GabrieleZoppoli/terrarium-control-system/analysis/README.md

# Terrarium PID Statistical Analysis

Statistical models of the PID-controlled highland cloud forest terrarium.
Generated 2026-02-18.

## Data

- Source: InfluxDB `highland` database, 5-minute aggregates
- Default window: last 14 days
- Run `./export_data.sh [days]` to refresh CSVs before re-running scripts

## Scripts

### 01_pid_humidity_model.py
Four OLS models of terrarium humidity:
- **Model 1**: Static OLS — humidity ~ fan_pwm + temp_in + temp_room + humi_room + freezer + mister
- **Model 2**: Enriched — adds temp_delta, hour, daytime, fan×freezer interaction
- **Model 3**: AR(1) dynamic — adds lagged humidity, computes long-run multipliers
- **Model 4**: First-difference (Δhumidity) — what drives humidity changes

Key finding: fan_pwm shows *positive* association with humidity due to PID simultaneity
(fans increase because humidity is high, not the other way around).

### 02_iv_causal_model.py
IV/2SLS model using Night A/B experiment as instrument:
- Instrument: day-of-year parity (even=fans off, odd=fans at 80 PWM)
- First-stage F=20.6 (strong instrument)
- **Causal estimate: +10 PWM → -0.37% humidity** (sign correctly flips vs OLS)
- Includes reduced-form, Wald estimator, and nightly aggregate comparison

### 03_ab_temperature.py
Night A/B effect on temperature (unadjusted):
- Raw comparison, nightly aggregates, regressions
- Hourly profiles, cooling rate analysis
- Key finding: fans accelerate evening cooling but raise late-night floor

### 04_ab_temperature_adjusted.py
Same as 03 but adjusted for room temperature and humidity:
- Hour-by-hour regressions with controls
- Residualized profiles
- Balance check on room conditions
- **Adjusted: evening cooling -0.75 to -1.4°C, late-night warming +0.3 to +0.55°C**

### heat_balance_rerun.py
Re-run of the heat-balance regression (2026-05-12) over the full 80.3-day
Meross-instrumented window (n=17,773, HC3 robust SEs). Supersedes the earlier
27-day coefficients. Canonical results in `paper/heat_balance_run_2026-05-12.yaml`:
compressor -1.01 °C/hr; passive room↔cabinet +0.17 °C/hr per K; continuous
fan PWM effect statistically null (p=0.33).

### wetbulb_analysis.py / deconvolution.py
Wet-bulb characterization and thermal deconvolution (2026-02-24). Establish the
~16.6 °C evaporative-cooling floor at room 22 °C / 58 % RH.

### cooling_test_report.py / cooling_test_publication.py
Maximum-cooling-capacity test reports (near-equilibrium 13.6 °C at room 21.6 °C,
Δ≈8.1 K; deepest 12.3 °C).

### publication_figures.py
Generates the HardwareX manuscript figures from InfluxDB into `../paper/figures/`:
24 h and 7 d environmental cycles, hour-of-day power profile + ECDF, PID humidity
tracking + fan response, the 11-layer safety-chain deployment timeline, and a
system connection (block) diagram (`fig1`–`fig6`). Uses only stdlib + numpy +
matplotlib; re-run any time. `fig6` is drawn from the documented architecture
(no InfluxDB) — a signal/power connection map, not a full electrical schematic.

**Note on the IV/2SLS coefficient:** the canonical (SoT-corrected) causal estimate
is **−0.34 % RH per +10 PWM** (95 % CI −0.68 to −0.005; p=0.047; n=1,353), per
`paper/stats_sot_2026-05-13.yaml`. The "−0.37 %" quoted under `02_iv_causal_model.py`
above is the original first-run value, retained here for script provenance; cite the
SoT value in any publication.

## Dependencies

```bash
pip3 install --break-system-packages pandas statsmodels linearmodels scipy
```

## Usage

```bash
cd ~/terrarium-analysis
./export_data.sh          # refresh data (optional days arg, default 14)
python3 01_pid_humidity_model.py
python3 02_iv_causal_model.py
python3 03_ab_temperature.py
python3 04_ab_temperature_adjusted.py
```

Results are saved in `results/` as text files.
