GabrieleZoppoli/terrarium-control-system/website/content/collection/species/calopogon-tuberosus/index.md

---
# AUTO-GENERATED — do not edit by hand.
# Rerun scripts/generate_species_pages.py after inventory changes.
# For rich prose, drop a body.md in this folder; the template appends it.
title: Calopogon tuberosus
taxon: Calopogon tuberosus
genus: Calopogon
species: tuberosus
provenance: Eastern North American sphagnum bogs
slug: calopogon-tuberosus
sources:
  - id: 30
    vendor: Gartenbau Carow
    acquired: May 2019
    price_eur: 38.8
    location: Balcony · outdoor
photos:
  - img/collection/calopogon/calopogon-tuberosus.jpg
primary_photo: img/collection/calopogon/calopogon-tuberosus.jpg
genus_page: /collection/genera/other-orchids/
---
