GabrieleZoppoli/terrarium-control-system/website/content/collection/species/pinguicula-laueana-crimson-flower/index.md

---
# AUTO-GENERATED — do not edit by hand.
# Rerun scripts/generate_species_pages.py after inventory changes.
# For rich prose, drop a body.md in this folder; the template appends it.
title: "Pinguicula laueana 'Crimson Flower'"
taxon: "Pinguicula laueana 'Crimson Flower'"
genus: Pinguicula
species: laueana
provenance: ""
slug: pinguicula-laueana-crimson-flower
sources:
  - id: 399
    vendor: Diflora
    acquired: Mar 2026
    price_eur: 13
    location: Fog shelves
photos:
  - img/collection/pinguicula/pinguicula-laueana-crimson-flower.jpg
primary_photo: img/collection/pinguicula/pinguicula-laueana-crimson-flower.jpg
genus_page: /collection/genera/pinguicula/
---
