GabrieleZoppoli/terrarium-control-system/website/content/collection/species/utricularia-quelchii/index.md

---
# AUTO-GENERATED — do not edit by hand.
# Rerun scripts/generate_species_pages.py after inventory changes.
# For rich prose, drop a body.md in this folder; the template appends it.
title: Utricularia quelchii
taxon: Utricularia quelchii
genus: Utricularia
species: quelchii
provenance: "Tepui cliffs, Venezuela — epiphytic Utricularia"
slug: utricularia-quelchii
sources:
  - id: 429
    vendor: Klein Carnivors
    acquired: Feb 2023
    price_eur: 38
    location: Highland cabinet
    notes: "Ilu Tepui provenance; currently flowering, April 2026"
photos:
  - img/collection/utricularia/utricularia-quelchii.jpg
primary_photo: img/collection/utricularia/utricularia-quelchii-15.jpg
genus_page: /collection/genera/utricularia/
---
