GabrieleZoppoli/terrarium-control-system/website/content/collection/species/tillandsia-love-knot/index.md

---
# AUTO-GENERATED — do not edit by hand.
# Rerun scripts/generate_species_pages.py after inventory changes.
# For rich prose, drop a body.md in this folder; the template appends it.
title: "Tillandsia 'Love Knot'"
taxon: "Tillandsia 'Love Knot'"
genus: Tillandsia
species: ""
provenance: ""
slug: tillandsia-love-knot
sources:
  - id: 436
    vendor: Le Figlie del Vento
    acquired: May 2026
    price_eur: 12.5
    location: ""
    notes: Orticola 2026 — cv hybrid (T. paucifolia × T. streptophylla) — bundle 50€/4 pz Camarda
photos:
  - img/collection/tillandsia/tillandsia-love-knot.jpg
primary_photo: img/collection/tillandsia/tillandsia-love-knot.jpg
genus_page: /collection/genera/tillandsia/
---
