GabrieleZoppoli/terrarium-control-system/website/content/collection/species/cymbidium-goeringii-tian-cao/body.md

## The cultivar

*Cymbidium goeringii* '**Tian Cao**' (天草, Japanese reading **Amakusa**) is a Japanese-line goeringii from the city of Amakusa in Kumamoto Prefecture. Compact habit, cream-margined foliage variegation that runs from edge to near the leaf tip, fragrant flowers — the variegation rule on goeringii is that any plant with leaf variegation will also produce flower variegation, so the spike colour is non-uniform.[^slippertalk]

Acquired at Orticola 2026 from **Marco Toffoletti / Piante Pazze** (stand 27) on 2026-05-09 — substituted on the day for the pre-ordered 'Da Tu Yuan' clone, which Marco didn't have in dividable shape that morning.

## Growing it

Goeringii is the picky Cymbidium. Two non-negotiables: **cold dormancy with vernalisation** and a **mineral / aerated substrate**.

- **Substrate.** Hyuga pumice ~50%, Kanuma ~30%, perlite + hard pumice ~20%. Particles graded by size — coarse at the bottom, fine at the surface, with a small mound around the pseudobulb base.[^aos]
- **Pot.** Translucent or asian-style tall-narrow lets you read the moisture front at each layer. Black plastic is fine functionally; translucent is the diagnostic upgrade.
- **Watering.** Soak the pot for ~10 s with a fine spray, then let the surface mound dry out before the next thorough water. Mist between thoroughs to keep the upper third damp without flushing through. No watering during freezing weather.[^aos]
- **Vernalisation.** From the winter solstice through bud development, hold the plant at **0–14 °C** for several weeks. *Without this cold period the buds blast.* This is the single most common reason cultivated goeringii never flower in mild climates.[^orchidboard]
- **Light.** As much sun as possible up to ~40 °C. Partial shade in summer if leaf scorch shows.
- **Air movement.** Continuous gentle airflow. Goeringii roots pack densely in pots and stagnant air invites fungal/bacterial rot at the base.[^aos]
- **Repotting.** Twice a year (spring before active growth; autumn for health check) is the Asian standard. Every two to three years works in milder regimes.[^aos]
- **Fertiliser.** Light, with the growth flush; off during dormancy.

## Why bother

The genus is large; this species is the one that earned a thousand-year cultivation tradition in China and Japan. Variegated cultivars like Tian Cao were prized in Edo-period Japan for the foliage as much as the flower, and the named-cultivar lineage continues today with strict provenance.

## References

- **AOS — *Cymbidium goeringii: Essential Tips for Success*.** [aos.org/orchids/articles/cymbidium-goeringii-essential-tips-for-success](https://www.aos.org/orchids/articles/cymbidium-goeringii-essential-tips-for-success). Substrate recipe, watering, vernalisation regime.
- **Slippertalk — *Cymbidium goeringii 'Tian Cao'*.** [slippertalk.com/threads/cymbidium-goeringii-tian-cao.36936](https://www.slippertalk.com/threads/cymbidium-goeringii-tian-cao.36936/). Cultivar-specific variegation pattern, fragrance notes.
- **Reddit — *r/orchids* "I got a little companion for my neofinetias"** (Italian-language thread, 2021). [reddit.com/r/orchids/.../oujzbe](https://www.reddit.com/r/orchids/comments/oujzbe/i_got_a_little_companion_for_my_neofinetias/). Italian grower notes on cabinet companion-planting with *Neofinetia*.
- **Orchid Board — *Cymbidium goeringii 'Tian Cao'*.** [orchidboard.com/.../67274-cymbidium-goeringii-tian-cao](http://www.orchidboard.com/community/cymbidium-alliance/67274-cymbidium-goeringii-tian-cao.html). Vernalisation specifics, cold-blast warning.

[^slippertalk]: Slippertalk Orchid Forum — *Cymbidium goeringii 'Tian Cao'*, thread #36936. The variegation-implies-flower-variegation rule, Amakusa origin.
[^aos]: American Orchid Society — *Cymbidium goeringii: Essential Tips for Success*. Substrate composition (50% Hyuga pumice / 30% Kanuma / 20% perlite + hard pumice), watering protocol, repotting cadence, air-circulation prescription.
[^orchidboard]: Orchid Board — *Cymbidium goeringii 'Tian Cao'*, cymbidium alliance forum. The 0–14 °C vernalisation period from winter solstice and the bud-blast failure mode without it.
