GabrieleZoppoli/terrarium-control-system/website/content/areas/_index.it.md

---
title: "Dove vivono"
description: "Le cinque aree di coltivazione: balcone, davanzale, ripiani nebulizzati, terrario d'alta quota e mini-stagni."
---

Cinque aree di coltivazione ospitano la collezione. Ognuna ha un suo intervallo di luce, temperatura e umidità, e quindi le sue piante.
