GabrieleZoppoli/terrarium-control-system/website/content/areas/_index.md

---
title: "Where they live"
description: "The five growing areas: balcony, windowsill, fog shelves, highland terrarium and mini-ponds."
---

Five growing areas host the collection. Each has its own range of light, temperature and humidity, and therefore its own plants.
