GabrieleZoppoli/terrarium-control-system/website/content/areas/windowsill.it.md

---
title: "Davanzale"
area_slug: "windowsill"
description: "Piante da interno amanti della luce sui davanzali: temperature stabili, umidità media."
---
