GabrieleZoppoli/terrarium-control-system/website/content/areas/windowsill.md

---
title: "Windowsill"
area_slug: "windowsill"
description: "Indoor light-loving species on windowsills: stable temperatures, moderate humidity."
---
