GabrieleZoppoli/terrarium-control-system/website/content/highland/docs/_index.md

---
title: "Technical Documentation"
description: "Architecture, schemas, PID controller, and flow guides"
showTableOfContents: true
---

Technical documentation for the terrarium control system: architecture, data schema, control algorithms and Node-RED flow structure.

## Contents

- **[Architecture](architecture/)**: system overview, hardware layers, communication protocols
- **[InfluxDB Schema](schema/)**: all 32 measurements logged by the system
- **[PID Controller](pid-controller/)**: gain-scheduled PID algorithm with three-regime fan control
- **[Node-RED Flows](flows/)**: flow import guide and tab-by-tab description
