GabrieleZoppoli/terrarium-control-system/website/content/inventions/zeer-pot-darlingtonia/index.it.md

---
title: "Zeer pot auto-annaffiante per Darlingtonia"
description: "Raffreddamento evaporativo passivo per la zona radicale della pianta cobra californiana"
status: "building"
layout: "zeer-pot"
weight: 10
tags: ["carnivora", "invenzione", "esp32"]
---

*Darlingtonia californica*, la pianta cobra californiana, vuole radici fredde e tollera aria calda. In habitat, sorgenti sotterranee mantengono il rizoma sotto i ~18 °C anche quando l'aria tocca i 30 °C. La soluzione classica da hobbista è un getto quotidiano di acqua fredda o cubetti di ghiaccio in estate, che fallisce il giorno in cui te ne dimentichi.

Uno Zeer pot (raffreddatore evaporativo a doppio vaso) fa quello che fa la sorgente: l'acqua che evapora dalla superficie esterna non smaltata sottrae calore alla camera interna. Con un serbatoio a ricarica autonoma, una coppia di termistori, una sonda capacitiva per l'umidità del terriccio e un ESP32-C3 SuperMini, l'assemblaggio funziona senza intervento per un mese di fila.

Il progetto completo (schizzi CAD, cablaggio, firmware, lista dei materiali, sequenza di costruzione) è qui sotto, come pagina autonoma nei colori del sito. Conviene aprirla a schermo intero.
