GabrieleZoppoli/terrarium-control-system/website/content/inventions/zeer-pot-darlingtonia/index.md

---
title: "Self-watering Zeer Pot for Darlingtonia"
description: "Passive evaporative cooling for the California Pitcher Plant's root zone"
status: "building"
layout: "zeer-pot"
weight: 10
tags: ["carnivorous", "invention", "esp32"]
---

*Darlingtonia californica*, the California pitcher plant, needs cold roots and tolerates warm air. In habitat, underground springs keep the rhizome below ~18 °C even when the air reaches 30 °C. The usual hobbyist solution is a daily flush of cold water or ice cubes in summer, which fails on the day you forget.

A Zeer pot (a pot-in-pot evaporative cooler) does what the spring does: water evaporating from an unglazed outer surface pulls heat out of the inner chamber. With a self-topping water reservoir, a pair of thermistors, a capacitive soil probe and an ESP32-C3 SuperMini, the assembly runs unattended for a month at a time.

The full project (CAD sketches, wiring, firmware, bill of materials, build sequence) is below, as a self-contained page in the site's colours. Open it full-screen for comfort.
