GabrieleZoppoli/terrarium-control-system/website/content/blog/first-bloom-utricularia-quelchii/index.md

---
title: "First bloom: Utricularia quelchii, three years in"
date: 2026-04-20
description: "A tepui bladderwort I've been growing since 2023 finally flowers, and I only notice by accident while checking the Sophronitis above it."
tags: ["utricularia", "terrarium", "flowering", "first-bloom"]
showReadingTime: true
---

I wasn't looking for it. Last week I was leaning into the highland cabinet to check on my *Sophronitis coccinea* hanging above, and through its roots I caught a thin red peduncle climbing out of the pot underneath. *Utricularia quelchii*. Three years in cultivation, steadily adding leaves and nothing else — until, suddenly, at least two buds, red-purple, the stem erect in that *reniformis* family posture but smaller and more hesitant.

{{< figure src="/img/collection/utricularia/utricularia-quelchii.jpg" caption="The first catch: two buds on the same erect peduncle, red-purple, framed against the cabinet wall between the *Sophronitis* roots hanging from above." >}}

{{< figure src="/img/collection/utricularia/utricularia-quelchii-2.jpg" caption="The larger of the two buds, closer in. The lower-lip sac is already well-formed; the colour is a dense red-purple against the cabinet's white wall." >}}

{{< figure src="/img/collection/utricularia/utricularia-quelchii-3.jpg" caption="The second bud, still small and pointed, sitting lower on the peduncle." >}}

{{< figure src="/img/collection/utricularia/utricularia-quelchii-6.jpg" caption="Both buds together on the same peduncle, pulled back to show the tangle of *Sophronitis* aerial roots they had to thread through." >}}

{{< figure src="/img/collection/sophronitis/sophronitis-coccinea-big-one-x-hinomaru-4n-gmwoc-2.jpg" caption="The *Sophronitis coccinea* 'Big One' × 'Hinomaru' 4N GM/WOC flower — the whole reason I was leaning into the cabinet last week." >}}

{{< figure src="/img/highland/interior/interior_2026-04-20_coccinea-bloom.jpg" caption="The whole frame: the *Sophronitis coccinea* is the red spot left-of-centre; the quelchii pot is nestled below it, half-hidden by its own sphagnum overflow. (Also filed on the [terrarium photo timeline](/highland/photos/).)" >}}

## How it got here

Early 2023, from Christian and Claudia Klein at **Carnivors & More**. The label read *Utricularia quelchii, Ilu Tepui*, and the Ilu tag was half the reason I ordered — tepui endemics with a clear cliff-of-origin are what draw me to the genus. It arrived looking exactly like what you'd expect from a bladderwort that evolved on a Guayana-highland summit: a handful of tear-drop leaves — already a couple of centimetres long including the petiole, which is large by bladderwort standards — a few white traps buried in live moss, and an attitude of *we'll see*. That attitude held for three years. The plant never died, the leaves grew slowly but steadily, and by last year the stolons had threaded through the entire pot.

## The setup (in case it's reproducible)

- **Container**: terracotta, perforated, 10 cm diameter.
- **Substrate**: live *Sphagnum* only. The moss has so completely occupied and overflowed the pot that it reads more as a kokedama than as a potted plant.
- **Position**: hanging on the back wall of the highland cabinet, mid-height, with nothing above it on the wall. The light is direct but not the brightest corner — the *Heliamphora* sit about 30 cm from the LED array, that's the full-sun tier; the quelchii is a step below. I'll add the actual lux once I can get the meter in.
- **Watering**: none from me. The pot sits directly under a mister nozzle and the live sphagnum stays evenly damp on its own. Foliar Akerne Orchid Mix at half a teaspoon per three litres, a couple of times a month.

The detail I find most interesting: the flower spike emerged not from the wetter body of the pot but from the driest 2 cm that sit against the cabinet wall. Whatever cue a *quelchii* needs to bloom, it may not be continuous saturation.

## Why I care

Deep-red flowers are rare in *Utricularia* and essentially a Pantepui specialty: *U. quelchii* and *U. campbelliana* sit alone at that end of the colour range within the section *Orchidioides*, both confined to the summit-mat bogs of Roraima, Ilu-Tramen, Wei, Chimantá, and neighbouring table-mountains of the Venezuelan Guayana Highlands ([Taylor, 1989](#references)). The other red one I have is *U. campbelliana*, also Ilu-sourced, also in live sphagnum, slow as hell for three years, also not yet in flower. The flower colour alone makes *quelchii* a collector's plant; the tear-drop leaves — large for the genus, and sometimes reddish themselves — are the second hook.

{{< figure src="/img/collection/utricularia/utricularia-quelchii-4.jpg" caption="Top-down over the pot. The dark teardrop on the sphagnum isn't a bud — it's one of those purple-tinged leaves, just about the darkest I have on the plant right now." >}}

{{< figure src="/img/collection/utricularia/utricularia-quelchii-5.jpg" caption="A macro of the same kind of leaf resting on the moss surface. The reddish pigmentation runs through the whole lamina; the texture of the live *Sphagnum* underneath gives the scale." >}}

I hadn't expected a bloom. The plant arrived with three or four leaves and now has many; the rosette slowly but steadily kept growing. But growth that stays pure vegetative starts to look like a contract — *I'll live here, I'll take up space, I won't flower*. Three years of that can be easy to accept. Turns out the plant had been setting up all along.

## What comes next

I'll update this post as the spike opens and once I can get a lux meter into that position to replace the eyeball estimate.

## Update — 2026-05-07: the first flower is open

Seventeen days from the first photos, the larger bud has opened and the section *Orchidioides* gestalt is unmistakable: a hooded galea above, a yellow-cream throat with two red callus blotches inside, and a broad lower lip that pales from the magenta of the hood to white-pink at the edges. The second bud is still closed, slightly below.

{{< figure src="/img/collection/utricularia/utricularia-quelchii-7.jpg" caption="The bud cracking open. The lower lip is just starting to peel away from the galea — the glossy red-purple is at peak saturation right before the corolla unfolds." >}}

{{< figure src="/img/collection/utricularia/utricularia-quelchii-10.jpg" caption="Side profile of the open flower. The galea forms a dark hood; the yellow-cream gullet is visible underneath, and the lower lip extends forward — the structure that mimics an orchid corolla closely enough to fool sphingid pollinators on the tepui summits." >}}

{{< figure src="/img/collection/utricularia/utricularia-quelchii-9.jpg" caption="Three-quarters view, with the second (still-closed) bud visible below. The yellow-cream of the throat is a clean contrast against the magenta hood and the cooler-pink lip." >}}

{{< figure src="/img/collection/utricularia/utricularia-quelchii-11.jpg" caption="Head-on. The two dark blotches inside the throat are the callus markings that section *Orchidioides* shares — they sit at the base of the column and presumably function as nectar guides." >}}

{{< figure src="/img/collection/utricularia/utricularia-quelchii-13.jpg" caption="Macro of the open face. The greenish column projects forward through the throat; the magenta venation on the lower lip catches the cabinet light." >}}

The plant is still in the same hanging position, same sphagnum kokedama, same mister nozzle overhead. Lux meter still pending. The colour is closer to cool magenta than the deep blood-red the photographs in Taylor (1989) hint at — possibly clone variation, possibly light-driven. I'll see whether the second bud opens darker or paler than the first.

## Update — 2026-05-11: both flowers open

Day 21. The second bud has caught up — both flowers are now face-out on the same scape. Colour is uniform across both: same magenta hood, same yellow-cream throat, same pink lower lip. No shift toward the deep red of the Roraima phenotype on the second flower; this clone is reliably Ilu pink.

{{< figure src="/img/collection/utricularia/utricularia-quelchii-14.jpg" caption="Both flowers open on the same scape. The kokedama and the surrounding cabinet planting are visible in the background." >}}

{{< figure src="/img/collection/utricularia/utricularia-quelchii-16.jpg" caption="Macro into the throat of the second flower. The yellow callus and column structure read identically to the first." >}}

## References

- **Taylor, P.** (1989). *The Genus Utricularia — A Taxonomic Monograph*. Kew Bulletin Additional Series XIV. Royal Botanic Gardens, Kew. The definitive treatment of the genus; the key to sect. *Orchidioides* (pp. 42–59) is where the *quelchii*/*campbelliana* characters live.
- **Fleischmann, A.** (2012). *Monograph of the genus Genlisea*. Redfern Natural History Productions. Not about *Utricularia* per se, but the accompanying material on Pantepui biogeography is useful context for the highland-epiphytic bladderworts.
- **Huber, O.** (1995). *Geographical and physical features of the Pantepui*, in: Berry, P.E., Holst, B.K., Yatskievych, K. (eds.), *Flora of the Venezuelan Guayana, Vol. 1*. St. Louis: Missouri Botanical Garden Press. On the tepui summit habitat the section *Orchidioides* species evolved in.
