GabrieleZoppoli/terrarium-control-system/website/content/collection/genera/dracula/index.md

---
title: "Dracula & Masdevallia"
description: "Cloud forest orchids from the Colombian and Ecuadorian Andes"
tags: ["orchid", "pleurothallidinae", "andes"]
genera: ["Dracula", "Masdevallia"]
ogImage: "img/collection/dracula/dracula-pholeodytes.jpg"
---

## Overview

*Dracula* and *Masdevallia* orchids inhabit the mossy cloud forests of the Colombian and Ecuadorian Andes at 1,500--2,500 m elevation. *Dracula* flowers, often face-like, hang from pendulous inflorescences that emerge below the mount; the mushroom-like lip attracts fungus gnats, which pollinate them.

## Position in Terrarium

**Lower zone**: shade, the lowest light in the cabinet. In nature they grow in the forest understorey under heavily filtered light.

## Mounting

Cork bark with a sphagnum moss pad. *Dracula* mounted with inflorescences able to hang freely below.

## Dracula

{{< collection-species "Dracula" >}}

## Masdevallia

{{< collection-species "Masdevallia" >}}

## Cultivation notes

*Dracula* has kept a perfect survival record (6/6) here, while *Masdevallia* sits at 71 % (5/7). The two losses, *M. glandulosa* and *M. coccinea* 'Anchota', were both plants from the warmer, lower edge of cloud forest; both struggled to make new growth under the terrarium's cool nights and were probably in the wrong place rather than badly grown. The rest live mounted on cork with a pad of living sphagnum and produce new leaves on a roughly three-month cycle.

Notes from provenance:

- **D. simia**: flowers singly on pendulous inflorescences that come down out of the sphagnum mat; the photographs on this site catch the flower as it drops through the mount.
- **D. lotax**: a very small cool grower, kept with the *Masdevallia* in the same zone.
- **D. Raven 'Jet'**: a hybrid of *D. vampira* × *D. roezlii*. Flowers very dark, almost black, with the white callus glands of *vampira* reduced.
- **D. "Fake" hirsuta 'Yellow'**: acquired as *hirsuta*, but the flower looks more like *hirsuta* f. *xanthina*. Kept as a label-uncertain accession until it flowers a second time.

Flowering is near-continuous across the group in autumn and winter, slows through summer, and does not respond much to anything I have tried. One consistent observation: *Masdevallia* spike production tracks the night minimum, not the daytime maximum. A 3 °C change in the overnight setpoint is worth more than twice that during the day.

## Photos

{{< collection-photos "Dracula" >}}

{{< collection-photos "Masdevallia" >}}
