GabrieleZoppoli/terrarium-control-system/website/content/collection/genera/platycerium/index.md

---
title: "Platycerium"
description: "Staghorn ferns (Platycerium, Polypodiaceae)"
tags: ["fern"]
genera: ["Platycerium"]
---

## Overview

Staghorn ferns (*Platycerium*, Polypodiaceae), epiphytes grown mounted.

## Species in Collection

{{< collection-species "Platycerium" >}}

## Photos

{{< collection-photos "Platycerium" >}}
