GabrieleZoppoli/terrarium-control-system/website/content/collection/genera/sophronitis/index.md

---
title: "Cattleya, Sophronitis & Laelia"
description: "Miniature rupicolous orchids from the Brazilian Atlantic Forest highlands"
tags: ["orchid", "cattleya", "sophronitis", "laelia", "brazil"]
genera: ["Cattleya", "Sophronitis", "Laelia"]
ogImage: "img/collection/sophronitis/sophronitis-coccinea-4n.jpg"
---

## Overview

The former genera *Sophronitis* and *Laelia* (now subsumed into *Cattleya* sensu lato) comprise miniature rupicolous (rock-dwelling) orchids from the highlands of the Brazilian Atlantic Forest, particularly the *campos rupestres* at 800--2,000 m. They are prized for their vivid red, orange, and yellow flowers on compact plants rarely exceeding 5 cm.

## Position in Terrarium

**Upper to middle zone**: moderate to high light. In nature these grow on exposed rock faces or as epiphytes on the windward side of stunted trees.

## Mounting

Cork bark mounts. The compact rosette habit and wiry roots adapt well to mounted culture.

## Cattleya

{{< collection-species "Cattleya" >}}

## Sophronitis

{{< collection-species "Sophronitis" >}}

## Laelia

{{< collection-species "Laelia" >}}

## Additional Brazilian Miniatures

| # | Taxon | Vendor | Price | Notes | Status |
|---|---|---|---|---|---|
| 1 | *Leptotes bicolor* | Orchideria di Morosolo | EUR 15.00 | Mounted | Alive |
| 2 | *Isabelia pulchella* | Varesina Orchidee | EUR 24.00 | Mounted | Alive |

**Total invested**: ~EUR 535

## Cultivation notes

Combined survival rate: 77 % (10 of 13). The double loss of *S. pygmaea*, the smallest species in the genus, points to a limit: the plant is too small and too slow to forgive a root-moisture error lasting 48 hours. The larger *Sophronitis* and all the *Cattleya*, including *S. coccinea* **f. aurea ('Atsumi' × 'Perfection'), an SM/JOGA selection from Japan**, have done well. *L. briegeri* was lost in transport (a CITES shipment from Ecuador that arrived already collapsed).

Flowering is reliable and heavy in autumn, often with a lighter second flush in spring. Colour saturation tracks the night minimum more than any other variable: the 'Atsumi' × 'Perfection' cross holds a deeper vermilion when kept three degrees cooler at night.

No dry rest is given, and none of the surviving plants have shown the spongy, hollow growth associated with over-watered *Sophronitis*, as long as air movement stays strong (a 24 V fan runs continuously at the top of the cabinet) and the cork mount goes from soaking to just-not-dripping between mist cycles.

## Photos

{{< collection-photos "Cattleya" >}}

{{< collection-photos "Sophronitis" >}}

{{< collection-photos "Laelia" >}}
