GabrieleZoppoli/terrarium-control-system/website/content/collection/genera/sphagnum/index.md

---
title: "Sphagnum"
description: "Living sphagnum moss: the ground layer in the terrarium and in the carnivorous-plant pots"
tags: ["moss", "companion"]
genera: ["Sphagnum"]
---

## Overview

Living moss layers in the terrarium and in carnivorous plant pots.

## Species in Collection

{{< collection-species "Sphagnum" >}}

## Photos

{{< collection-photos "Sphagnum" >}}
