GabrieleZoppoli/terrarium-control-system/paper/hardwarex.md

# Weather-Mimicking Terrarium for Cloud Forest Species: An Open-Source Climate Simulation System Using Real-Time Meteorological Data

**Authors**: Gabriele Zoppoli¹·² (ORCID: 0000-0002-1619-1708)

¹ Department of Internal Medicine and Medical Specialties (DiMI), University of Genoa, Genoa, Italy
² IRCCS Ospedale Policlinico San Martino, Genoa, Italy

**Corresponding author**: gabriele.zoppoli@unige.it

---

## Specifications Table

| | |
|---|---|
| **Hardware name** | Weather-Mimicking Biotope (WMB) — Cloud Forest Terrarium Controller |
| **Subject area** | Environmental science and ecology; Biological sciences (botany, conservation); Engineering (control systems) |
| **Hardware type** | Environmental monitoring and control |
| **Closest commercial analogue** | Terrarium controllers (MistKing HygroStat, TerraControl Pro); growth chambers (Percival, Conviron) |
| **Open-source license** | CERN Open Hardware Licence v2 — Strongly Reciprocal (CERN-OHL-S-2.0) |
| **Cost of hardware** | ≈ €2,865 (≈ US$3,050); itemised, mostly receipt-sourced BOM in §4 |
| **Source file repository** | GitHub: https://github.com/GabrieleZoppoli/terrarium-control-system; archival Zenodo DOI assigned at deposit |

---

## Abstract

We present the design, construction, and four-year validation of an open-source weather-mimicking terrarium system that simulates highland cloud-forest climates using real-time meteorological data. The system ingests current weather from four Colombian highland cities (1,300–2,600 m elevation) and applies a 15-hour backward lookup against the locally archived time-series to generate continuously varying temperature and humidity setpoints. Combined with the 7-hour Italy-to-Colombia time-zone offset, the shift produces a phase-aligned daily cycle in which Colombian afternoon highs drive cabinet warmth at Italian midday and Colombian pre-dawn lows drive cabinet cooling at Italian midnight — reproducing the stochastic weather of tropical montane environments without inverting the day/night cycle. The enclosure is a ~1 m³ acrylic cabinet (1.5 × 0.6 × 1.1 m), and a dynamic photoperiod derived from the Colombian reference latitude (~5°N) drives a raised-cosine LED schedule (Light Curve C, deployed 2026-05-04) that provides seasonally varying day length and a +23 % daily-integrated-PAR uplift over the prior step schedule. The control system — built entirely on open-source software (Node-RED, InfluxDB, Grafana) running on a Raspberry Pi with an Arduino Mega for hardware I/O — implements a two-regime PID fan-control strategy (humidity-driven below 24 °C, temperature-driven at or above 24 °C, with the temperature-driven regime persisting through compressor engagement so that fans continue to act as a ceiling-defence cooling actuator). An instrumental-variables (2SLS) characterisation of the fan-to-humidity loop quantifies the causal effect of fan PWM on cabinet humidity at −0.34 % RH per +10 PWM units (95 % CI: −0.68 to −0.005; p = 0.047; n = 1,353), and a heat-balance regression over 80.3 days at 5-min cadence (n = 17,773; HC3 robust SEs) attributes the cooling work to the marine compressor (−1.01 °C/hr when active) with fan PWM showing no statistically detectable sensible-heat effect. An eleven-layer safety chain, evolved reactively in response to specific in-production failure modes and audited against a three-class detector-fragility taxonomy (dependency-loop / state-desync / stale-input-latch), handles operator and hardware failure modes. The system has operated continuously since May 2022 (four years at time of writing) at a measured power draw of **2.63 kWh/day (~€288/year at €0.30/kWh)**, currently maintaining **75 living accessions across 31 plant genera** drawn from three biogeographic provinces of the convergent cloud-forest biome (Neotropical highlands: Guayanan tepui, Andes, Brazilian Atlantic Forest; Southeast Asian highlands; Papua New Guinea / Oceania). All design files, control flows, firmware, dashboards, and analysis scripts are released under the CERN Open Hardware Licence v2 Strongly Reciprocal (CERN-OHL-S-2.0). Live cabinet conditions, build photographs, and operational logs are maintained at a companion website [21] (citable Zenodo DOI assigned at deposit); companion papers describe the horticultural results for carnivorous plants [18] and orchids [19], and the conservation/freeware-flagship synthesis appears in [20].

**Keywords**: open-source hardware, cloud forest terrarium, weather simulation, PID control, instrumental variables, causal inference, Node-RED, environmental monitoring, Raspberry Pi

---

## 1. Hardware in Context

Highland cloud forests — particularly the tepui table-top mountains of the Guiana Highlands in Venezuela — harbor extraordinary plant diversity adapted to narrow environmental envelopes: cool temperatures (10–22 deg C), persistent high humidity (80–100% RH), frequent fog immersion, and moderate light filtered through clouds [1]. Cultivating these species outside their native range presents formidable challenges, especially in climates with hot, dry summers.

Traditional terrarium controllers rely on fixed environmental setpoints (e.g., 18 deg C day / 14 deg C night, 90% RH constant), which fail to capture the stochastic variability that characterizes cloud forest environments. Natural tepui climates exhibit weather-driven fluctuations: sudden temperature drops during rain events, diurnal fog cycles, and seasonal variation in cloud cover. Static control oversimplifies the environment and may fail to provide the thermal and humidity cues that cloud forest species require for phenological processes.

Commercial terrarium controllers such as the MistKing HygroStat and similar products provide basic hysteresis control of humidity and temperature, but none ingest real-time weather data to produce dynamic setpoints. At the other end of the spectrum, laboratory growth chambers (Percival, Conviron) offer precise environmental control at costs of EUR 10,000–50,000+, with proprietary software that limits customization and data access.

A number of open-source environmental control systems have been described in HardwareX and adjacent venues, providing relevant reference designs but stopping short of the weather-mimicking concept. McDowell et al. (2021) [4] describe an internet-connected temperature controller for plant-growth experiments, providing a clean open-hardware template for sensor + actuator + remote-management but with fixed-setpoint control. Lau & Subbiah (2020) [5] present HumidOSH, a self-contained environmental chamber with relative-humidity and fan-speed control, focused on a single bench-top humidity envelope rather than diurnal or weather-driven variation. Sánchez et al. (2020) [6] document OpenTCC, a low-cost open-source temperature-control chamber demonstrating that compressor or Peltier hardware can be controlled cleanly from an open stack, again with fixed setpoints. Yuan et al. (2022) [7] develop an IoT framework for feedback control of photosynthetic activity in *Arabidopsis* — the closest conceptual prior art, since it closes a control loop on a biological signal rather than a programmed schedule, but it does not ingest external weather data. Iucci et al. (2026) [8] describe a compact modular hydroponic greenhouse with environmental sensing and control, aimed at production rather than ex-situ conservation of native-climate species. Weather-informed control has a longer history in commercial horticulture — Chalabi et al. (1996) [22] generate optimal greenhouse heating setpoints from meteorological-office *forecasts*, and recent building-control work synthesises deliberately stochastic HVAC setpoint trajectories for dataset diversity [23] — but in both cases the external or synthetic data optimises operation against the cultivation site's *own* local climate rather than reconstructing the climate of a *remote* biome, and neither applies a time-zone phase correction. To our knowledge, **no published open-source system ingests real-time meteorological data from a geographically distinct reference site and applies a time-zone-aware phase shift to drive continuously varying environmental setpoints that reproduce a remote biome's diurnal climate envelope**, which is the gap the present design fills for terrarium-scale ex-situ conservation of cloud-forest taxa.

The system described here addresses this gap through six key innovations:

1. **Weather-mimicking from real meteorological data**: Real-time data from four Colombian highland cities generates stochastic, continuously varying setpoints that reproduce natural weather dynamics, including rain events and seasonal variation. When the live pipeline is stale (>10 min since last successful refresh), the controller transparently substitutes a 14-day rolling historical curve that itself is rebuilt every six hours from the InfluxDB archive, so the fallback follows seasonal drift without operator intervention.

2. **Two-regime PID fan control with ceiling-defence cooling**: The controller adapts its error signal based on cabinet temperature: humidity-driven below 24 °C, temperature-driven at or above 24 °C. The temperature-driven regime persists through compressor engagement — fans continue to act as an active ceiling-defence cooling actuator throughout the day even when the marine refrigerator is running, rather than being relinquished to the compressor.

3. **Causal characterisation of fan-mediated humidity control**: A randomised A/B fan-schedule experiment (n = 1,353 nighttime 5-min observations) enables an instrumental-variables (2SLS) estimate of the fan-PWM-to-humidity coefficient that is decorrelated from the PID's reaction to humidity disturbances. The companion 80.3-day heat-balance regression (n = 17,773; HC3) attributes essentially all the cooling work to the marine compressor and treats fan PWM as the humidity actuator — published quantification rather than a tuning heuristic.

4. **Dynamic photoperiod with raised-cosine LED schedule**: Day length is computed daily from the weather-source latitude, clamped to a biologically reasonable 10–14 h envelope, and bounds a raised-cosine LED brightness curve (Light Curve C, deployed 2026-05-04) centred on the source-latitude solar noon. Sinusoidal/raised-cosine diurnal light profiles are established good practice in controlled-environment horticulture — they approximate natural sunlight better than square-wave schedules and improve photosynthetic efficiency at equal daily light integral [24, 25]; the contribution here is not the curve shape but its derivation from the *weather-source* latitude and its integration with the weather-mimicking pipeline. The curve delivers a +23 % daily-integrated-PAR uplift over this system's prior step-schedule design and produces a smoother diurnal radiant load that the cooling chain can track without on/off transients at lights-on and lights-off.

5. **Eleven-layer safety chain with documented evolution + detector-fragility taxonomy**: Independent safety layers (door interlock, mister duration failsafe, freezer daytime gate, wet-bulb fan-off gate, manual-override timeout, USB-serial watchdog, LED-fault watchdog, power-vs-commanded cross-check, weather staleness fallback, Pi↔Arduino serial-link CRC integrity, mister water-level gate) accumulated over four years of operation in response to specific in-production failure modes. The deployment dates and incident provenance for each layer are recorded in a paper-bound single-source-of-truth YAML (`paper/safety_chain_deployment_dates.yaml`). A three-class detector-fragility taxonomy (dependency-loop, state-desync, stale-input-latch) audits each layer's failure modes against the others.

6. **Complete open-source stack**: All hardware and software components use freely available, commodity parts, making the system reproducible by hobbyists and small institutions. A live companion website (citable Zenodo DOI assigned at deposit) hosts current cabinet readings, photographic build documentation, and the operational blog.

---

## 2. Hardware Description

The Weather-Mimicking Biotope (WMB) is an acrylic terrarium with integrated cooling, humidification, lighting, and ventilation, controlled by a Raspberry Pi running Node-RED with an Arduino Mega for hardware I/O. The system continuously adjusts environmental conditions based on real-time weather data from Colombian highland cities, simulating the stochastic climate of tropical cloud forests.

Applications for researchers and educators include:

- **Ex-situ conservation**: Maintaining cloud-forest species from multiple biogeographic regions in a single enclosure, validated over four years with 75 living accessions across 31 plant genera from three biogeographic provinces (Neotropical highlands, Southeast Asian highlands, Papua New Guinea / Oceania)
- **Plant physiology studies**: Comprehensive data logging (33 InfluxDB measurements at 60-second intervals for continuous channels plus event-driven actuator-change logging; 3.1 million data points in the current 1-year retention window) enables analysis of plant responses to naturalistic environmental variation
- **Control systems education**: The system demonstrates PID control with gain scheduling, hysteresis control, multi-regime switching, instrumental-variables causal estimation of an actuator-to-state coupling, and a documented production-grade safety chain in an accessible, visual programming environment (Node-RED)
- **Template for other biomes**: The weather-mimicking architecture can be adapted to any biome by changing the reference weather stations (e.g., fog desert, alpine, lowland tropical) and the photoperiod-source latitude
- **Low-cost alternative to growth chambers**: Total hardware cost is a fraction of commercial growth chambers (€10,000–50,000+ for Percival/Conviron-class equipment), at a measured operational footprint of **2.63 kWh/day (~€288/year at €0.30/kWh)** for environmental control comparable to or superior to those instruments in this application class

---

## 3. Design Files Summary

| File name | File type | Open-source license | Location |
|---|---|---|---|
| `nodered/flows-sanitized.json` | Node-RED flow configuration | CERN-OHL-S-2.0 | GitHub repo; Zenodo at deposit |
| `firmware/arduino-terrarium.ino` | Arduino Mega firmware (C++) | CERN-OHL-S-2.0 | GitHub repo; Zenodo at deposit |
| `grafana/*.json` | Grafana dashboard exports (4 dashboards) | CERN-OHL-S-2.0 | GitHub repo; Zenodo at deposit |
| `scripts/arduino-watchdog.sh` | Serial watchdog script v10 (Bash) | CERN-OHL-S-2.0 | GitHub repo; Zenodo at deposit |
| `systemd/arduino-watchdog.service` | Systemd unit for the watchdog | CERN-OHL-S-2.0 | GitHub repo; Zenodo at deposit |
| `scripts/meross_daemon.py` | Meross MSS310 power-monitor daemon (Python, polled, publishes to MQTT + InfluxDB) | CERN-OHL-S-2.0 | GitHub repo; Zenodo at deposit |
| `systemd/meross-daemon.service` | Systemd unit for the Meross daemon | CERN-OHL-S-2.0 | GitHub repo; Zenodo at deposit |
| `scripts/terrarium-health.py` | Health-monitor cron script (Gmail + WhatsApp alerts; STUCK-RELAY auto-fix; LED-fault watchdog readout) | CERN-OHL-S-2.0 | GitHub repo; Zenodo at deposit |
| `scripts/mister-failsafe.py` | Mister cron failsafe (Tapo plug force-OFF if `on_time > 150 s`) | CERN-OHL-S-2.0 | GitHub repo; Zenodo at deposit |
| `scripts/snapshot-capture.sh` | Snapshot capture for the public companion-site mirror | CERN-OHL-S-2.0 | GitHub repo; Zenodo at deposit |
| `docs/schema.md` | InfluxDB measurement schema (33 measurements) | CERN-OHL-S-2.0 | GitHub repo; Zenodo at deposit |
| `docs/architecture.md` | System architecture documentation, including the layered safety chain | CERN-OHL-S-2.0 | GitHub repo; Zenodo at deposit |
| `docs/pid-controller.md` | PID algorithm documentation (gain schedule, anti-windup, manual-override semantics) | CERN-OHL-S-2.0 | GitHub repo; Zenodo at deposit |
| `analysis/*.py` | Analysis scripts (OLS heat-balance, IV/2SLS causal estimate, wet-bulb characterization, cooling-test reports) | CERN-OHL-S-2.0 | GitHub repo; Zenodo at deposit |
| `paper/energy_sot_*.yaml` | Single-source-of-truth block for the Meross-measured kWh figures cited throughout the manuscript | CERN-OHL-S-2.0 | GitHub repo; Zenodo at deposit |
| `S6-panel-drawings-*.docx` | Acrylic panel technical drawings | CERN-OHL-S-2.0 | GitHub repo; Zenodo at deposit |

**flows-sanitized.json**: Complete Node-RED flow configuration (~435 nodes across 7 tabs) with credentials removed. Covers all control logic: weather integration, PID fan control with two-regime switching, wet-bulb gate, dynamic photoperiod with Light Curve C, door safety, regime-aware mister hysteresis with water-level gate, data logging, and dashboard UI.

**arduino-terrarium.ino**: Custom text-based serial protocol firmware for Arduino Mega 2560. Handles PWM output on 5 channels (25 kHz phase-correct on Timers 1 and 5), door reed switch inputs with interrupt-based reading, heartbeat generation, and status reporting.

**Grafana dashboards**: Four monitoring dashboards — primary operational (temperature, humidity, VPD, actuator status), Colombian weather reference, system performance (PID diagnostics, fan PWM), and A/B experiment historical reference.

**scripts/arduino-watchdog.sh**: Watchdog v10 script monitoring USB connection health at 15-second intervals with four-step health checks and USB sysfs reset recovery.

**scripts/meross_daemon.py**: Long-running Python daemon that polls the Meross MSS310 in-line energy meter (variable cadence 2–120 s) and publishes power readings via MQTT into InfluxDB. Coexists with the older `meross_script.py` (single-shot variant, retained for compatibility); production deployments should use the daemon.

**scripts/terrarium-health.py**: Cron-driven (every 5 min) health monitor that cross-checks Tapo commanded state against Meross measured power, raises green/yellow/red conditions to Gmail + WhatsApp, runs the STUCK-RELAY auto-fix when the freezer is drawing power while commanded off, and reads the NR LED-fault flag. Includes N-sample hysteresis (3 polls) and a 120 s freezer-transition window to suppress poll-skew false positives. Credentials are placeholders in the published file.

**scripts/mister-failsafe.py**: Independent of Node-RED, runs every minute, force-commands the mister Tapo plug OFF if the plug's reported `on_time` exceeds 150 s. Last-resort guard against water damage from a controller hang or stuck relay.

**analysis/**: Python scripts for the published analyses, including the OLS heat-balance regression, the IV/2SLS causal estimate of the fan effect on humidity, the wet-bulb temperature characterization, and the maximum-cooling-capacity test reports.

**Acrylic panel drawings**: Original fabrication specifications for all structural panels (20 panels + 6 triangles + 2022 add-on set) with dimensions, hole positions, and material callouts.

---

## 4. Bill of Materials

> **BOM status (2026-06).** Component names, quantities, descriptions, and material types were cross-checked against §2 Hardware Description and §5 Build Instructions; costs and suppliers were then reconstructed from the author's e-mail order archive. Receipt-confirmed prices are given as exact figures with the vendor and order month; items without a recovered digital receipt (the locally-sourced enclosure materials in §4.6 and four small commodity electronics) are marked "(est.)" and use retail estimates. Per-subsection provenance notes follow each table, and a consolidated cost summary with the total appears after §4.7.

### 4.1 Control Electronics

| Component | Qty | Description | Unit cost | Total cost | Source | Material type |
|---|---|---|---|---|---|---|
| Raspberry Pi 4 Model B (8 GB) | 1 | Main controller (acquired as a starter kit incl. 128 GB microSD, PSU, case, fan) | €153.98 | €153.98 | Amazon.it, 2021-01 | Electronics |
| Arduino Mega 2560 (clone, CP210x USB) | 1 | GPIO interface | €18 (est.) | €18 | retail estimate | Electronics |
| ESP8266 (NodeMCU, ESP-12F) | 1 | Sensor data acquisition | €6.00 | €6.00 | Amazon.it, 2022-05 (3-pack €17.99) | Electronics |
| Sensirion SHT35 (waterproof probe) | 1 | Temperature/humidity sensor | €32.29 | €32.29 | Amazon.it, 2022-01 | Electronics |
| HC-SR04P ultrasonic sensor | 1 | Water level monitoring | €5 (est.) | €5 | retail estimate | Electronics |
| IRF520N MOSFET driver module | 4 | Fan power switching | €1.40 | €5.60 | Amazon.it, 2020-11 (10-pack €13.99) | Electronics |
| Magnetic reed switch | 2 | Door sensors | €3 (est.) | €6 | retail estimate | Electronics |
| TP-Link Tapo P100 smart plug | 3 | Mains switching (lights, mister, compressor) | €9.90 | €29.70 | Amazon.it, 2021-12 | Electronics |
| Meross MSS310 smart plug | 1 | Energy monitoring | €37.22 | €37.22 | Amazon.it, 2024-01 | Electronics |
| MicroSD card (128 GB) | 1 | Pi storage | — | (bundled in Pi kit) | Amazon.it, 2021-01 | Electronics |
| USB hub (powered) | 1 | Arduino + ESP connections | €20 (est.) | €20 | retail estimate | Electronics |

*§4.1 provenance:* all prices except the four small commodity items (Arduino Mega clone, HC-SR04P, reed switches, USB hub) are receipt-confirmed from the author's order history. The Raspberry Pi was acquired as an 8 GB starter kit (board + 128 GB microSD + PSU + case + fan, €153.98), so the microSD is bundled rather than a separate line. The 8 GB board is confirmed against the running hardware (`Raspberry Pi 4 Model B Rev 1.4`, 8 GB). ESP8266 and IRF520N unit prices are derived from confirmed multi-pack orders.

### 4.2 Lighting

| Component | Qty | Description | Unit cost | Total cost | Source | Material type |
|---|---|---|---|---|---|---|
| ChilLED Logic Puck V3 (100 W) | 4 | LED grow light modules (244x Samsung LM301B) | €55 | €220 | Rapid LED, 2019-11 | Electronics |
| 140 mm aluminium pin heatsink | 4 | Passive thermal management | €18 | €72 | Rapid LED, 2019-11 | Metal |
| 12 V axial fan (heatsink cooling) | 4 | Convective heatsink cooling | €10 (est.) | €40 | retail estimate | Electronics |
| Mean Well HLG-320H-48B LED driver | 1 | 320 W, 48 V, 3-in-1 dimming, IP65/IP67 | €106.99 | €106.99 | Conrad, 2022-03 | Electronics |

*§4.2 provenance:* the ChilLED Logic Puck V3 modules and 140 mm pin heatsinks were purchased from Rapid LED (order 2019-11) at US$58 / ≈ €55 per puck and US$19 / ≈ €18 per heatsink; the original order covered eleven units, of which four are installed in this build, so the BOM lists and prices the four installed. **The LED driver is a Mean Well HLG-320H-48B (320 W constant-voltage, 48 V, 3-in-1 dimmable), receipt-confirmed (Conrad, 2022-03, €106.99) — corrected here from an earlier "HLG-480H-48A (480 W)" placeholder, which was never receipt-sourced. A 320 W driver is consistent with the four 100 W pucks held to a ≈60 % hardware ceiling (≈240 W nominal) and with the measured ≈220 W midday LED-only draw reported in §7.1.** The four small 12 V heatsink fans are a retail estimate.

### 4.3 Cooling

| Component | Qty | Description | Unit cost | Total cost | Source | Material type |
|---|---|---|---|---|---|---|
| Vitrifrigo ND50 OR2-V compressor unit | 1 | BD50F Danfoss variable-speed, R134a (HFC, ODP=0, GWP₁₀₀≈1430); factory-sealed, no F-gas certification required for installation | €745 (incl. evaporator) | €745 | Ryan Energia, 2021-01 | Mechanical |
| Vitrifrigo PT14 evaporator plate | 1 | 1220 x 280 mm stainless steel | — | (bundled with compressor) | Ryan Energia, 2021-01 | Metal |
| Noctua NF-F12 iPPC-2000 IP67 (120 mm, 2000 RPM, 12 V) | 5 | Evaporator plate fans (x3) + circulation fans (x2) | €38.07 | €190.35 | Amazon.it, 2023-01 | Electronics |
| Noctua NF-A12x25 PWM (120 mm, 12 V) | 2 | Condenser radiator fans in push-pull configuration | €29.89 | €59.78 | Amazon.it, 2022-05 | Electronics |
| Plexiglas plate | 1 | Evaporator airflow plate, inclined 30 deg with slit below | — | (incl. §4.6 acrylic order) | local fabricator | Plastic |

*§4.3 provenance:* the Vitrifrigo ND50 OR2-V cooling unit and PT14 evaporator plate were a single €745 invoice (Ryan Energia S.r.l.s., PayPal, January 2021) — the highest single line in the BOM. The Noctua NF-F12 iPPC-2000 IP67 unit price (€38.07) is receipt-confirmed for a 2-fan order; the five-fan line total applies that confirmed unit price. The condenser fans are Noctua NF-A12x25 PWM (2 × €29.89, 2022-05); the "G2" suffix used in earlier drafts is dropped, as the purchase predates the NF-A12x25 G2 release.

### 4.4 Humidification

| Component | Qty | Description | Unit cost | Total cost | Source | Material type |
|---|---|---|---|---|---|---|
| MistKing Standard diaphragm pump (24 V) | 1 | Misting system pump (in complete system order) | €381.70 (system) | €381.70 | mistking.com, 2021-01 | Mechanical |
| MistKing nozzle assemblies | ~20 | Quad (x1), double (x6), single (x4) | — | €120.72 (add-on order) | mistking.com, 2022-10 | Plastic/metal |
| ZipDrip anti-drip valve | 1 | Prevents residual dripping | — | (incl. MistKing orders) | mistking.com | Plastic |
| Tubing and fittings | 1 set | MistKing-compatible | — | (incl. MistKing orders) | mistking.com | Plastic |

*§4.4 provenance:* the misting hardware came in two receipt-confirmed MistKing (Jungle Hobbies Ltd.) orders — the initial complete system (order #3477, €381.70, January 2021: pump, nozzles, ZipDrip, tubing) and a later nozzle/tubing add-on (order #3911, €120.72, October 2022) — for a combined €502.42.

### 4.5 Ventilation

| Component | Qty | Description | Unit cost | Total cost | Source | Material type |
|---|---|---|---|---|---|---|
| Noctua NF-A6x25 FLX (60 mm, 12 V) | 2 | Outlet ventilation fan (×1, pin 45) + impeller ventilation fan (×1, pin 46), rear ventilation ports per §2.2 | €14.90 | €29.80 | Amazon.it, 2022-02 | Electronics |

*§4.5 provenance:* the two 60 mm ventilation fans are receipt-confirmed Noctua NF-A6x25 FLX (2 × €14.90, 2022-02).

### 4.6 Enclosure

| Component | Qty | Description | Unit cost | Total cost | Source | Material type |
|---|---|---|---|---|---|---|
| Clear acrylic (PMMA) 10 mm | ~2 m^2 | Floor, back wall, side panels, inner back | — | see note | local fabricator | Plastic |
| Clear acrylic (PMMA) 8 mm | ~1 m^2 | Sliding doors, shelf, support tracks | — | see note | local fabricator | Plastic |
| Clear acrylic (PMMA) 5 mm | ~0.5 m^2 | Shelf lips, brackets, triangles | — | see note | local fabricator | Plastic |
| Silver mirror acrylic 2 mm | ~0.5 m^2 | Reflective panels (x5 + add-ons) | — | see note | local fabricator | Plastic |
| Black acrylic 4 mm | ~0.5 m^2 | Light-blocking baffles (add-on set) | — | see note | local fabricator | Plastic |
| Perforated acrylic (Square 15) 3 mm | ~0.5 m^2 | Ventilation grilles, shelf floor | — | see note | local fabricator | Plastic |
| XPS insulation (1 cm) | ~2 m^2 | Exterior thermal insulation | — | see note | hardware store | Foam |
| Diamond Mylar reflective sheeting | ~2 m^2 | Laminated to XPS insulation | — | see note | hardware store | Plastic/foil |
| Dichloromethane (DCM) | ~100 mL | Solvent welding (use with ventilation!) | — | see note | hardware store | Chemical |
| Crystalline silicone sealant (c-Si) | 1 tube | Joint sealing (NOT acetoxy silicone) | — | see note | hardware store | Chemical |
| Aluminium alloy scaffold | 1 | 2.20 x 3.20 x 0.50 m, ~300 kg | — | see note | metal supplier | Metal |
| Aluminium alloy guides | 2 | Sliding door tracks | — | see note | metal supplier | Metal |

*§4.6 provenance:* the enclosure materials were sourced locally in Genoa — laser-cut acrylic panels (PMMA 10/8/5 mm, mirror 2 mm, black 4 mm, perforated 3 mm, plus the §4.3 Plexiglas evaporator plate) from a custom fabricator; XPS insulation, Diamond Mylar, dichloromethane, and crystalline silicone from hardware stores; the aluminium scaffold and door guides from a metal supplier. These purchases (2021–2022) are documented by paper/in-person receipts not present in the digital order record, so per-line prices are not individually reconstructed. The aggregate enclosure-and-structure materials cost is estimated at **€450–600**; the midpoint (≈€525) is carried into the Specifications-Table total.

### 4.7 Reservoirs and Plumbing

| Component | Qty | Description | Unit cost | Total cost | Source | Material type |
|---|---|---|---|---|---|---|
| 40-liter reservoir | 2 | Misting supply + condensate collection | €30 (est.) | €60 | retail estimate | Plastic |

*§4.7 provenance:* the two 40-L food-grade reservoirs are commodity items without a recovered digital receipt; €30 each is a retail estimate.

---

**BOM cost summary.** Subsection totals (build-installed quantities): control electronics ≈ €314; lighting ≈ €439; cooling ≈ €995; humidification ≈ €502; ventilation ≈ €30; enclosure and structure ≈ €525 (estimated midpoint, see §4.6); reservoirs ≈ €60. **Total hardware cost ≈ €2,865 (≈ US$3,050).** Of this, roughly €2,190 is receipt-confirmed from the author's digital order history (the Vitrifrigo cooling unit, ChilLED pucks and heatsinks, Mean Well driver, all Noctua fans, MistKing system, Raspberry Pi kit, SHT35, Tapo and Meross plugs, ESP8266, IRF520N modules), and the remainder (≈€675) is estimated for items without a recovered digital receipt — the locally-sourced enclosure/acrylic/scaffold materials (§4.6) and four small commodity electronics (Arduino Mega clone, HC-SR04P, reed switches, powered USB hub) and the reservoirs. Estimated lines are flagged "(est.)" in the tables above. The cost remains one to two orders of magnitude below a commercial growth chamber of comparable volume (§7.7).

*Provenance note for reviewers:* costs were reconstructed in June 2026 from the author's e-mail order archive. The component identities and quantities were verified against §2 and §5 independently of cost. Two corrections arose from the receipt reconstruction and are reflected above: the LED driver is a **Mean Well HLG-320H-48B (320 W)**, not a 480 W unit, and the controller is a **Raspberry Pi 4 Model B (8 GB)** acquired as a starter kit (the 8 GB board is confirmed against the running hardware).

---

## 5. Build Instructions

### 5.1 Enclosure Construction

#### 5.1.1 Material Selection and Cutting

Select acrylic (PMMA) as the enclosure material based on its superior transparency, low weight, ease of modification, and lower cost compared to tempered glass or polycarbonate. Order laser-cut panels according to the specifications in the Design Files (panel drawings). Laser cutting is strongly recommended over circular-saw cutting, as the edge smoothness is critical for successful solvent welding.

Material properties comparison:

| Property | Tempered Glass | Polycarbonate | Acrylic (PMMA) |
|---|---|---|---|
| Transparency | Good | ~88% | Highest |
| Thermal conductivity | Variable | 0.19–0.22 W/mK | 0.19–0.22 W/mK |
| Impact resistance | Low | Excellent (200x glass) | Moderate |
| Weight | Heaviest | Medium | Lightest |
| Machinability | Non-drillable | Easy | Easy |
| Fire resistance | Fireproof | Good | Combustible |
| UV/yellowing | Good | Yellows over time | Good long-term |
| Cost | Highest | Medium | Lowest |

#### 5.1.2 Panel Fabrication

The enclosure requires 20 laser-cut panels plus 6 structural triangles (see Design Files S6 for full specifications). The main structural panels are:

- **Floor** (1x): 145 x ~55 cm, 10 mm clear acrylic
- **Back wall** (1x): 145 x ~115 cm, 10 mm clear acrylic, with 2x 12 cm ventilation holes and 2x 2 cm cable pass-throughs
- **Inner back / shelf support** (1x): 145 x 115 cm, 10 mm clear acrylic
- **Side panels** (2x): 49 x 115 cm, 10 mm clear acrylic, with notches for door guides and ventilation holes
- **Sliding front doors** (2x): 73.5 x 94.6 cm, 8 mm clear acrylic
- **Bottom rails** (2x): 145 x 10 cm, 20 mm clear acrylic

Internal components include perforated shelf panels (8 mm, Square 15 pattern), shelf support brackets (5 mm), and corner reinforcement triangles (5 mm). Reflective panels (2 mm silver mirror acrylic) and the 2022 add-on set (black light baffles, additional perforated grilles) complete the panel set.

#### 5.1.3 Assembly

1. **Dry-fit all panels** to verify dimensions before solvent welding. Laser-cut edges should mate precisely.

2. **Solvent weld using dichloromethane (DCM)**:
   - Work in a well-ventilated area. DCM is volatile and toxic (possible carcinogen).
   - Apply DCM to the joint with a syringe or applicator bottle — capillary action draws it into the seam.
   - The weld sets within seconds and produces a monolithic bond.
   - **Critical**: DCM permanently stains acrylic on contact. Protect all visible surfaces with masking tape.

3. **Seal joints with crystalline silicone (c-Si)** after DCM welding for watertightness. **Never use acetoxy silicone (a-Si)** — it releases acetic acid that corrodes and permanently stains acrylic.

4. **Flood test**: Fill the completed enclosure with ~30 liters of water and leave for one week to verify watertightness before installing any hardware.

5. **Apply exterior insulation**: Laminate 1 cm XPS panels with diamond Mylar reflective sheeting and attach to the exterior of the back wall, side panels, and floor. Exterior placement leaves interior surfaces smooth for cleaning and maximizes usable volume.

6. **Install sliding door guides**: Attach aluminium alloy guides with c-Si adhesive for the two front sliding panels.

The full panel geometry needed to reproduce the enclosure — every cut panel with its dimensions and hole positions — is provided as the acrylic panel drawings in the Design Files (`S6-panel-drawings-original.docx` and `S6-panel-drawings-addon-2022.docx`; per-panel layout figures are also mirrored on the project website under `highland/build/`). Build-era interior photographs of the assembled enclosure are on the website (`highland/interior/`, including the 2022 build-era frame). A step-by-step photographic sequence of the solvent-welding process is an optional enrichment; because the enclosure is a one-off solvent-welded assembly, the panel drawings plus the written steps above are what enable reproduction.

#### 5.1.4 Drainage

Tilt the floor panel slightly toward a rear drainage hole. The shelf below the terrarium hosts three items: the MistKing diaphragm pump, a 40-liter water reservoir feeding the pump, and a 40-liter condensate collection tank receiving gravity drainage from the evaporator plate above.

### 5.2 Hardware Assembly

#### 5.2.1 Lighting Installation

1. Mount four ChilLED Logic Puck V3 modules on 140 mm aluminium pin heatsinks above the terrarium enclosure. The pucks and heatsinks reside above the enclosure so their thermal output does not contribute to the internal heat load.

2. Mount 12 V axial fans above each heatsink for supplementary convective cooling.

3. Wire the four pucks in parallel to the Mean Well HLG-320H-48B LED driver (320 W, 48 V constant-voltage, 3-in-1 dimmable, IP65/IP67). The 320 W rating comfortably supplies the four 100 W pucks held to the ≈60 % hardware ceiling (≈240 W nominal).

4. Adjust the Mean Well driver's internal potentiometer to limit maximum output to approximately 60% of rated power. This hardware ceiling provides a fail-safe: even if the software erroneously commands 100% brightness, the LEDs cannot exceed ~60%, protecting shade-adapted species.

5. Connect the driver's analog dimming input to the Arduino's PWM pin 8. Note that lower PWM values produce brighter output (the driver dims proportionally to the PWM signal).

6. Wire the driver's mains input through a TP-Link Tapo P100 smart plug (for on/off scheduling).

#### 5.2.2 Cooling System Installation

The Vitrifrigo ND50 is a split-system marine refrigeration unit shipped pre-charged with R134a (HFC, ozone-depletion potential = 0, GWP₁₀₀ ≈ 1430) in a sealed circuit; no F-gas handling certification is required for installation. The compressor and condenser are mounted external to the cooled space, with refrigerant lines connecting them through a sealed pass-through to a separate evaporator plate inside. The compressor unit sits above the terrarium, and the evaporator plate is mounted **horizontally on the rear wall in the lower portion of the enclosure** (cutout centred at ~20 cm above the cabinet floor — see back-panel drawing `panel-03-with-radiator` in the Design Files). This is mechanical refrigeration — not evaporative cooling.

Marine refrigeration is a distinct hardware category from the better-known DIY compressor-cooling routes (chest-freezer conversions, aquarium chillers, modified portable air conditioners) and three replicator-relevant properties recommend it for terrarium use: (i) **installation is mechanical, not refrigeration work** — the unit ships as a complete factory-assembled split system, so no field plumbing of the cold loop and no system charging is required; (ii) **the unit class scales to enclosure size** — Vitrifrigo and equivalent marine-refrigeration vendors offer compressor/evaporator combinations spanning roughly 30–200 L cold-storage capacity with several evaporator plate footprints, so terraria between ~0.3 m³ and ~3 m³ can be matched without custom engineering; (iii) **factory-sealed pre-charged loop = no F-gas certification needed for installation** under EU/UK rules (the certification requirement applies to filling or topping up the refrigerant, not to installing a sealed unit), removing a skills barrier that has historically restricted DIY compressor-based terrarium cooling. Repairs on the cold loop *do* require certification — a faulty unit is replaced or serviced by a marine-refrigeration shop rather than user-repaired.

The low evaporator placement establishes a desirable vertical climate gradient inside the cabinet. Cold (and therefore dense) air sinking from the evaporator plate pools near the cabinet floor and rises by convection as it warms, while the LEDs are mounted above the cabinet. The result is **a warmer, brighter upper canopy and a cooler, shadier floor** — the inverse-stratified arrangement reproduces the natural moss-and-bryophyte zonation found near the base of cloud forest trunks and rocks.

1. Place the Vitrifrigo ND50 OR2-V compressor unit on a frame or shelf above the terrarium, with adequate clearance for the condenser radiator and fans to exhaust heat away from the enclosure.

2. Mount the Vitrifrigo PT14 evaporator plate horizontally on the inside of the rear wall, with the upper face of the plate ~20 cm above the cabinet floor. Route the refrigerant lines from the compressor through a sealed pass-through in the top panel. Ensure the evaporator's condensate drain leads, via gravity, to the condensate reservoir on the shelf below the terrarium.

3. Mount a plexiglas baffle in front of the evaporator plate, inclined approximately 30° from horizontal. Leave a slit between the lower edge of the baffle and the cabinet floor so that the cold air sinking off the evaporator is channelled downward and discharged at floor level.

4. Evenly space three Noctua NF-F12 iPPC-2000 IP67 fans on the plexiglas baffle, oriented to draw warm interior air across the evaporator surface.

5. Mount two additional Noctua NF-F12 iPPC-2000 IP67 fans separately within the cabinet for general internal circulation.

6. Mount two Noctua NF-A12x25 G2 fans in push-pull configuration on the compressor's condenser radiator fins (not Arduino-controlled; these run whenever the compressor unit is powered).

7. Wire the compressor's mains input through a TP-Link Tapo P100 smart plug (for on/off control).

#### 5.2.3 Humidification System Installation

1. Install the MistKing Standard pump below the terrarium, connected to the 40-liter misting reservoir.

2. Route MistKing tubing through a cable pass-through to the terrarium ceiling.

3. Install the nozzle array: one quad-nozzle assembly, six double-nozzle assemblies, and four single nozzles distributed across the ceiling for even fog coverage (~20 nozzle points total).

4. Install a ZipDrip anti-drip valve on the main supply line.

5. Wire the MistKing pump's power through a TP-Link Tapo P100 smart plug (for on/off control).

#### 5.2.4 Fan Wiring

Wire each fan group through an IRF520N MOSFET driver module:

| Fan group | MOSFET gate → Arduino pin | Fan supply voltage | Purpose |
|---|---|---|---|
| Evaporator fans (3x Noctua NF-F12 iPPC-2000) | Pin 44 (Timer 5) | 12 V | Airflow across evaporator plate |
| Outlet fan (Noctua 60 mm) | Pin 45 (Timer 5) | 12 V | Exhaust humid air |
| Impeller fan (Noctua 60 mm) | Pin 46 (Timer 5) | 12 V | Draw external air in |
| Circulation fans (2x Noctua NF-F12 iPPC-2000) | Pin 12 (Timer 1) | 12 V | Internal air movement |

**Important**: Do not connect the Arduino PWM output to the fans' 4-pin PWM inputs when driving multiple fans per channel. The MOSFET module switches the power rail instead, eliminating inter-fan signal interference. For single-fan configurations, direct 4-pin PWM connection with a 220 ohm series resistor per fan is acceptable.

#### 5.2.5 Sensor Installation

1. Connect the SHT35 sensor to the ESP8266. Position the sensor at mid-canopy height (~50 cm above floor), roughly centered in the enclosure.

2. Mount the HC-SR04P ultrasonic sensor above the misting reservoir for water level monitoring.

3. Wire two magnetic reed switches to Arduino digital inputs D22 (left door) and D24 (right door) — the Arduino's internal pull-up resistors are enabled in firmware.

### 5.3 Electronics Wiring

#### 5.3.1 Arduino Mega Pin Assignments

| Pin | Type | Function | Notes |
|---|---|---|---|
| 8 | PWM output | Light dimmer | Standard PWM; lower value = brighter |
| 12 | PWM output | Circulation fans | Timer 1, 25 kHz phase-correct (OC1B) |
| 44 | PWM output | Evaporator fans | Timer 5, 25 kHz phase-correct (OC5C) |
| 45 | PWM output | Outlet fan | Timer 5, 25 kHz phase-correct (OC5B) |
| 46 | PWM output | Impeller fan | Timer 5, 25 kHz phase-correct (OC5A) |
| A0 | Analog input | Heartbeat signal | Watched by serial watchdog |
| D22 | Digital input | Left door reed switch | INPUT_PULLUP |
| D24 | Digital input | Right door reed switch | INPUT_PULLUP |

#### 5.3.2 Power Distribution

- **Mains (230 V AC)**: Through 3x Tapo P100 smart plugs → LED driver, MistKing pump, compressor
- **48 V DC**: Mean Well driver → 4x ChilLED pucks
- **12 V DC**: All internal Noctua fans (NF-F12 iPPC-2000 evaporator + circulation, 60 mm outlet + impeller, NF-A12x25 condenser push/pull). The IRF520N MOSFET modules switch the 12 V power rail at 25 kHz; the fans' own 4-pin PWM inputs are left unconnected. Heatsink-fan supply (4× 12 V axial above the LED pucks) shares the same rail.
- **24 V DC**: MistKing diaphragm pump only.
- **12 V DC**: Separate supply → Outlet/impeller fans (via MOSFET modules), heatsink fans
- **5 V DC**: Raspberry Pi USB → Arduino Mega, ESP8266

**Safety**: All electrical lines running near or above the terrarium must incorporate drip loops (U-shaped cable routing below connection points) to prevent water ingress.

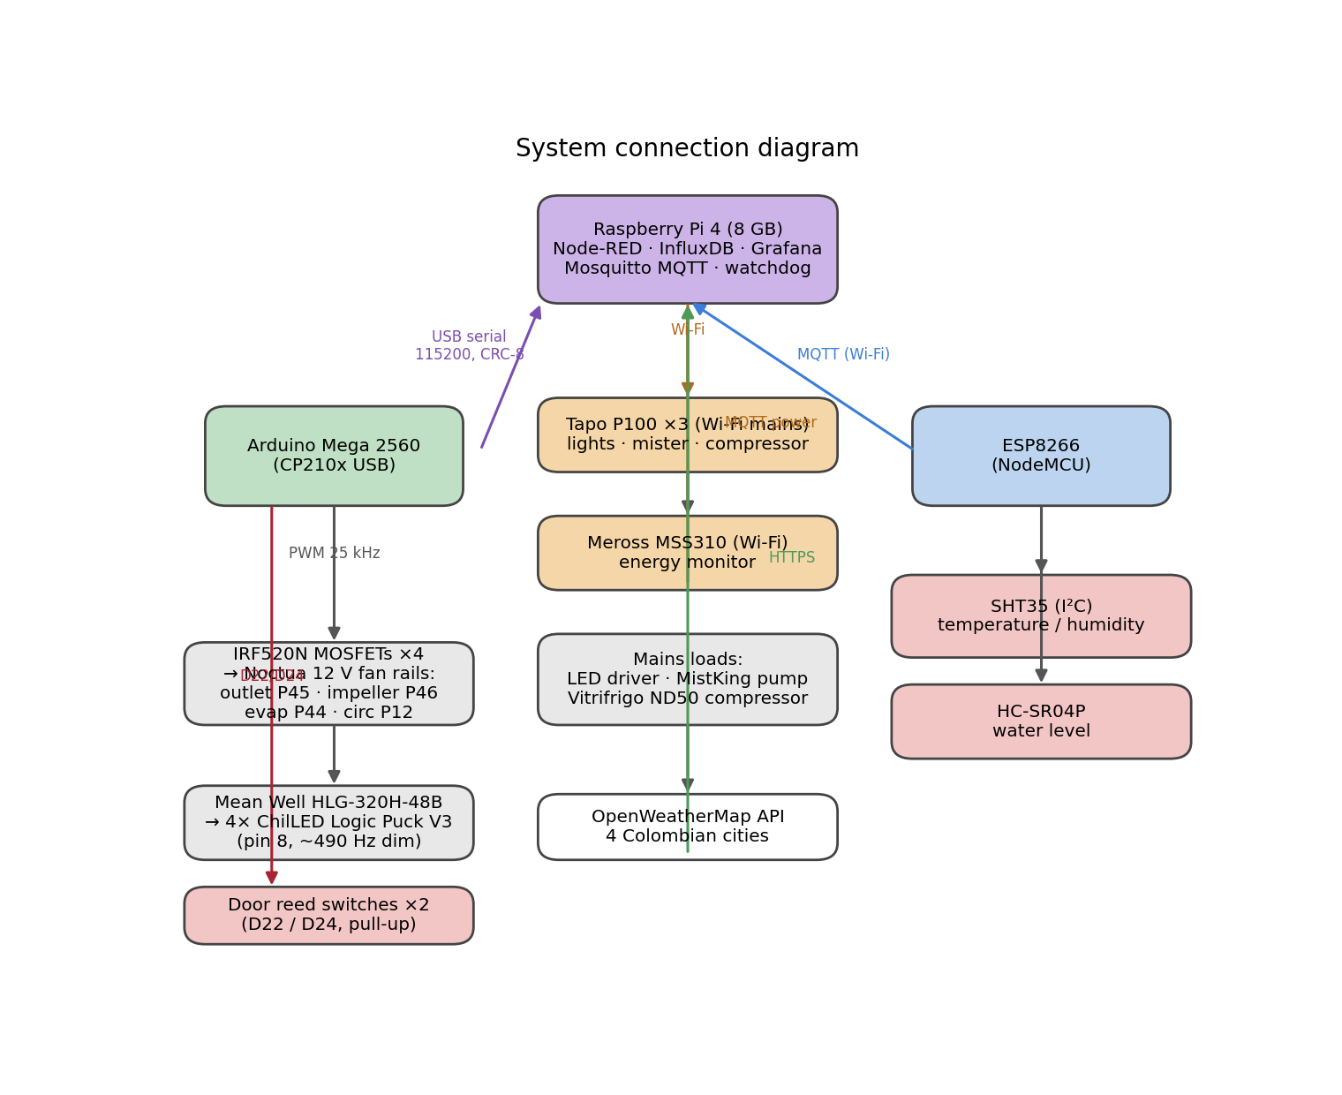
[picture p3: paper/figures/fig6_system_wiring.png]
System connection diagram: Raspberry Pi 4 (Node-RED/InfluxDB/Grafana/MQTT) linked by USB serial to the Arduino Mega (PWM to the IRF520N MOSFET fan rails and the LED driver, door reed switches in) and by Wi-Fi/MQTT to the ESP8266 sensor node, the three Tapo P100 mains plugs, the Meross energy monito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


*Figure 5.3 — System connection diagram (signal and power paths), generated from the documented architecture by `analysis/publication_figures.py`. This is a block-level connection map, not a full electrical schematic; the detailed acrylic-panel drawings are in the design files (`S6-panel-drawings-*.docx`), and the exact MOSFET-gate and power-rail wiring follows the pin assignments in §5.3.1 and the per-channel notes in §5.3.2.*

### 5.4 Software Installation

#### 5.4.1 Raspberry Pi Setup

1. Install Raspberry Pi OS (Debian-based, ARMv8) on a MicroSD card.

2. Install Node-RED v3.x:
   ```
   bash <(curl -sL https://raw.githubusercontent.com/node-red/linux-installers/master/deb/update-nodejs-and-nodered)
   ```
   Enable the systemd service:
   ```
   sudo systemctl enable nodered
   ```

3. Install InfluxDB v1.8:
   ```
   sudo apt install influxdb
   ```
   Create the database:
   ```
   influx -execute "CREATE DATABASE highland"
   influx -execute "CREATE RETENTION POLICY standard_highland_retention ON highland DURATION 365d REPLICATION 1 DEFAULT"
   ```

4. Install Grafana:
   ```
   sudo apt install grafana
   sudo systemctl enable grafana-server
   ```

5. Install Mosquitto MQTT broker:
   ```
   sudo apt install mosquitto mosquitto-clients
   ```

6. Install Node-RED dependencies (from the Node-RED palette manager or command line):
   - `node-red-contrib-influxdb`
   - `node-red-dashboard`
   - `node-red-contrib-dynamic-dimmer`
   - `node-red-node-serialport`
   - `node-red-contrib-sun-position`

7. Install Python dependencies for Tapo P100 control:
   ```
   pip3 install PyP100
   ```

#### 5.4.2 Udev Rules

Create `/etc/udev/rules.d/99-arduino.rules` to create stable device symlinks:

```
SUBSYSTEM=="tty", ATTRS{idVendor}=="10c4", ATTRS{idProduct}=="ea60", SYMLINK+="arduino"
SUBSYSTEM=="tty", ATTRS{idVendor}=="1a86", ATTRS{idProduct}=="7523", SYMLINK+="esp32"
```

Reload:
```
sudo udevadm control --reload-rules && sudo udevadm trigger
```

### 5.5 Node-RED Flow Import and Configuration

1. Open the Node-RED editor (http://<pi-ip>:1880).

2. Import `flows-sanitized.json` via Menu → Import.

3. Configure credentials in the following nodes:
   - **Tapo P100 Python function nodes** (3x): Set IP addresses, email, and password for each smart plug
   - **OpenWeatherMap nodes**: Insert your API key
   - **Meross Python function node**: Set cloud credentials for power monitoring

4. Configure the serial port node to use `/dev/arduino` at 115200 baud.

5. Configure the MQTT nodes to connect to `localhost:1883`.

6. Deploy the flows.

### 5.6 Arduino Firmware Upload

1. Install the Arduino CLI:
   ```
   curl -fsSL https://raw.githubusercontent.com/arduino/arduino-cli/master/install.sh | sh
   arduino-cli core install arduino:avr
   ```

2. Upload the firmware:
   ```
   arduino-cli upload -p /dev/arduino --fqbn arduino:avr:mega -i arduino-terrarium.ino
   ```

   The firmware implements:
   - 25 kHz phase-correct PWM on Timer 1 (pin 12) and Timer 5 (pins 44, 45, 46)
   - Text-based serial protocol: `P<pin>,<val>` (PWM), `Q` (query), `H,<val>` (heartbeat), `D<pin>,<0|1>` (doors)
   - PWM zero fix: disconnects output compare register and drives pin LOW when value=0 to prevent MOSFET ghost pulses
   - Heartbeat generation on A0 for watchdog monitoring

### 5.7 Grafana Dashboard Import

1. Open Grafana (http://<pi-ip>:3000, default admin/admin).
2. Add InfluxDB as a data source: URL `http://localhost:8086`, database `highland`.
3. Import each dashboard JSON from the `grafana/` directory.

### 5.8 Watchdog Installation

1. Copy `arduino-watchdog.sh` to `/usr/local/bin/` and make executable.
2. Copy `arduino-watchdog.service` to `/etc/systemd/system/`.
3. Enable and start:
   ```
   sudo systemctl enable arduino-watchdog
   sudo systemctl start arduino-watchdog
   ```

The assembled system is documented photographically on the project website: the interior build/operation gallery (`highland/interior/`), the live dashboard renders (`highland/dashboard/`), and the system connection diagram (Figure 5.3) together show the integrated hardware and wiring. A discrete step-by-step photographic sequence of the electronics assembly is an optional addition.

---

## 6. Operation Instructions

### 6.1 First Start and Calibration

1. Verify all Tapo P100 smart plugs are reachable on the network and controllable from Node-RED.

2. Verify the Arduino serial connection: the "Heartbeat" debug node in the Utilities tab should show periodic values.

3. Verify the SHT35 sensor publishes MQTT data: check the Humidity tab for incoming readings.

4. Fill the misting reservoir to capacity and verify the water level reading on the Dashboard.

5. Adjust the Mean Well driver potentiometer:
   - Set the Node-RED slider to 100%.
   - Observe light output and adjust the potentiometer screw until output is approximately 60% of maximum. This is a subjective assessment based on the light requirements of the most shade-sensitive species.

6. Verify fan operation: manually set each fan channel to test PWM values via the Dashboard and confirm rotation.

7. Set the OpenWeatherMap API key and verify weather data appears in the Weather tab.

### 6.2 Daily Operation

Under normal operation, the system requires no human intervention. The automated cycle includes:

- **Weather polling**: Current conditions fetched from four Colombian cities and heavily smoothed (15-minute rolling mean) into temperature/humidity setpoints. The 15-hour data buffer makes aggressive smoothing cost-free. If the live pipeline is stale (>10 min), the controller transparently substitutes a smoothed 14-day rolling historical daily curve that is itself rebuilt from the InfluxDB archive every six hours, so the fallback follows seasonal drift without operator intervention.
- **Photoperiod calculation and Light Curve C**: Day length is computed daily from the Chinchina latitude (clamped to 10–14 h) and bounds a raised-cosine brightness curve (Light Curve C) centred on the source-latitude solar noon. The curve replaced the prior two-step ramp (deployed 2026-05-04) and delivers a +23 % daily-integrated-PAR uplift while smoothing diurnal radiant-load transients.
- **PID fan control (two regimes)**: Below 24 °C, the PID drives fans on humidity error (humidity-driven regime); at or above 24 °C, the PID switches to temperature error and continues to drive fans on temperature even after compressor engagement (temperature-driven regime, retained as a ceiling-defence cooling actuator throughout daylight LED load).
- **Mister control**: A regime-aware humidity hysteresis controller fires the mister when humidity drops below the lower threshold, with automatic fan shutdown during misting events. The mister command is also gated by an upstream water-level precondition (ESP MQTT tank-percent ≥ 10 % and < 5 min old) so dry-run cannot be initiated.
- **Compressor control**: Hysteresis controller activates the compressor when temperature exceeds 25 °C (daytime, with a thermal-override that lifts the daytime gate if the cabinet runs warmer than 25 °C) or the weather-capped target (nighttime).
- **Wet-bulb gate**: After lights-off, outlet and impeller fans shut down between the first compressor engagement and 05:00 (latched until the window closes), reducing fan-mediated room-air mixing during the cool nocturnal phase.
- **Data logging**: A continuous stream of 33 InfluxDB measurements at 60-second cadence (continuous channels) plus event-driven actuator-change logging; the 1-year retention window typically holds ~3.1 million data points.

### 6.3 Dashboard Monitoring

**Node-RED Dashboard** (http://<pi-ip>:1880/ui): Real-time gauges for temperature, humidity, VPD, fan speed, and actuator states. Manual override controls. Mist counter. Water level.

**Grafana** (http://<pi-ip>:3000): Historical charts with configurable time ranges. Four dashboards cover operational monitoring, weather reference, system performance, and experimental data.

### 6.4 Maintenance

- **Water refills**: Monitor the water level gauge on the Dashboard. Refill the misting reservoir when it drops below ~20%. The ultrasonic sensor provides the low-water alert.
- **Sensor cleaning**: The SHT35 sensor may accumulate mineral deposits from misting. Clean periodically with distilled water.
- **Condensate reservoir**: Empty when needed (overflow is not harmful but creates mess).
- **Door safety**: When opening the terrarium for maintenance, the door safety system automatically stops fans, compressor, and mister, and sets lights to 60% for working illumination. All systems restore when doors close.

### 6.5 Troubleshooting

| Symptom | Likely cause | Resolution |
|---|---|---|
| No fan response to PID | Serial stall | Wait ~15–30 s for watchdog auto-recovery; check watchdog service status |
| Fans spinning at PWM 0 | AVR phase-correct PWM ghost pulse | Verify firmware includes the PWM zero fix (output compare disconnect) |
| Weather data stale | API key expired or network issue | Check OpenWeatherMap API status; system falls back to 14-day historical curve automatically |
| Mister runs continuously | Tapo plug stuck or humidity sensor fault | Mister cron failsafe forces Tapo OFF after 150 s; check sensor readings |
| Temperature climbing despite compressor | Compressor Tapo plug unreachable | Check WiFi connectivity of plug at 192.168.1.196 |
| "Serial port not open" errors | USB disconnect | Watchdog performs USB sysfs reset; recovery takes ~15–30 s |

### 6.6 Safety Considerations

#### Build-time hazards

- **Electrical safety with water**: All mains wiring must use drip loops. Smart plugs and power supplies should be positioned where they cannot be splashed. The IP65-rated Mean Well driver provides moisture protection for the LED driver.
- **DCM handling**: Dichloromethane is volatile and toxic. Use only in well-ventilated areas during construction.
- **Compressor refrigerant**: The Vitrifrigo unit ships pre-charged with R134a and factory-sealed; no F-gas certification is required for installation. Refilling or any work on the sealed loop *does* require certification in EU/UK jurisdictions.
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
