GabrieleZoppoli/terrarium-control-system/paper/icps-paper.md

# A Distributed Ex-Situ Refugium Network for Cloud-Forest Flora: Open-Source Freeware Climate Control and the Climatic-Envelope Convergence That Makes It Possible

**Authors**: Gabriele Zoppoli — Department of Internal Medicine and Medical Specialties (DiMI), University of Genoa, Genoa, Italy; IRCCS Ospedale Policlinico San Martino, Genoa, Italy

**Corresponding author**: gabriele.zoppoli@unige.it

---

## Abstract

Cloud-forest endemics are among the most climate-threatened floras on Earth — warming compresses their narrow elevational bands faster than the species can track — yet institutional ex-situ capacity for them is limited and costly. We argue that a low-cost, open-source freeware controller can turn the world's many private cloud-forest growers into a distributed, standardized, citizen-science ex-situ refugium network, and that this is made horticulturally feasible by a specific biological fact: cloud forests worldwide converge on a bounded climatic envelope (cool ~10–22 °C, 80–100 % RH, frequent cloud immersion, moderate filtered light) despite deep geographic and phylogenetic separation. We demonstrate the principle with 75 living accessions across 31 plant genera, spanning four biogeographic regions — Neotropical highlands (Guayanan tepui, Andes, Brazilian Atlantic Forest), Southeast Asian highlands (Sumatra, Sulawesi, the Philippines), and Papua New Guinea / Oceania — co-cultivated for four years in a single ~1 m³ enclosure in Genoa, Italy. We state the convergence claim carefully: tepui summits are largely treeless *tepuiana* / Pantepui, not tropical montane cloud forest in the strict vegetation sense (Hamilton, Juvik & Scatena 1995; Bruijnzeel et al. 2011), so it is *climatic-envelope* overlap plus vertical micro-zoning, not vegetation-type identity, that permits co-cultivation. The enabling system — a Raspberry-Pi controller driven by real Colombian highland weather phase-shifted into Italian local time, and a marine compressor that reaches ≈13.5 °C in a 22 °C room, below the ≈16.6 °C evaporative wet-bulb floor — costs ≈€2,865 in hardware against €10,000–50,000+ for closed commercial chambers, draws ≈2.63 kWh/day, and runs on entirely free software. Full engineering, carnivore cultivation, and orchid cultivation outcomes are reported in the companion HardwareX, CPN, and *Orchids* (AoS) papers; all code, dashboards, build photographs, and live data are at https://highlandcloudforest.com. We make the case that open-source controlled-environment agriculture is a practical, under-used lever for plant conservation.

**Keywords**: ex-situ conservation, citizen science, cloud forest, climatic convergence, open-source hardware, freeware, controlled-environment agriculture, *Heliamphora*, *Nepenthes*, *Dracula*, *Dendrobium*, Pantepui, distributed refugia

---

## 1. Introduction — The Conservation Problem and the Freeware Thesis

### 1.1 Cloud-forest floras are acutely climate-threatened

Tropical highland environments — from the Guayanan tepui table-top mountains of Venezuela to the Andes, the highlands of Papua New Guinea, the Brazilian Atlantic Forest highlands, and the upper montane forests of Sumatra, Sulawesi, and the Philippines — harbour extraordinary, narrowly endemic plant diversity adapted to tight environmental envelopes: cool temperatures (10–22 °C), persistent high humidity (80–100 % RH), frequent fog or cloud immersion, and moderate light filtered through cloud. These floras are also among the most climate-vulnerable on the planet. Warming pushes the cloud condensation level and the species' thermal optima upslope; on isolated summits and table mountains there is no "upslope" left to migrate to, so the available habitat band is compressed rather than displaced. For the Neotropical Guayana Highlands specifically, Rull & Vegas-Vilarrúbia (2006) projected substantial, potentially unexpected biodiversity loss under even moderate warming scenarios, precisely because the endemic-rich summit flora cannot track its climate envelope across the surrounding lowlands. The same elevational-compression logic applies to the other regions co-cultivated here.

### 1.2 Institutional ex-situ capacity is limited and expensive

Conventional responses — in-situ protection and institutional ex-situ collections in botanic gardens — are essential but insufficient at the scale and specificity these floras demand. Maintaining cool, cloud-immersed conditions outside the native range requires active refrigeration and humidification, which at institutional scale means commercial plant growth chambers (e.g., Percival, Conviron). Such chambers are reliable but cost on the order of €10,000–50,000+ per unit, run proprietary closed-source firmware that the owner cannot inspect or extend, and are concentrated in a small number of well-funded institutions. The number of cloud-forest taxa that can be held this way is bounded by institutional budgets and floor space.

### 1.3 Private growers already hold the collections — but ad hoc

In parallel, a large, dispersed community of private specialist growers already maintains substantial living collections of exactly these taxa — *Heliamphora*, highland *Nepenthes*, *Dracula* and other cool-growing Pleurothallidinae, miniature highland *Dendrobium*, rupicolous Brazilian orchids. Collectively this represents a globally distributed living gene-bank of conservation interest. But it is undocumented and unstandardized: each grower runs a bespoke setup with no shared data model, no auditable environmental record, and no reproducible control logic. Provenance is often informal, husbandry is tacit, and a collection's contents and conditions typically vanish when the grower stops.

### 1.4 Thesis

We propose that the gap between expensive-but-rigorous institutional chambers and cheap-but-ad-hoc private collections can be closed with **open-source freeware**. A reproducible controller costing ≈€2,865 in commodity hardware, running entirely free software on a Raspberry Pi, can standardize and de-risk private holdings: it gives every replicate the same auditable environmental record, the same inspectable and extensible control logic, and the same naturalistic, weather-referenced climate. Standardization is what converts a scattered set of private terraria into a coherent **distributed, citizen-science ex-situ refugium network** — many independent, geographically dispersed nodes holding overlapping and complementary accessions under a documented, reproducible regime, complementing (not replacing) institutional and in-situ conservation.

The remainder of this paper makes the biological and practical case for that thesis. Section 2 develops the convergence principle that makes a *single* low-cost envelope viable for taxa from four biogeographic regions at once — the signature contribution of this paper. Section 3 summarizes the enabling freeware system briefly and cites the companion engineering paper for depth. Section 4 develops the conservation argument for distributed refugia, including honest limitations. We do not re-derive the engineering or re-list the cultivation outcomes here; those are the subjects of the three companion papers and the public website, and are cited rather than reproduced.

---

## 2. The Convergence Principle

The horticultural premise of a distributed refugium network is that one bounded, low-cost climate can host taxa from many disjunct cloud forests simultaneously. If each biogeographic region required its own chamber and its own bespoke regime, the cost-and-complexity barrier the freeware thesis is meant to remove would simply reappear. The premise holds because of climatic convergence — and stating that claim precisely is essential to its credibility.
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
