GabrieleZoppoli/terrarium-control-system/paper/MAC_CLAUDE_COUNTER_REVIEW_2026-05-13.md

# Mac-Claude counter-review of round-2 Codex pass — 2026-05-13

## Frame

Round-2 Codex pass dispatched 2026-05-13 against the four Pass-B drafts
(`hardwarex.md` f482a40, `aos-paper.md` f2c10fb, `cpn-paper.md` caf5c8a,
`icps-paper.md` b41f62a). Each brief listed the Pi-Claude reversals + the
energy SoT + the round-1 reviews + my counter-review as priors to keep
Codex from re-litigating closed items.

20 attacks total: 5 BLOCK, 14 MAJOR, 1 MINOR.

This memo verifies each attack against primary sources / repo state /
arithmetic, labels each **ACT / ADDRESS / ACKNOWLEDGE**, surfaces what
Codex missed, and flags the items Pi-Claude or the user must adjudicate.
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
