GabrieleZoppoli/terrarium-control-system/docs/images/progetto-addon/image1.png

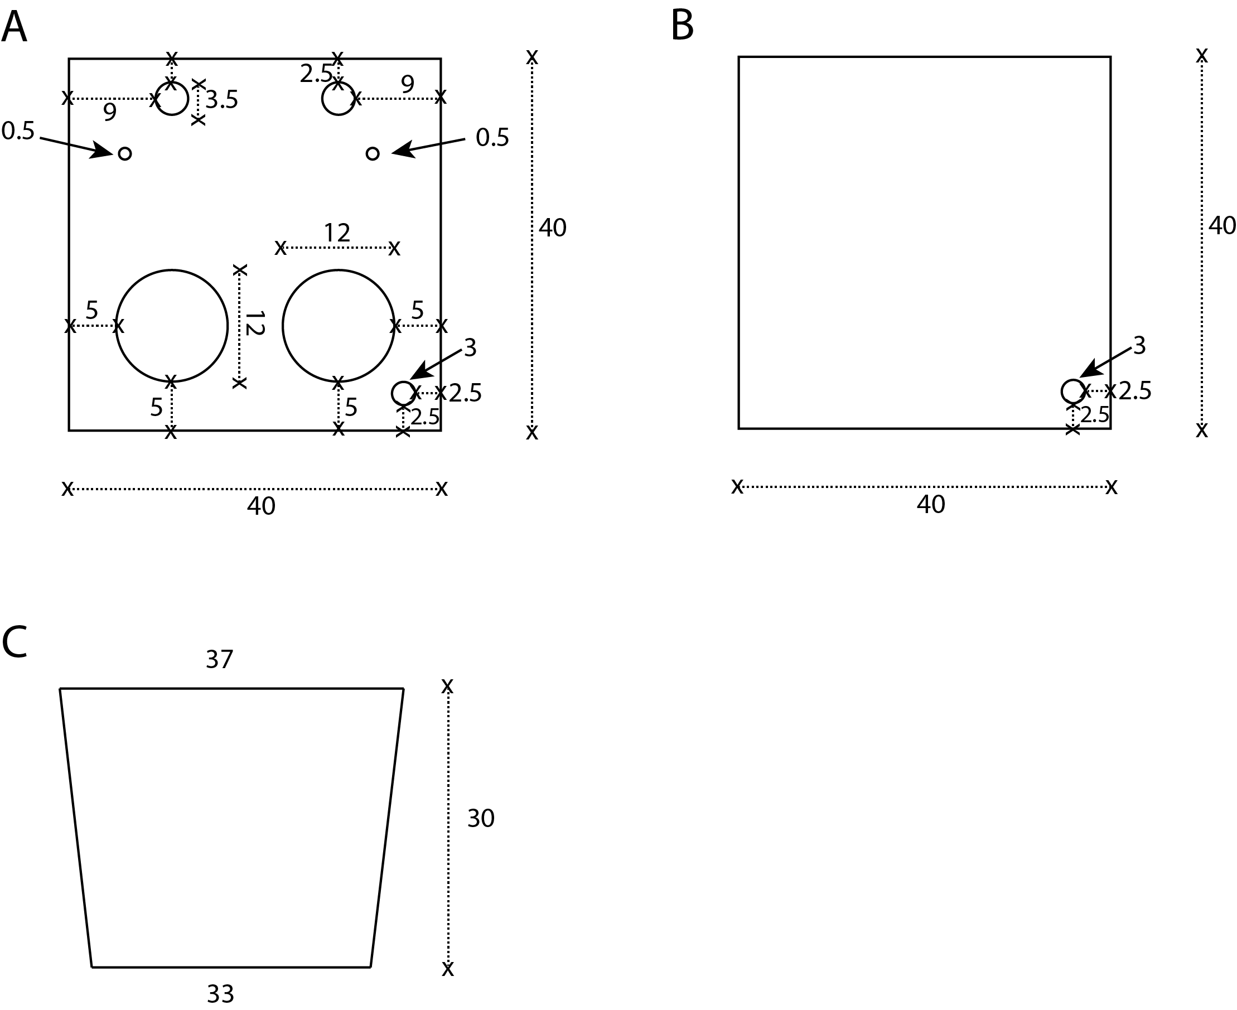
docs/images/progetto-addon/image1.png
