GabrieleZoppoli/terrarium-control-system/docs/images/progetto-addon/image2.png

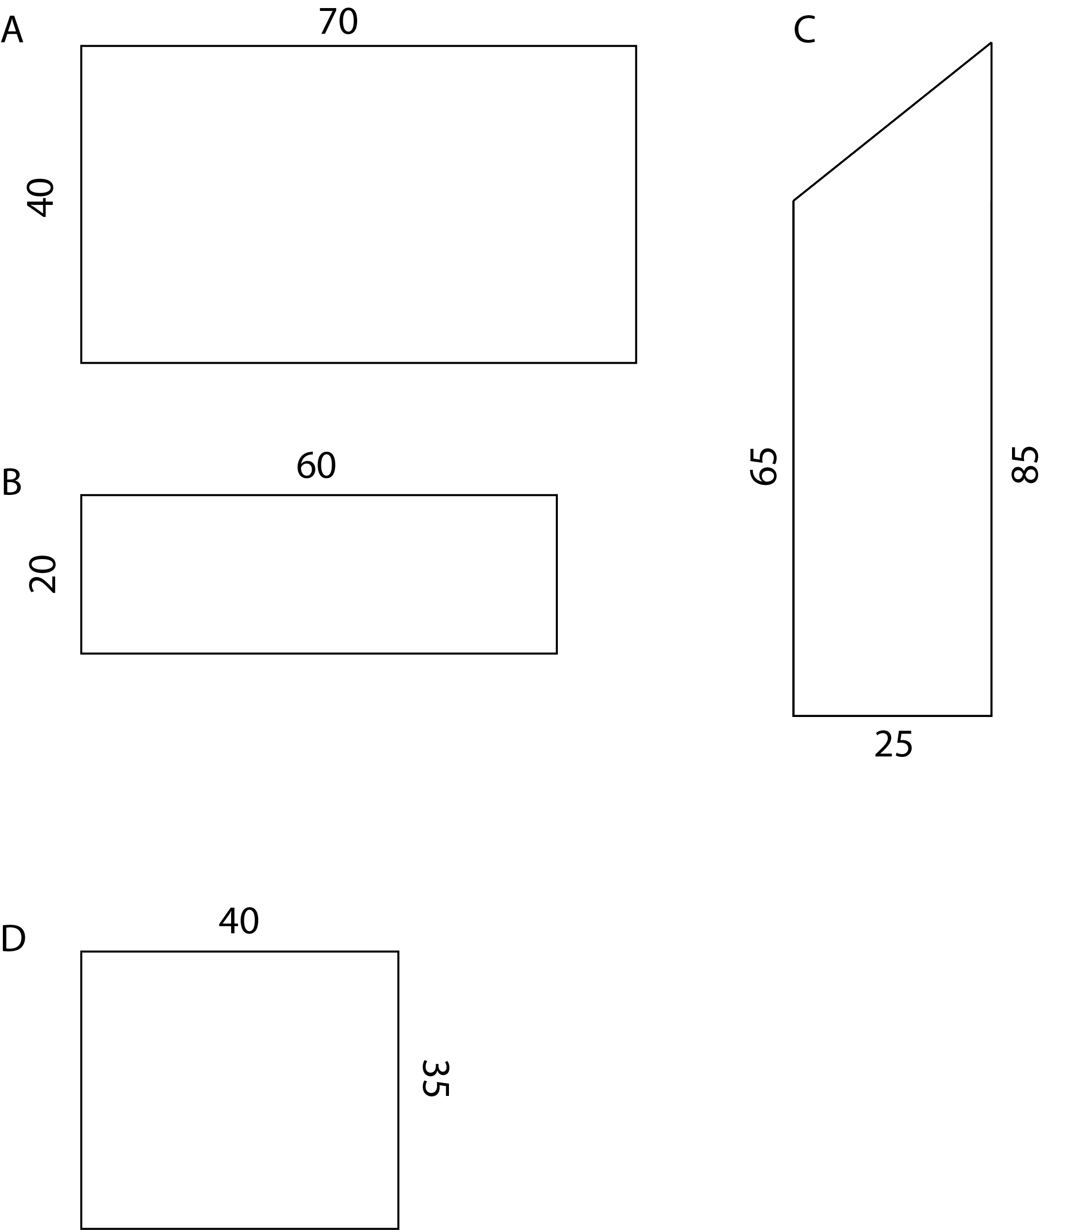
docs/images/progetto-addon/image2.png
