GabrieleZoppoli/terrarium-control-system/docs/images/progetto-addon/image3.png

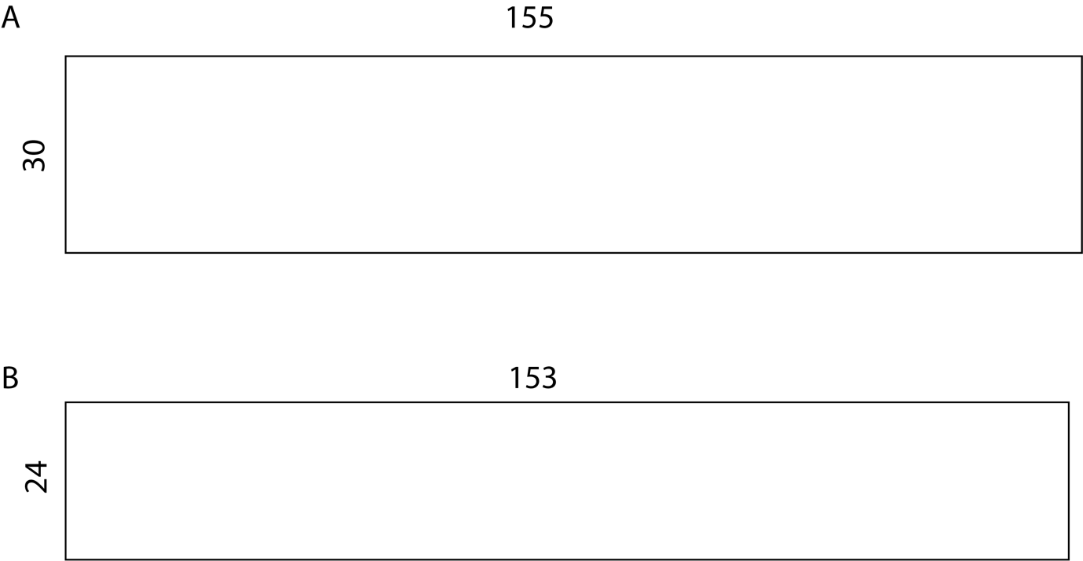
docs/images/progetto-addon/image3.png
