GabrieleZoppoli/terrarium-control-system/docs/images/progetto-addon/image4.png

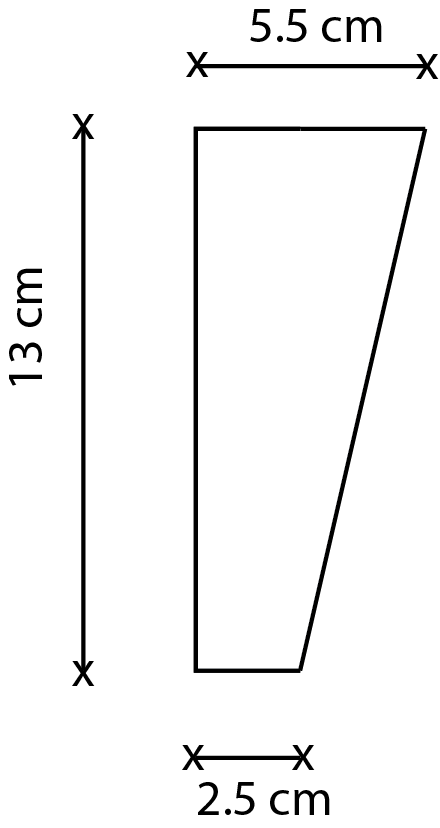
docs/images/progetto-addon/image4.png
