GabrieleZoppoli/terrarium-control-system/docs/images/progetto-completo/image1.png

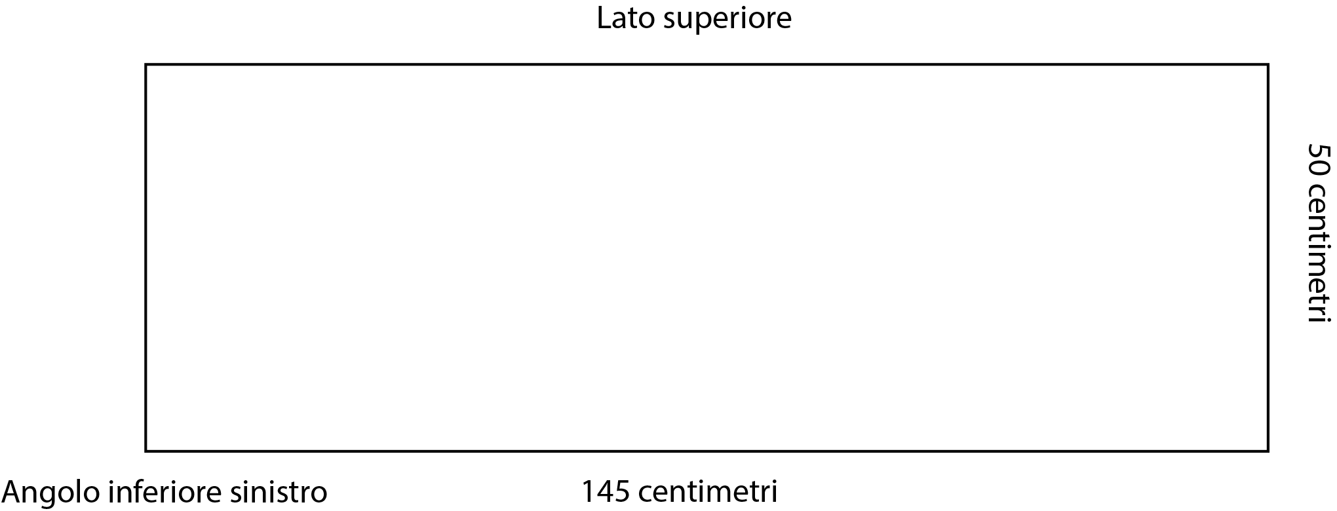
docs/images/progetto-completo/image1.png
