GabrieleZoppoli/terrarium-control-system/docs/images/progetto-completo/image2.png

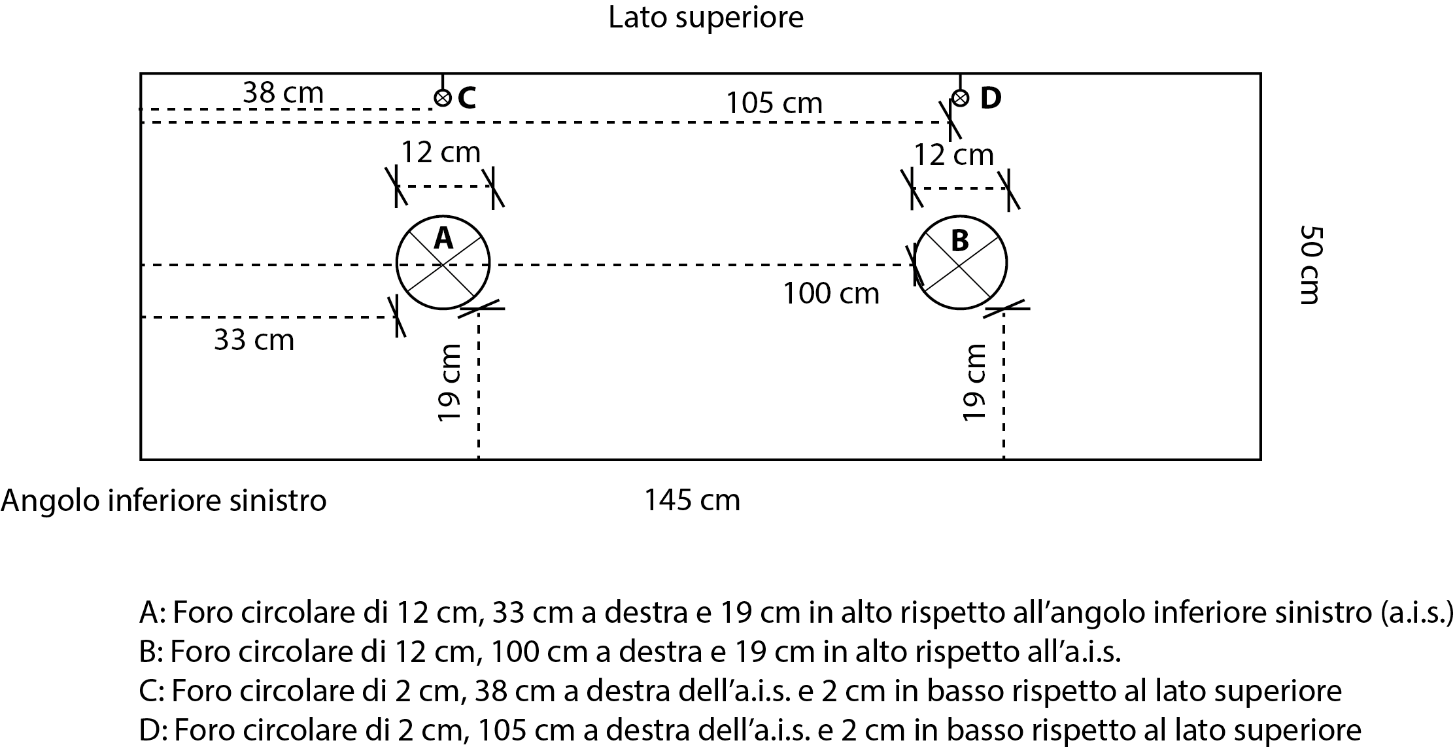
docs/images/progetto-completo/image2.png
