GabrieleZoppoli/terrarium-control-system/docs/images/progetto-completo/image3.png

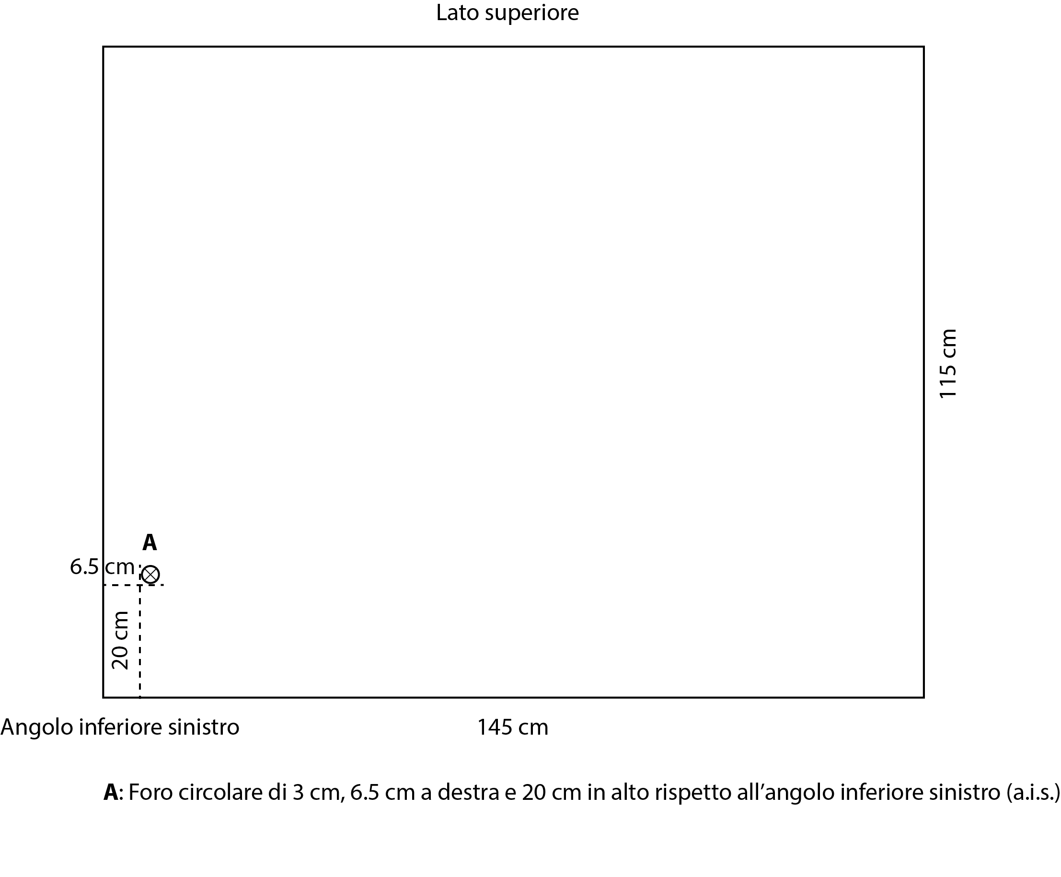
docs/images/progetto-completo/image3.png
