GabrieleZoppoli/terrarium-control-system/docs/images/progetto-completo/image4.png

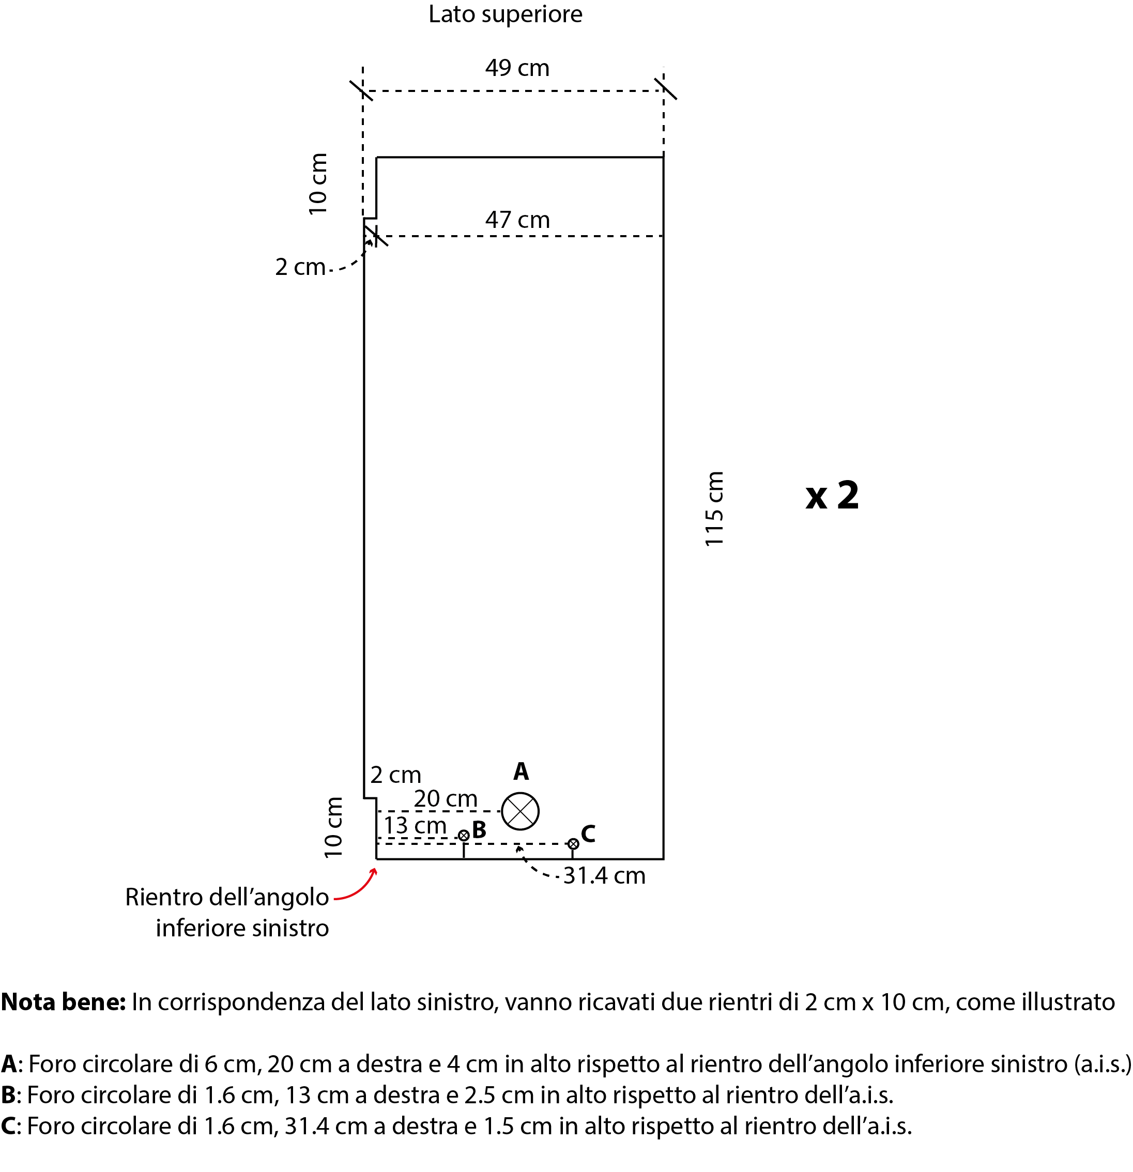
docs/images/progetto-completo/image4.png
