GabrieleZoppoli/terrarium-control-system/docs/images/progetto-completo/image5.png

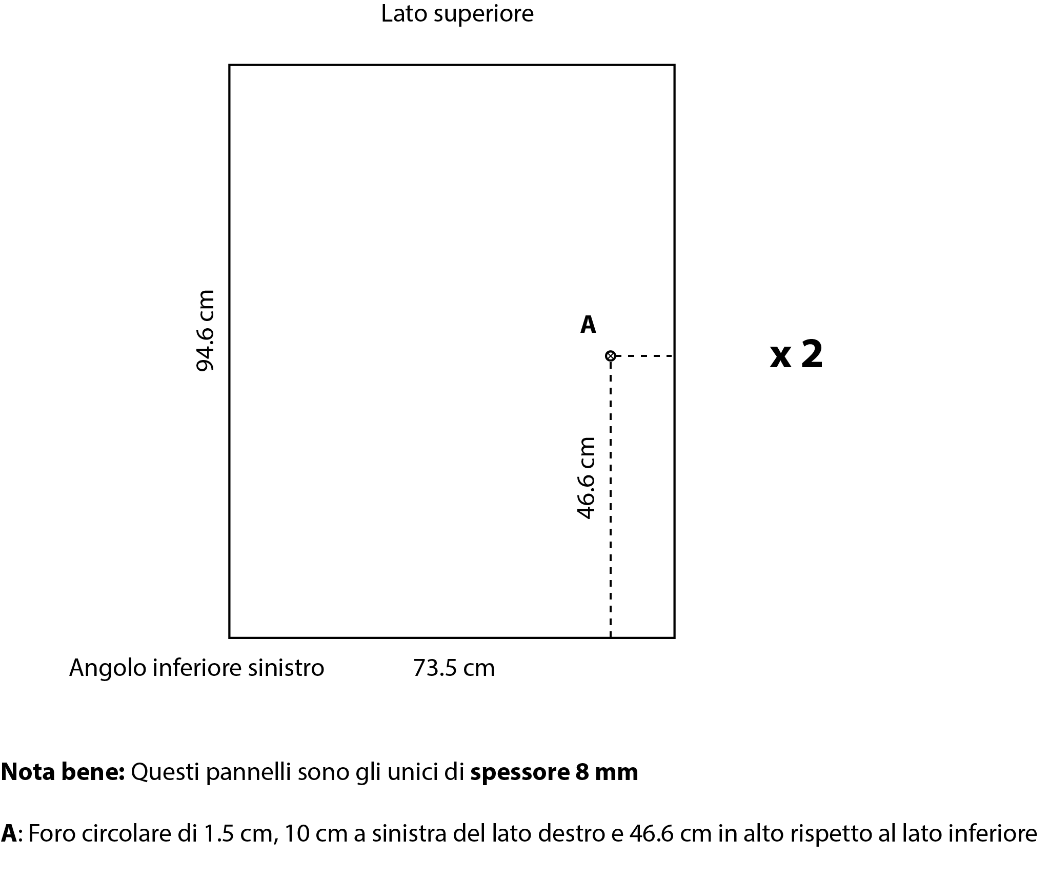
docs/images/progetto-completo/image5.png
