GabrieleZoppoli/terrarium-control-system/docs/images/progetto-completo/image6.png

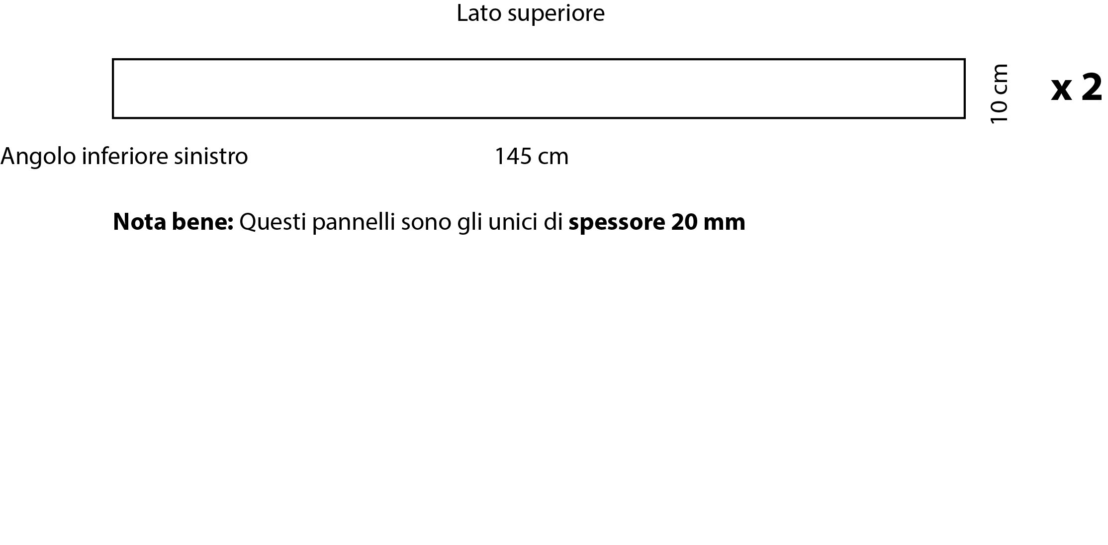
docs/images/progetto-completo/image6.png
