GabrieleZoppoli/terrarium-control-system/docs/images/progetto-completo/image7.png

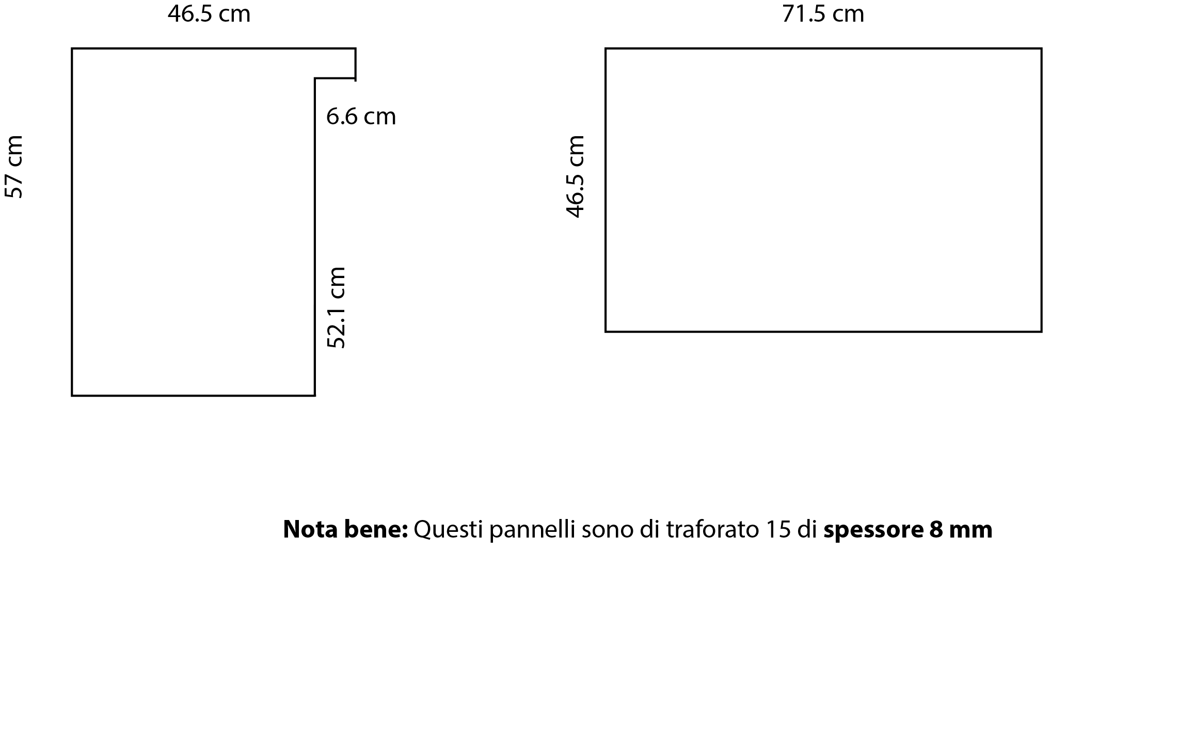
docs/images/progetto-completo/image7.png
