GabrieleZoppoli/terrarium-control-system/docs/images/progetto-completo/image8.png

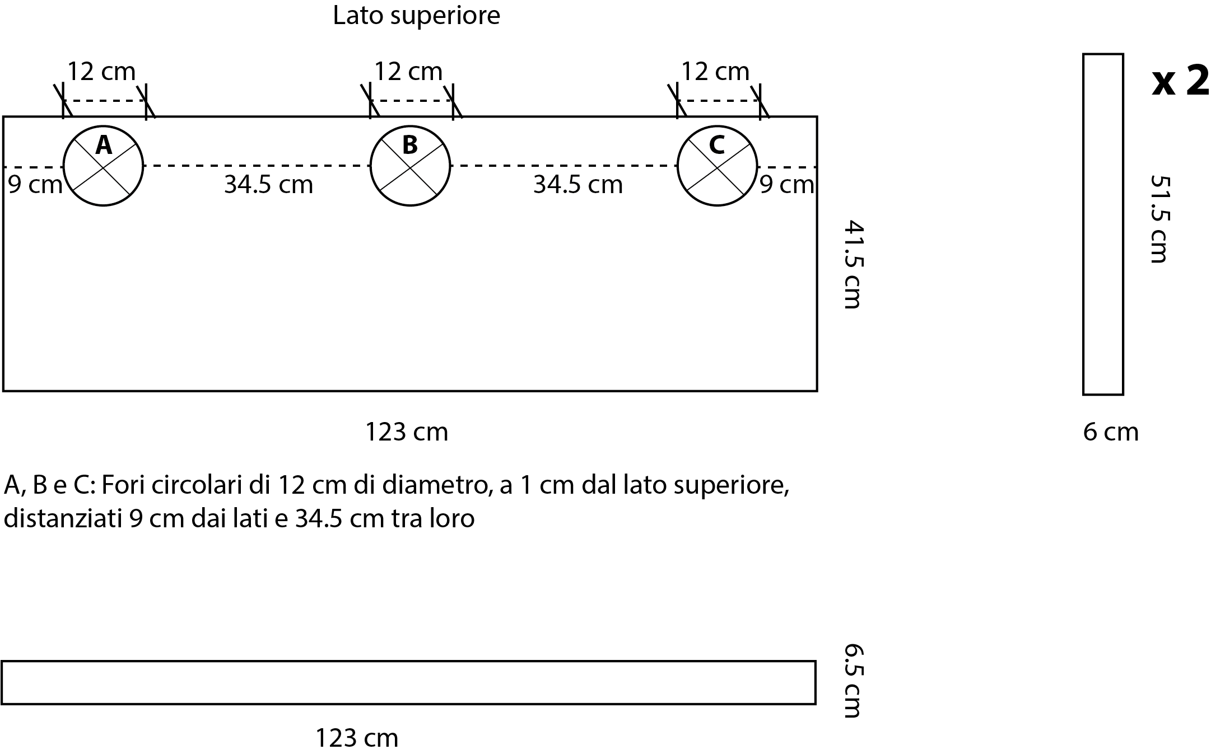
docs/images/progetto-completo/image8.png
