GabrieleZoppoli/terrarium-control-system/docs/images/progetto-completo/image9.png

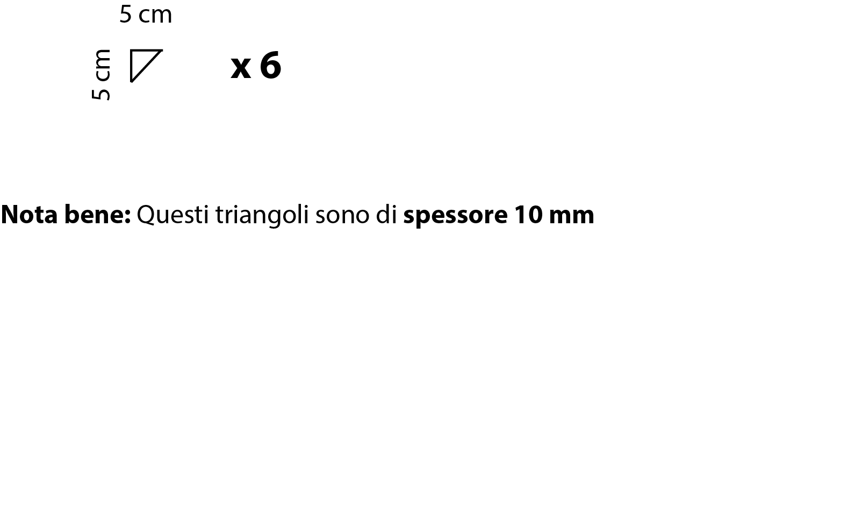
docs/images/progetto-completo/image9.png
