GabrieleZoppoli/terrarium-control-system/docs/images/progetto-completo/image10.png

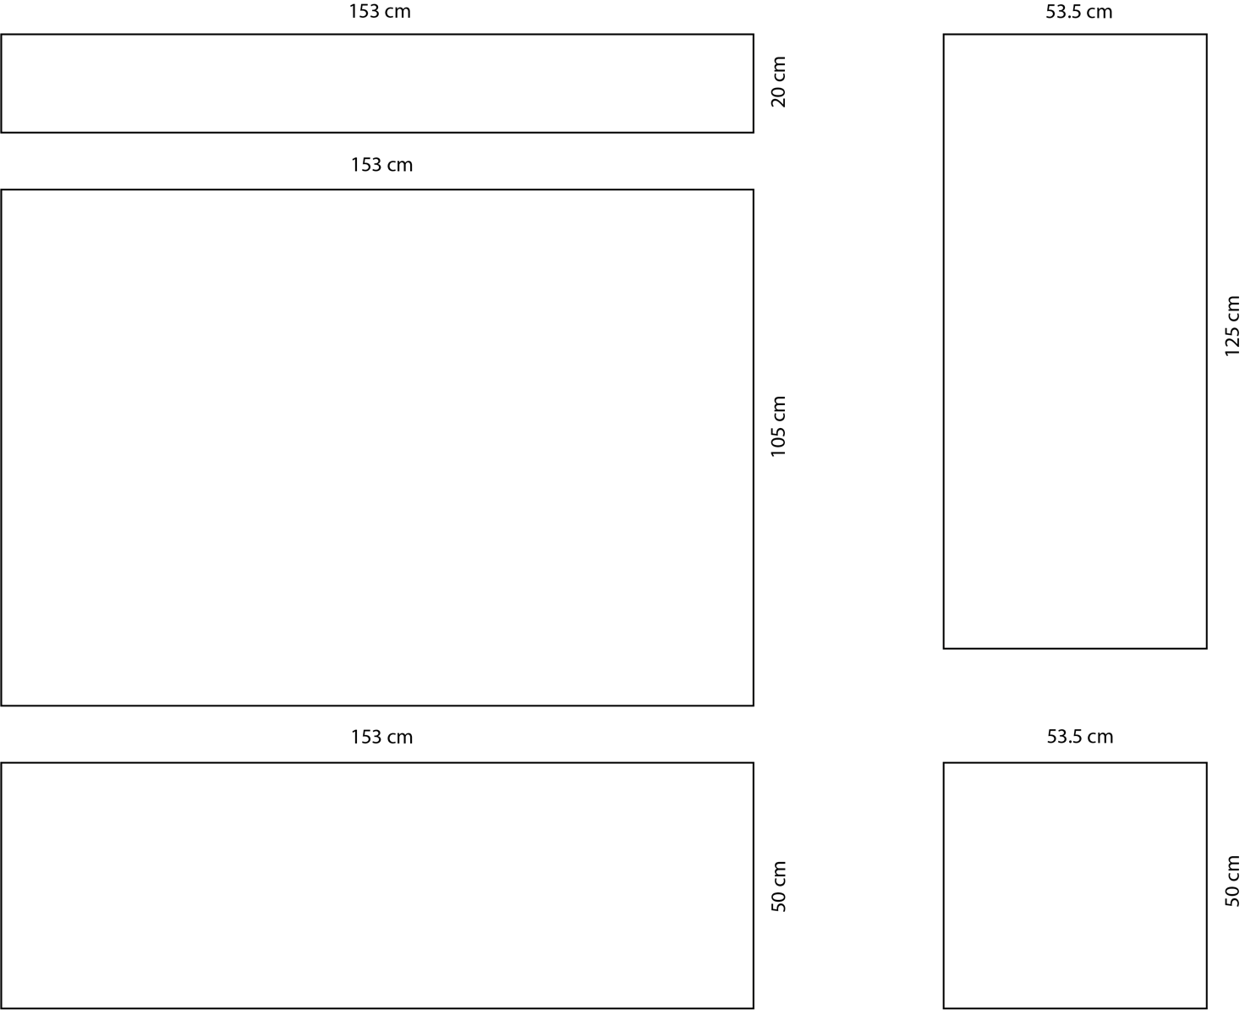
docs/images/progetto-completo/image10.png
