GabrieleZoppoli/terrarium-control-system/paper/figures/fig3_power_profile.png

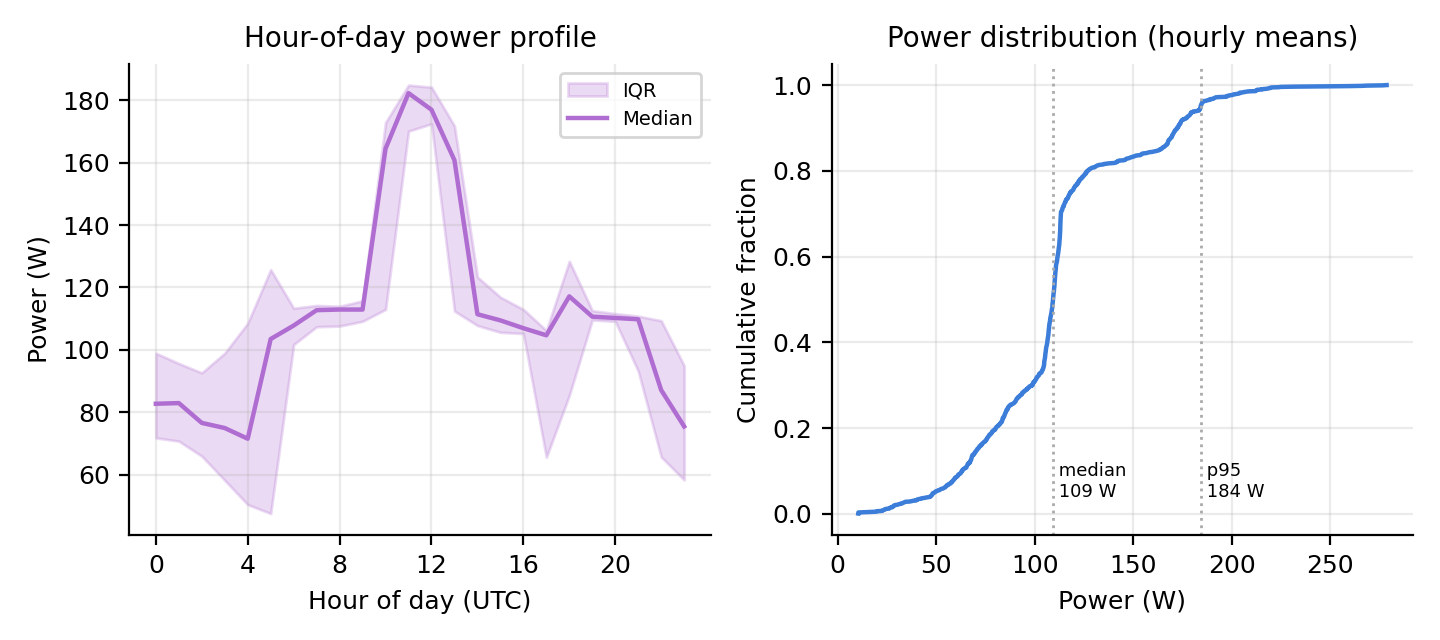
paper/figures/fig3_power_profile.png
