GabrieleZoppoli/terrarium-control-system/paper/figures/fig4_pid_response.png

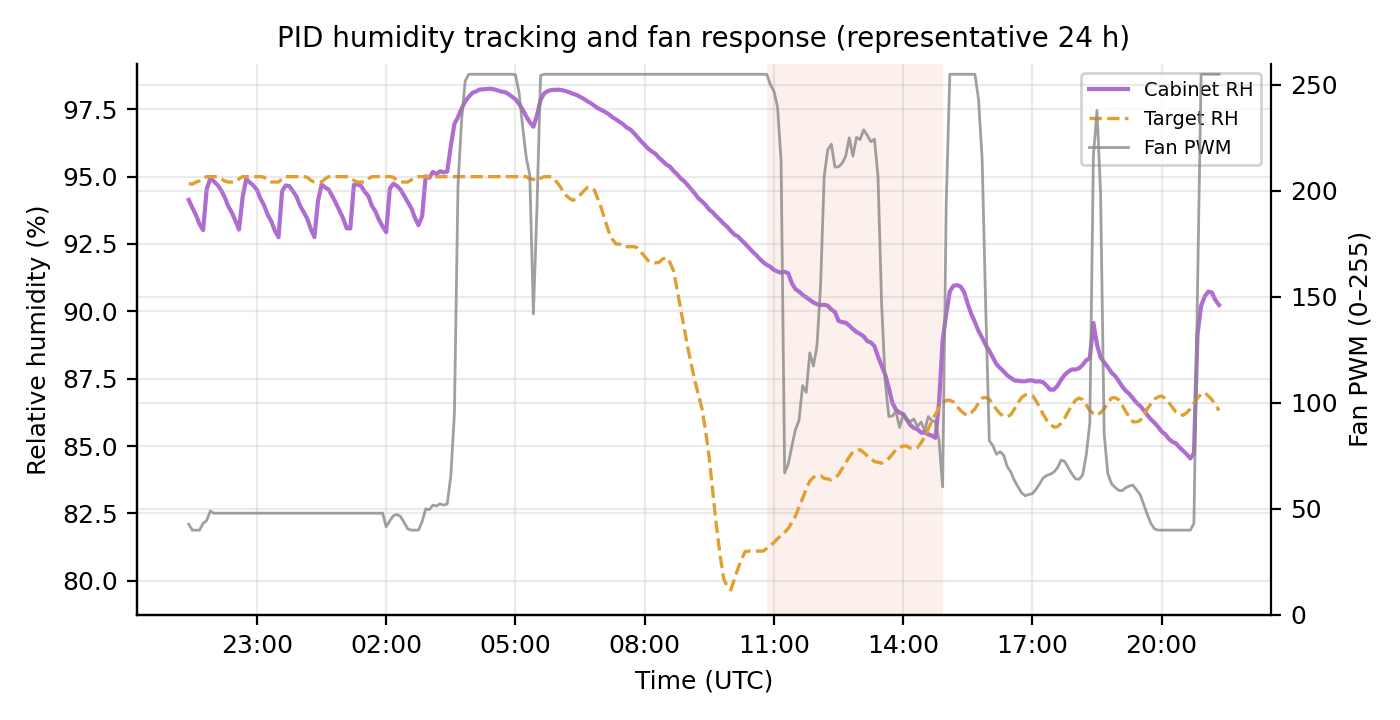
paper/figures/fig4_pid_response.png
