GabrieleZoppoli/terrarium-control-system/paper/figures/fig5_safety_chain_timeline.png

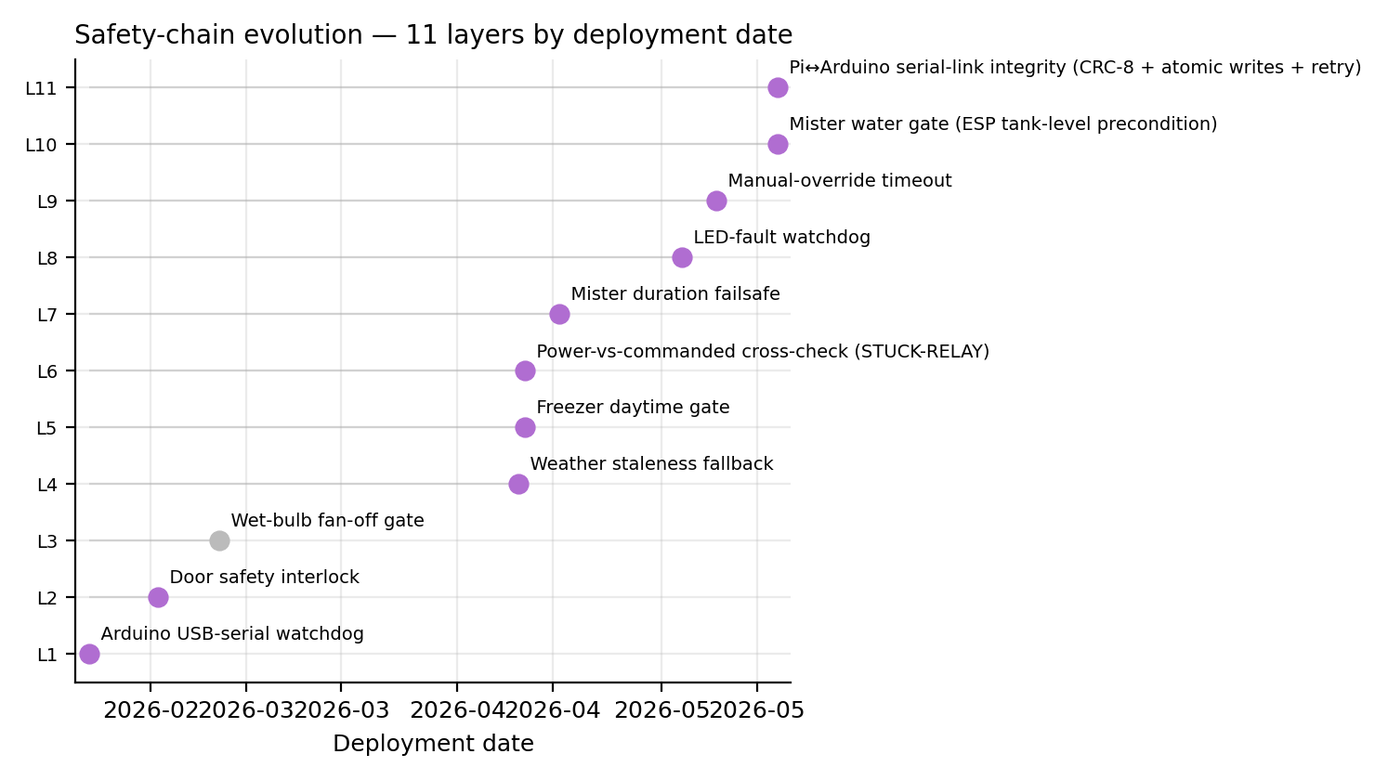
paper/figures/fig5_safety_chain_timeline.png
