GabrieleZoppoli/terrarium-control-system/website/content/blog/highland-cabinet-deep-clean/canalina.jpg

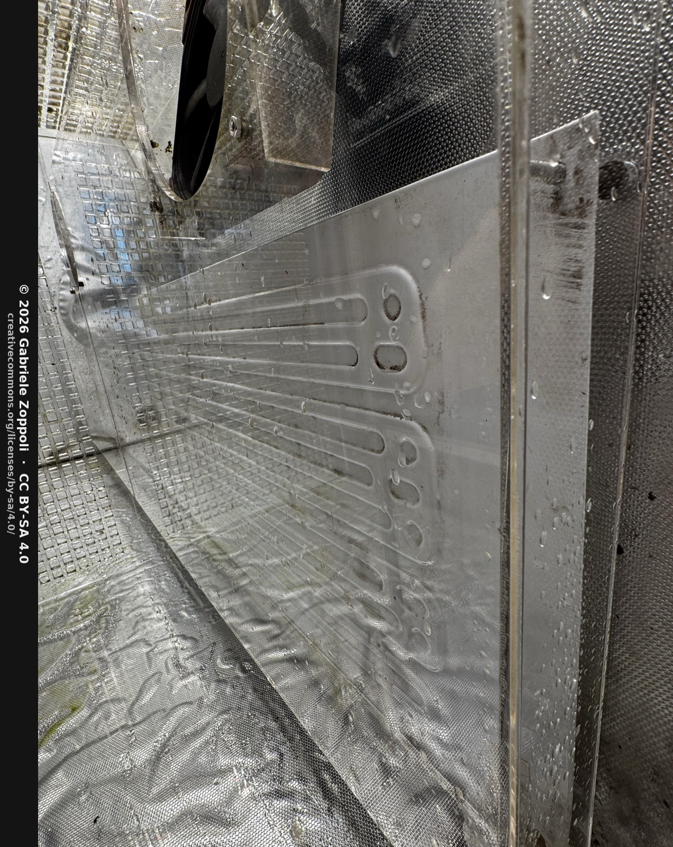
website/content/blog/highland-cabinet-deep-clean/canalina.jpg
