GabrieleZoppoli/terrarium-control-system/website/content/blog/highland-cabinet-deep-clean/evacuation.jpg

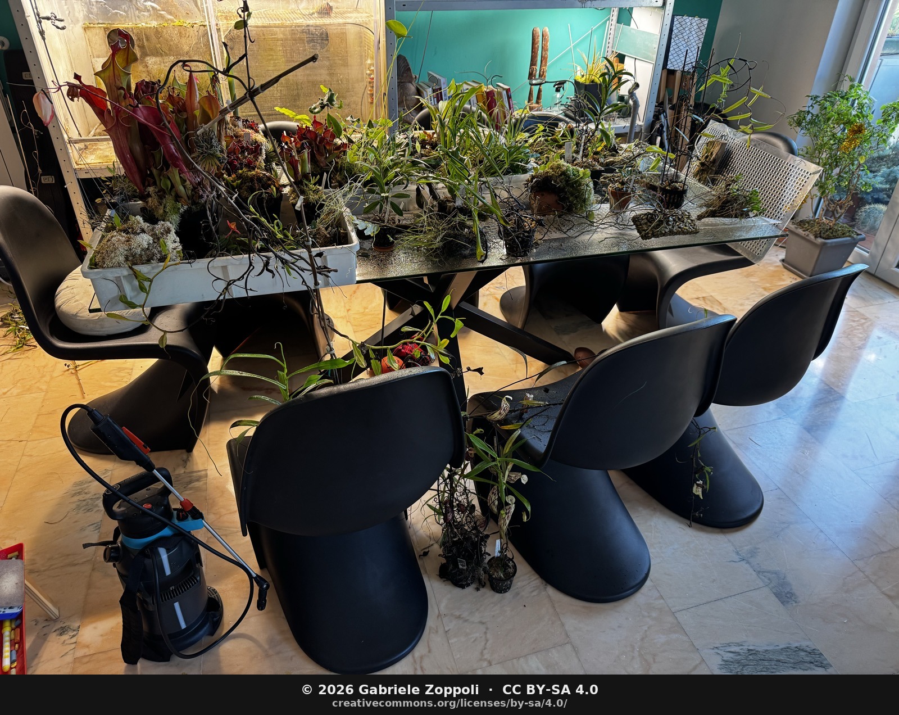
website/content/blog/highland-cabinet-deep-clean/evacuation.jpg
