GabrieleZoppoli/terrarium-control-system/website/content/blog/highland-cabinet-deep-clean/fan-array.jpg

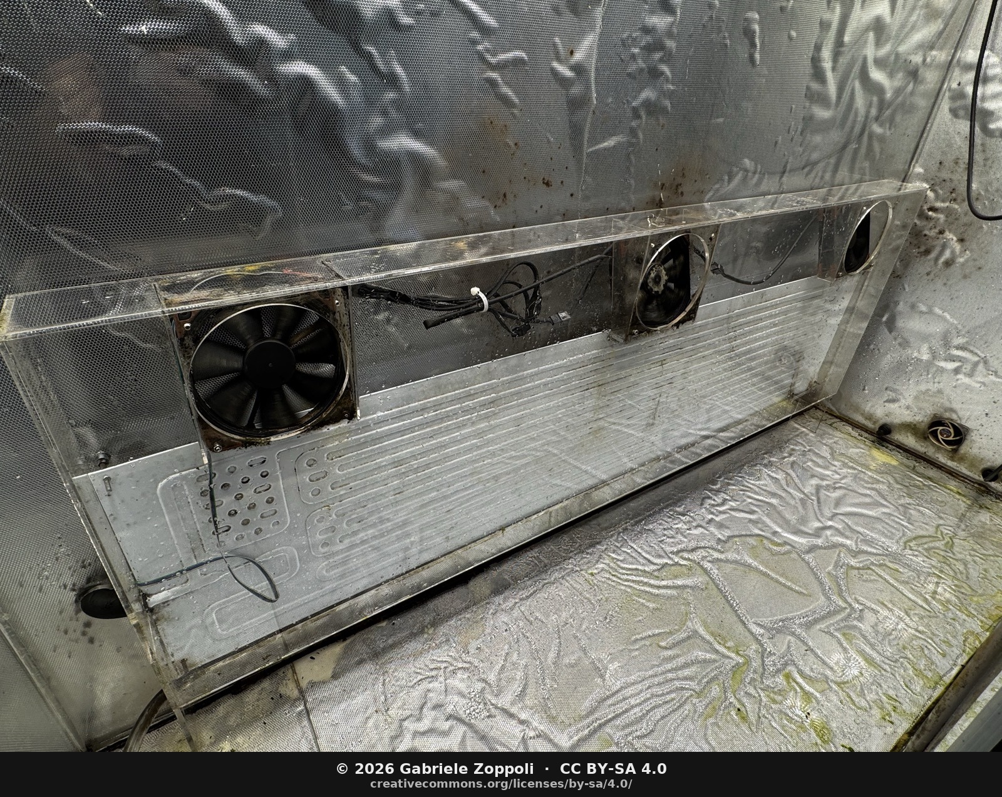
website/content/blog/highland-cabinet-deep-clean/fan-array.jpg
