GabrieleZoppoli/terrarium-control-system/website/content/blog/highland-cabinet-deep-clean/mold-corner.jpg

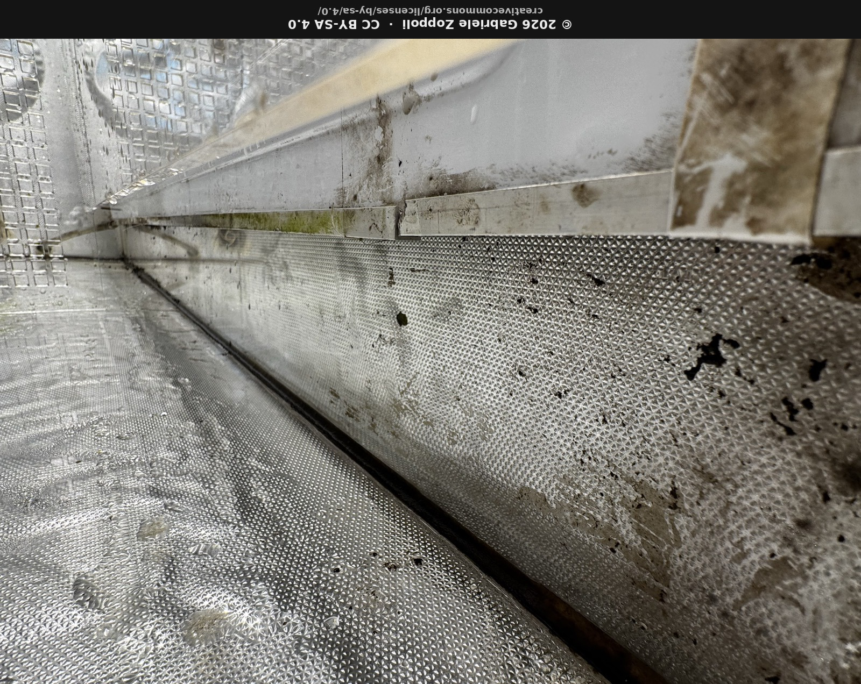
website/content/blog/highland-cabinet-deep-clean/mold-corner.jpg
