GabrieleZoppoli/terrarium-control-system/website/content/blog/highland-cabinet-deep-clean/recrimping-fan.jpg

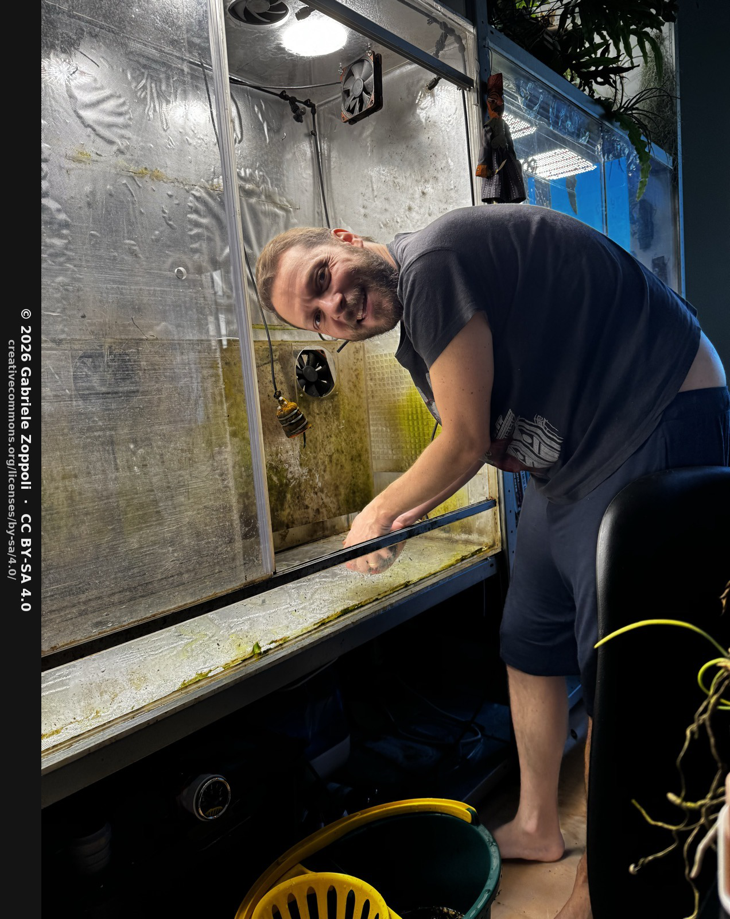
website/content/blog/highland-cabinet-deep-clean/recrimping-fan.jpg
