GabrieleZoppoli/terrarium-control-system/website/content/blog/light-curve-c/afternoon-creep.png

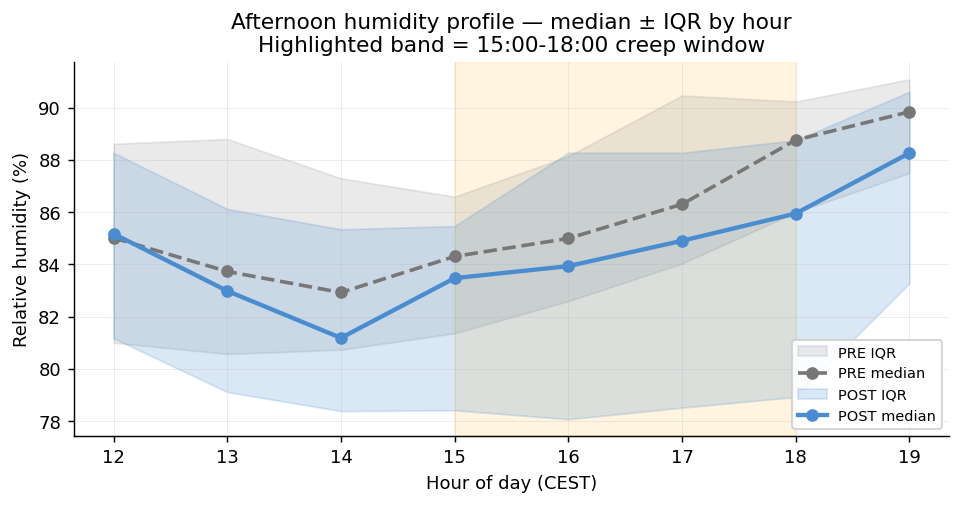
website/content/blog/light-curve-c/afternoon-creep.png
