GabrieleZoppoli/terrarium-control-system/website/content/blog/light-curve-c/curve-comparison.png

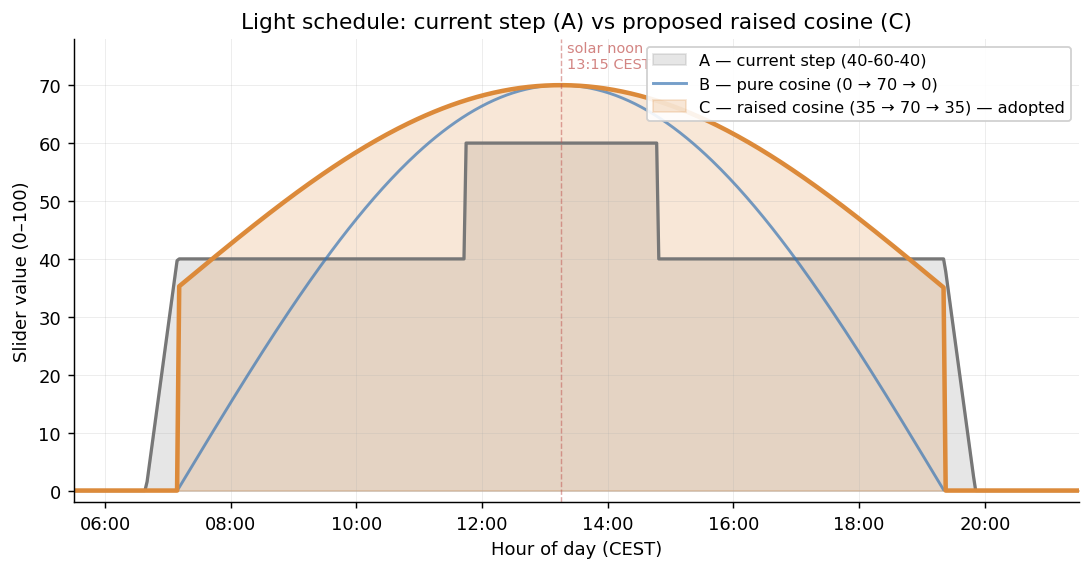
website/content/blog/light-curve-c/curve-comparison.png
