GabrieleZoppoli/terrarium-control-system/website/content/blog/light-curve-c/day1-overview.png

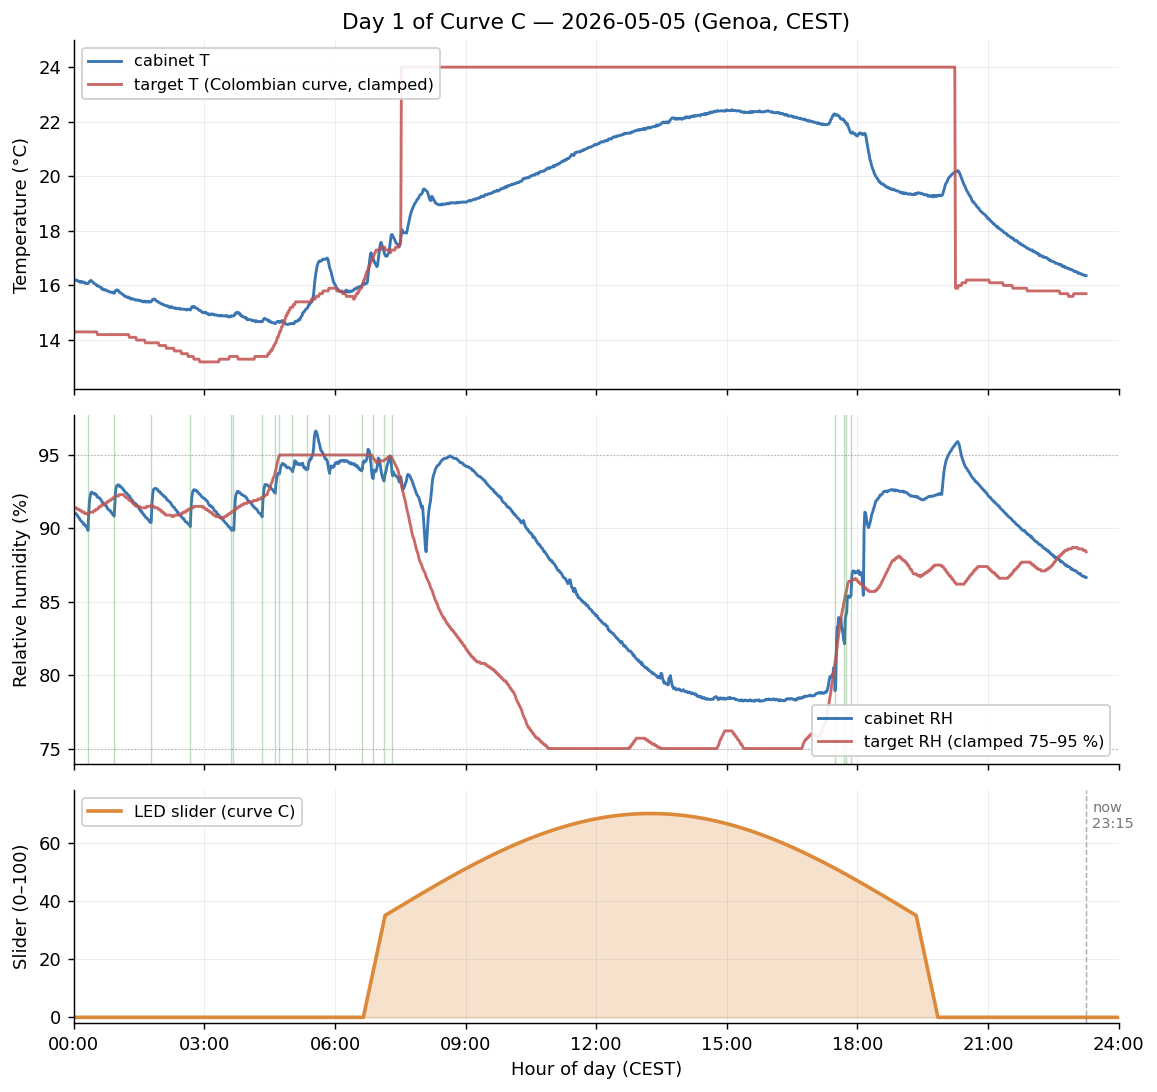
website/content/blog/light-curve-c/day1-overview.png
