GabrieleZoppoli/terrarium-control-system/website/content/blog/light-curve-c/delta-auc.png

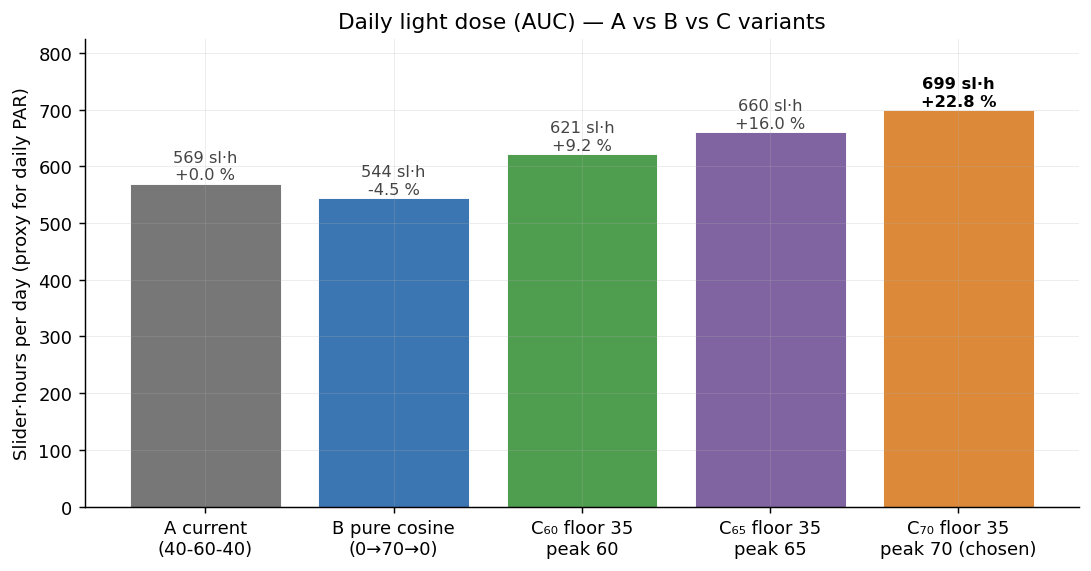
website/content/blog/light-curve-c/delta-auc.png
