GabrieleZoppoli/terrarium-control-system/website/content/blog/light-curve-c/humidity-3w.png

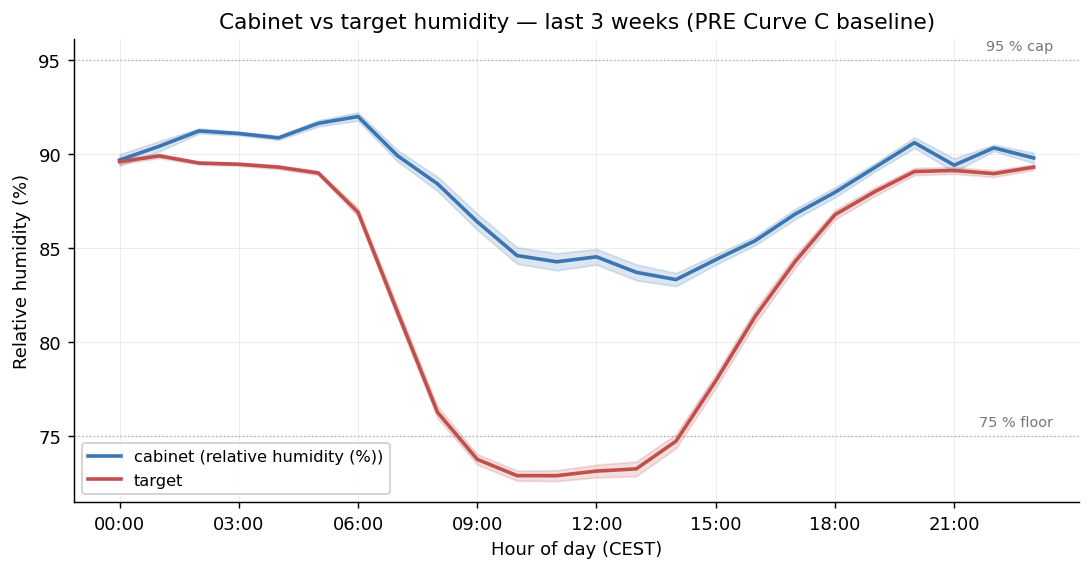
website/content/blog/light-curve-c/humidity-3w.png
