GabrieleZoppoli/terrarium-control-system/website/content/blog/light-curve-c/humidity-prepost.png

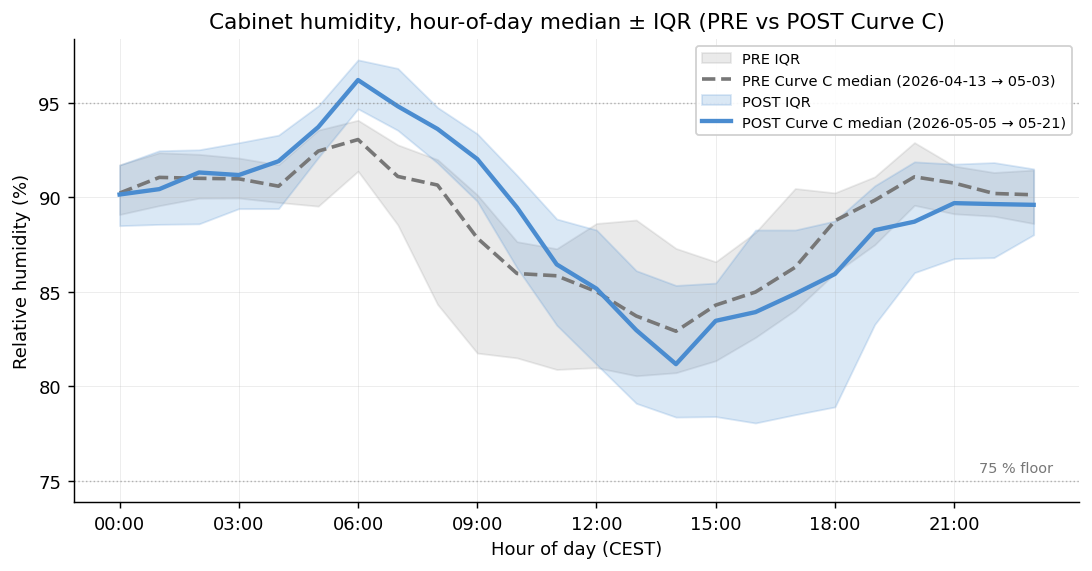
website/content/blog/light-curve-c/humidity-prepost.png
