GabrieleZoppoli/terrarium-control-system/website/content/blog/light-curve-c/mist-daily-prepost.png

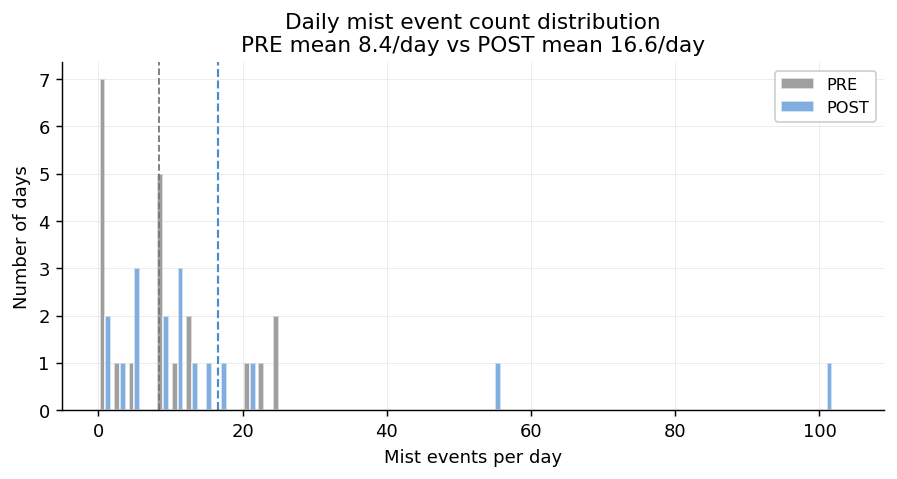
website/content/blog/light-curve-c/mist-daily-prepost.png
