GabrieleZoppoli/terrarium-control-system/website/content/blog/light-curve-c/mist-delta-distribution.png

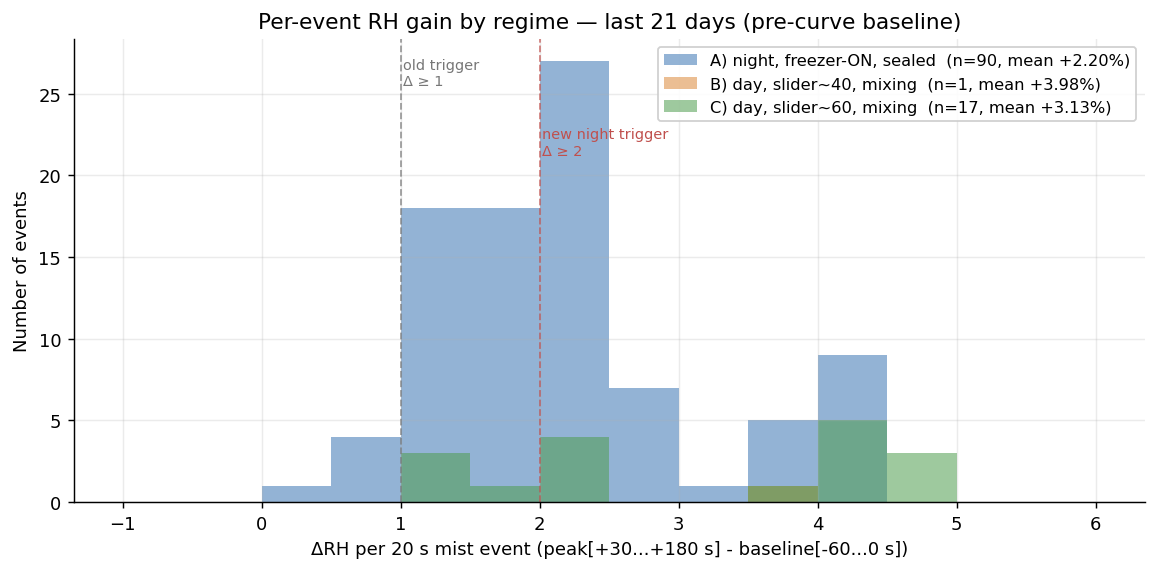
website/content/blog/light-curve-c/mist-delta-distribution.png
