GabrieleZoppoli/terrarium-control-system/website/content/blog/light-curve-c/pwm-outlet-3w.png

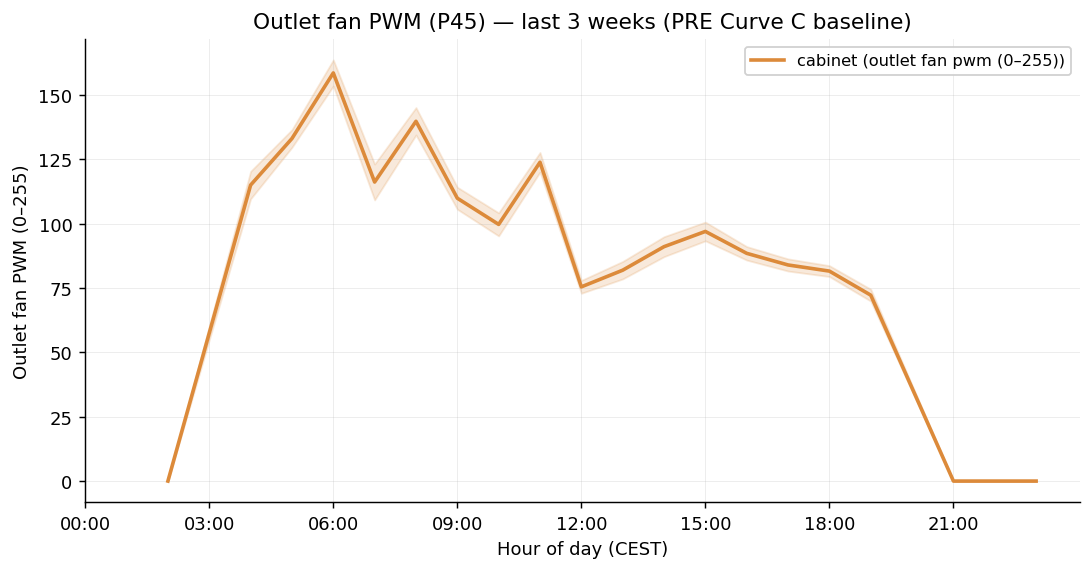
website/content/blog/light-curve-c/pwm-outlet-3w.png
