GabrieleZoppoli/terrarium-control-system/website/content/blog/light-curve-c/pwm-outlet-prepost.png

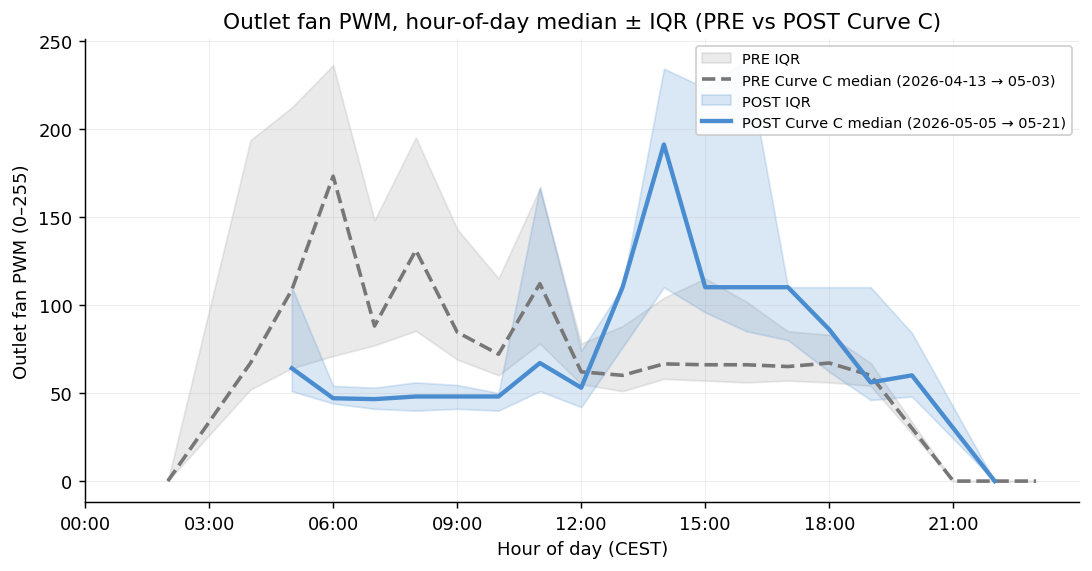
website/content/blog/light-curve-c/pwm-outlet-prepost.png
