GabrieleZoppoli/terrarium-control-system/website/content/blog/light-curve-c/temperature-3w.png

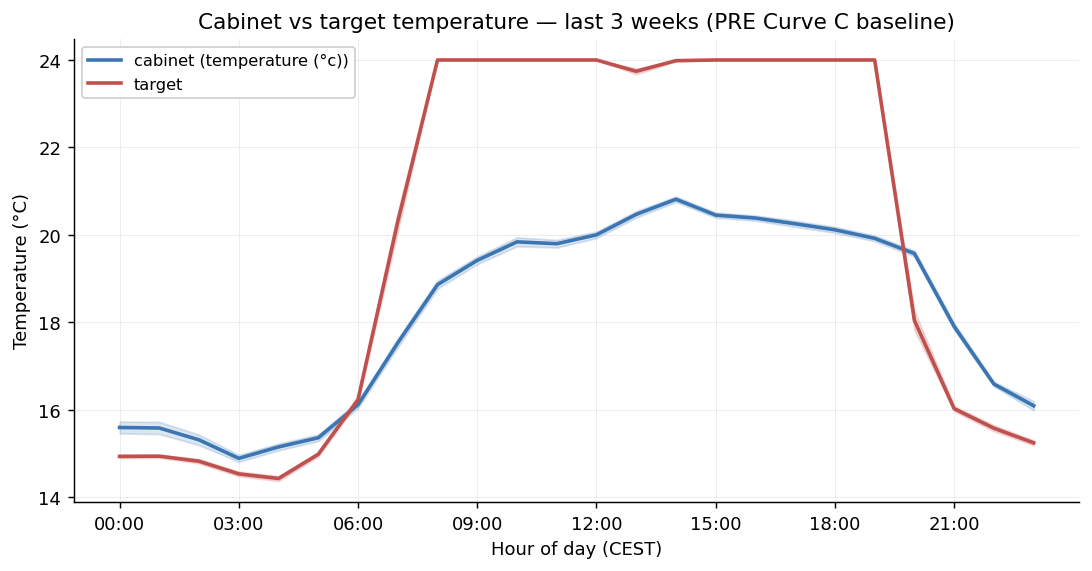
website/content/blog/light-curve-c/temperature-3w.png
