GabrieleZoppoli/terrarium-control-system/website/content/blog/light-curve-c/temperature-prepost.png

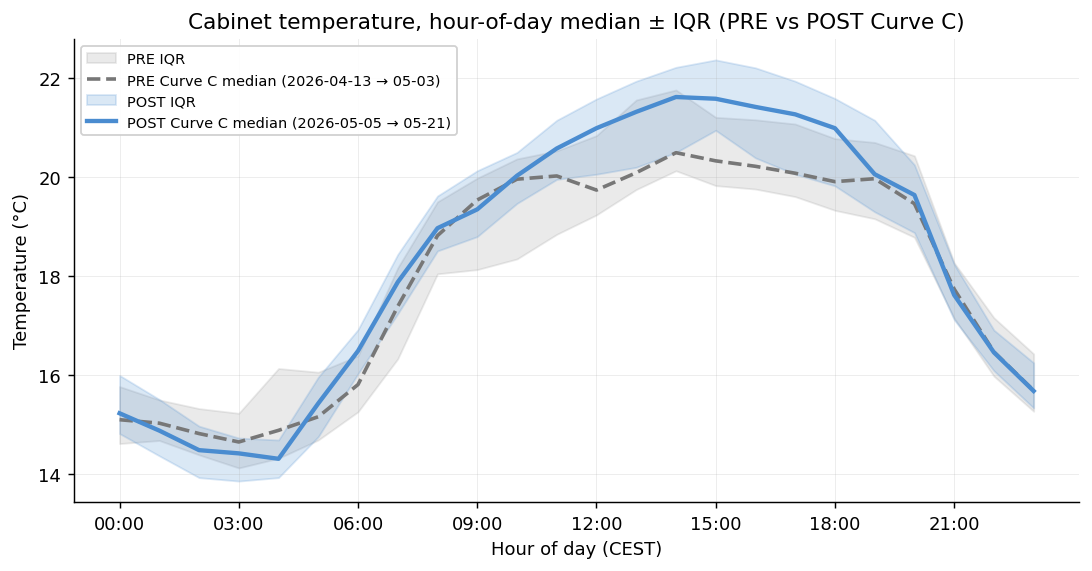
website/content/blog/light-curve-c/temperature-prepost.png
