GabrieleZoppoli/terrarium-control-system/website/content/blog/species-of-the-week-cymbidium-goeringii-tian-cao/substrate-bottom.jpg

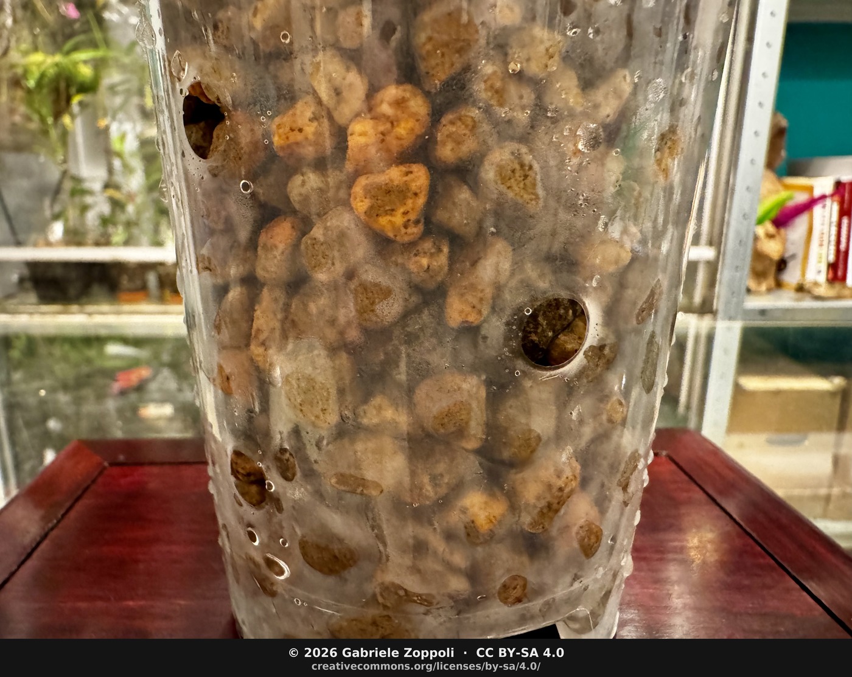
website/content/blog/species-of-the-week-cymbidium-goeringii-tian-cao/substrate-bottom.jpg
