GabrieleZoppoli/terrarium-control-system/website/content/blog/species-of-the-week-cymbidium-goeringii-tian-cao/substrate-column.jpg

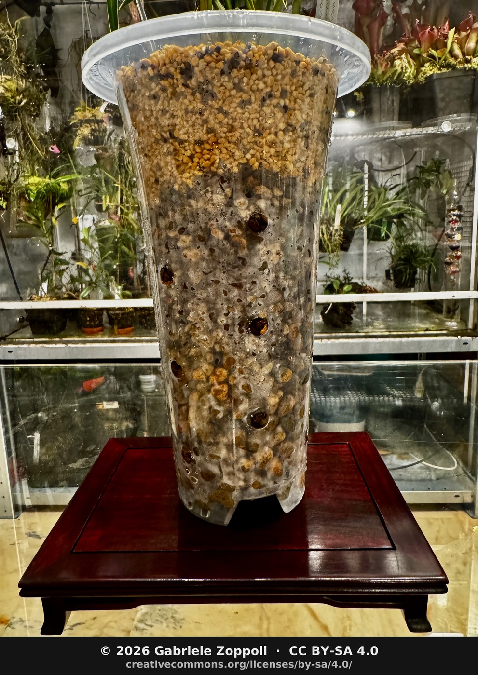
website/content/blog/species-of-the-week-cymbidium-goeringii-tian-cao/substrate-column.jpg
