GabrieleZoppoli/terrarium-control-system/website/content/blog/species-of-the-week-heliamphora-macdonaldae-cerro-duida-isc/holotype-ny00387773.jpg

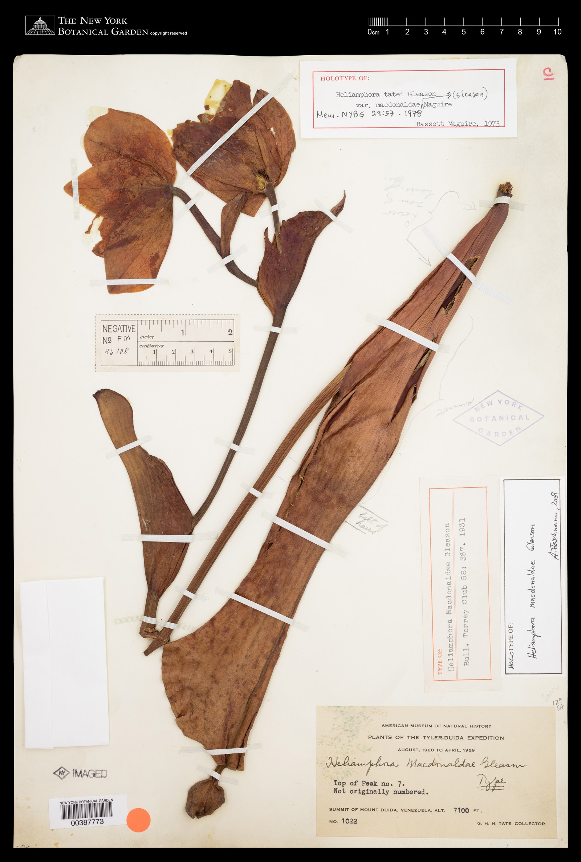
website/content/blog/species-of-the-week-heliamphora-macdonaldae-cerro-duida-isc/holotype-ny00387773.jpg
