GabrieleZoppoli/terrarium-control-system/(list of files, drawings)

Other design files:
website/static/zeer-pot/zeer-pot-v24.fzz
