GabrieleZoppoli/terrarium-control-system/analysis/cooling_test_report.py

#!/usr/bin/env python3
"""
Maximum Cooling Capacity Test — Report Generator

Reads test window from /tmp/cooling_test_times.txt (epoch_ms_start,epoch_ms_end)
or accepts CLI args: --start 'YYYY-MM-DDTHH:MM:SS' --end 'YYYY-MM-DDTHH:MM:SS' (UTC)

Queries InfluxDB for the test period, generates charts, stats, and paper note drafts.
"""

import subprocess
import json
import sys
from datetime import datetime, timedelta
import os

try:
    import matplotlib
    matplotlib.use('Agg')
    import matplotlib.pyplot as plt
    import matplotlib.dates as mdates
    from matplotlib.ticker import MultipleLocator
    import numpy as np
except ImportError:
    print("Installing matplotlib and numpy...")
    subprocess.check_call([sys.executable, '-m', 'pip', 'install', 'matplotlib', 'numpy'])
    import matplotlib
    matplotlib.use('Agg')
    import matplotlib.pyplot as plt
    import matplotlib.dates as mdates
    from matplotlib.ticker import MultipleLocator
    import numpy as np


def query_influx(query):
    """Query InfluxDB and return parsed results."""
    cmd = ['influx', '-database', 'highland', '-precision', 'rfc3339', '-execute', query, '-format', 'json']
    result = subprocess.run(cmd, capture_output=True, text=True)
    if result.returncode != 0:
        print(f"InfluxDB error: {result.stderr}")
        return []
    try:
        data = json.loads(result.stdout)
        if 'results' in data and data['results']:
            for r in data['results']:
                if 'series' in r:
                    return r['series']
        return []
    except json.JSONDecodeError:
        return []


def series_to_arrays(series, time_col=0, val_col=1):
    """Convert InfluxDB series to numpy arrays of datetime and float values."""
    times = []
    values = []
    if not series:
        return np.array([]), np.array([])
    for row in series[0].get('values', []):
        try:
            t = datetime.strptime(row[time_col][:19], '%Y-%m-%dT%H:%M:%S')
            v = float(row[val_col]) if row[val_col] is not None else np.nan
            times.append(t)
            values.append(v)
        except (ValueError, TypeError, IndexError):
            continue
    return np.array(times), np.array(values)


def find_test_window():
    """Find test start/end times from CLI args, times file, or hardcoded fallback."""
    import argparse
    parser = argparse.ArgumentParser()
    parser.add_argument('--start', help='UTC start time (YYYY-MM-DDTHH:MM:SS)')
    parser.add_argument('--end', help='UTC end time (YYYY-MM-DDTHH:MM:SS)')
    args, _ = parser.parse_known_args()

    if args.start and args.end:
        test_start = datetime.strptime(args.start, '%Y-%m-%dT%H:%M:%S')
        test_end = datetime.strptime(args.end, '%Y-%m-%dT%H:%M:%S')
        print(f"  Source: CLI arguments")
        return test_start, test_end

    # Try /tmp/cooling_test_times.txt (written by Node-RED: "epoch_ms_start,epoch_ms_end")
    times_file = '/tmp/cooling_test_times.txt'
    if os.path.exists(times_file):
        try:
            with open(times_file) as f:
                parts = f.read().strip().split(',')
            start_ms = int(parts[0])
            end_ms = int(parts[1])
            test_start = datetime.utcfromtimestamp(start_ms / 1000)
            test_end = datetime.utcfromtimestamp(end_ms / 1000)
            print(f"  Source: {times_file}")
            return test_start, test_end
        except Exception as e:
            print(f"  Warning: could not parse {times_file}: {e}")

    # Hardcoded fallback: test #1
    print(f"  Source: hardcoded fallback (test #1)")
    test_start = datetime.strptime('2026-02-26T18:47:00', '%Y-%m-%dT%H:%M:%S')
    test_end = datetime.strptime('2026-02-27T04:19:00', '%Y-%m-%dT%H:%M:%S')
    return test_start, test_end


def main():
    print("=" * 60)
    print("MAXIMUM COOLING CAPACITY TEST — REPORT")
    print("=" * 60)

    test_start, test_end = find_test_window()
    # Add 1h padding before and after for context
    query_start = (test_start - timedelta(hours=2)).strftime('%Y-%m-%dT%H:%M:%SZ')
    query_end = (test_end + timedelta(hours=2)).strftime('%Y-%m-%dT%H:%M:%SZ')
    ts = test_start.strftime('%Y-%m-%dT%H:%M:%SZ')
    te = test_end.strftime('%Y-%m-%dT%H:%M:%SZ')

    print(f"\nTest window: {test_start.strftime('%Y-%m-%d %H:%M')} → {test_end.strftime('%Y-%m-%d %H:%M')}")
    print(f"Duration: {(test_end - test_start).total_seconds()/3600:.1f} hours")
    print(f"Query window: ±2h padding\n")

    # Query all measurements
    measurements = {
        'local_temperature': f"SELECT value FROM local_temperature WHERE time >= '{query_start}' AND time <= '{query_end}'",
        'room_temperature': f"SELECT value FROM room_temperature WHERE time >= '{query_start}' AND time <= '{query_end}'",
        'local_humidity': f"SELECT value FROM local_humidity WHERE time >= '{query_start}' AND time <= '{query_end}'",
        'target_humidity': f"SELECT value FROM target_humidity WHERE time >= '{query_start}' AND time <= '{query_end}'",
        'fan_speed': f"SELECT value FROM fan_speed WHERE time >= '{query_start}' AND time <= '{query_end}'",
        'freezer_status': f"SELECT value FROM freezer_status WHERE time >= '{query_start}' AND time <= '{query_end}'",
        'fan_pwm_outlet': f"SELECT value FROM fan_pwm_outlet WHERE time >= '{query_start}' AND time <= '{query_end}'",
        'fan_pwm_impeller': f"SELECT value FROM fan_pwm_impeller WHERE time >= '{query_start}' AND time <= '{query_end}'",
        'fan_pwm_freezer': f"SELECT value FROM fan_pwm_freezer WHERE time >= '{query_start}' AND time <= '{query_end}'",
        'fan_pwm_circulation': f"SELECT value FROM fan_pwm_circulation WHERE time >= '{query_start}' AND time <= '{query_end}'",
        'light_status': f"SELECT value FROM light_status WHERE time >= '{query_start}' AND time <= '{query_end}'",
        'room_humidity': f"SELECT value FROM room_humidity WHERE time >= '{query_start}' AND time <= '{query_end}'",
        'vpd': f"SELECT value FROM vpd WHERE time >= '{query_start}' AND time <= '{query_end}'",
        'wbt_shutdown_active': f"SELECT value FROM wbt_shutdown_active WHERE time >= '{query_start}' AND time <= '{query_end}'",
        'power_consumption': f"SELECT value FROM power_consumption WHERE time >= '{query_start}' AND time <= '{query_end}'",
        'mister_status': f"SELECT value FROM mister_status WHERE time >= '{query_start}' AND time <= '{query_end}'",
    }

    data = {}
    for name, q in measurements.items():
        series = query_influx(q)
        times, vals = series_to_arrays(series)
        data[name] = (times, vals)
        if len(times) > 0:
            print(f"  {name}: {len(times)} points")
        else:
            print(f"  {name}: NO DATA")

    # === STATISTICS (during test window only) ===
    print("\n" + "=" * 60)
    print("STATISTICS (during test window)")
    print("=" * 60)

    def window_stats(times, values, label):
        """Get stats for values within the test window."""
        if len(times) == 0:
            return None
        mask = (times >= test_start) & (times <= test_end)
        windowed = values[mask]
        if len(windowed) == 0:
            return None
        stats = {
            'min': np.nanmin(windowed),
            'max': np.nanmax(windowed),
            'mean': np.nanmean(windowed),
            'start': windowed[0],
            'end': windowed[-1],
        }
        print(f"  {label}:")
        print(f"    Start: {stats['start']:.2f}  End: {stats['end']:.2f}")
        print(f"    Min: {stats['min']:.2f}  Max: {stats['max']:.2f}  Mean: {stats['mean']:.2f}")
        return stats

    temp_stats = window_stats(*data['local_temperature'], 'Terrarium Temperature (°C)')
    room_stats = window_stats(*data['room_temperature'], 'Room Temperature (°C)')
    humi_stats = window_stats(*data['local_humidity'], 'Terrarium Humidity (%)')
    vpd_stats = window_stats(*data['vpd'], 'VPD (kPa)')

    if temp_stats and room_stats:
        print(f"\n  Temperature Differential:")
        print(f"    Start: {temp_stats['start'] - room_stats['mean']:.2f}°C below room")
        print(f"    Min terrarium: {temp_stats['min']:.2f}°C (Δ = {temp_stats['min'] - room_stats['mean']:.2f}°C below room mean)")
        print(f"    Max cooling achieved: {room_stats['mean'] - temp_stats['min']:.2f}°C below room average")

        # Cooling rate
        duration_h = (test_end - test_start).total_seconds() / 3600
        total_drop = temp_stats['start'] - temp_stats['min']
        print(f"    Total temperature drop: {total_drop:.2f}°C over {duration_h:.1f}h")
        print(f"    Average cooling rate: {total_drop/duration_h:.2f}°C/hr")

        # Time to reach minimum
        t_temps, v_temps = data['local_temperature']
        mask = (t_temps >= test_start) & (t_temps <= test_end)
        windowed_t = t_temps[mask]
        windowed_v = v_temps[mask]
        if len(windowed_v) > 0:
            min_idx = np.nanargmin(windowed_v)
            min_time = windowed_t[min_idx]
            time_to_min = (min_time - test_start).total_seconds() / 3600
            print(f"    Time to minimum: {time_to_min:.1f}h ({min_time.strftime('%H:%M')})")

    # === CHARTS ===
    print(f"\nGenerating charts...")

    fig, axes = plt.subplots(5, 1, figsize=(14, 18), sharex=True)
    test_date_str = test_start.strftime('%Y-%m-%d')
    fig.suptitle(f'Maximum Cooling Capacity Test — {test_date_str}', fontsize=14, fontweight='bold')

    # Common: shade test window
    for ax in axes:
        ax.axvspan(test_start, test_end, alpha=0.1, color='blue', label='_test window')
        ax.axvline(test_start, color='blue', linestyle='--', alpha=0.5, linewidth=0.8)
        ax.axvline(test_end, color='blue', linestyle='--', alpha=0.5, linewidth=0.8)

    # Panel 1: Temperature
    ax = axes[0]
    t, v = data['local_temperature']
    if len(t): ax.plot(t, v, 'b-', linewidth=1.2, label='Terrarium')
    t, v = data['room_temperature']
    if len(t): ax.plot(t, v, 'g-', linewidth=1, alpha=0.7, label='Room')
    # Wet-bulb if available
    # Calculate from room data
    rt, rv = data['room_temperature']
    rht, rhv = data['room_humidity']
    if len(rt) > 0 and len(rht) > 0:
        # Interpolate humidity to temperature timestamps
        from numpy import interp
        rh_interp = interp(
            [t.timestamp() for t in rt],
            [t.timestamp() for t in rht],
            rhv
        )
        # Stull 2011 wet-bulb approximation
        wbt = rv * np.arctan(0.151977 * np.sqrt(rh_interp + 8.313659)) + \
              np.arctan(rv + rh_interp) - np.arctan(rh_interp - 1.676331) + \
              0.00391838 * rh_interp**1.5 * np.arctan(0.023101 * rh_interp) - 4.686035
        ax.plot(rt, wbt, color='orange', linewidth=0.8, alpha=0.7, linestyle='--', label='Room WBT')
    ax.set_ylabel('Temperature (°C)')
    ax.legend(loc='upper right', fontsize=8)
    ax.set_title('Temperature')
    ax.grid(True, alpha=0.3)
    if temp_stats:
        ax.axhline(temp_stats['min'], color='blue', linestyle=':', alpha=0.4)
        ax.annotate(f"Min: {temp_stats['min']:.1f}°C",
                   xy=(test_end, temp_stats['min']), fontsize=8, color='blue')

    # Panel 2: Humidity
    ax = axes[1]
    t, v = data['local_humidity']
    if len(t): ax.plot(t, v, 'b-', linewidth=1.2, label='Terrarium')
    t, v = data['target_humidity']
    if len(t): ax.plot(t, v, 'r--', linewidth=0.8, alpha=0.7, label='Target')
    t, v = data['room_humidity']
    if len(t): ax.plot(t, v, 'g-', linewidth=0.8, alpha=0.7, label='Room')
    ax.set_ylabel('Humidity (%)')
    ax.legend(loc='upper right', fontsize=8)
    ax.set_title('Humidity')
    ax.grid(True, alpha=0.3)

    # Panel 3: Fan PWM
    ax = axes[2]
    t, v = data['fan_speed']
    if len(t): ax.plot(t, v, 'b-', linewidth=1.2, label='PID Output (outlet/impeller)')
    t, v = data['fan_pwm_freezer']
    if len(t): ax.plot(t, v, 'r-', linewidth=0.8, alpha=0.7, label='Freezer fans (P44)')
    t, v = data['fan_pwm_circulation']
    if len(t): ax.plot(t, v, 'g-', linewidth=0.8, alpha=0.7, label='Circulation (P12)')
    ax.set_ylabel('PWM (0-255)')
    ax.set_ylim(-5, 265)
    ax.legend(loc='upper right', fontsize=8)
    ax.set_title('Fan PWM')
    ax.grid(True, alpha=0.3)

    # Panel 4: Freezer + Mister + Light status
    ax = axes[3]
    t, v = data['freezer_status']
    if len(t): ax.fill_between(t, v, alpha=0.4, color='cyan', step='post', label='Freezer ON')
    t, v = data['light_status']
    if len(t): ax.fill_between(t, v * 0.9, alpha=0.2, color='yellow', step='post', label='Light ON')
    t, v = data['mister_status']
    if len(t): ax.fill_between(t, v * 0.8, alpha=0.3, color='blue', step='post', label='Mister ON')
    ax.set_ylabel('Status')
    ax.set_ylim(-0.1, 1.2)
    ax.legend(loc='upper right', fontsize=8)
    ax.set_title('Device Status')
    ax.grid(True, alpha=0.3)

    # Panel 5: VPD + Power
    ax = axes[4]
    t, v = data['vpd']
    if len(t): ax.plot(t, v, 'purple', linewidth=1.2, label='VPD (kPa)')
    ax.set_ylabel('VPD (kPa)', color='purple')
    ax.tick_params(axis='y', labelcolor='purple')
    ax.legend(loc='upper left', fontsize=8)
    ax.grid(True, alpha=0.3)

    ax2 = ax.twinx()
    t, v = data['power_consumption']
    if len(t): ax2.plot(t, v, 'orange', linewidth=0.8, alpha=0.7, label='Power (W)')
    ax2.set_ylabel('Power (W)', color='orange')
    ax2.tick_params(axis='y', labelcolor='orange')
    ax2.legend(loc='upper right', fontsize=8)
    ax.set_title('VPD & Power Consumption')

    # Format x-axis
    axes[-1].xaxis.set_major_formatter(mdates.DateFormatter('%H:%M'))
    axes[-1].xaxis.set_major_locator(mdates.HourLocator(interval=1))
    axes[-1].set_xlabel('Time')
    plt.xticks(rotation=45)

    plt.tight_layout()

    outdir = os.path.dirname(os.path.abspath(__file__))
    outpath = os.path.join(outdir, f'cooling_test_{test_date_str}_report.png')
    plt.savefig(outpath, dpi=150, bbox_inches='tight')
    print(f"\nChart saved: {outpath}")

    # Also save a text report
    report_path = os.path.join(outdir, f'cooling_test_{test_date_str}_report.txt')
    with open(report_path, 'w') as f:
        f.write("MAXIMUM COOLING CAPACITY TEST — REPORT\n")
        f.write(f"Generated: {datetime.now().strftime('%Y-%m-%d %H:%M')}\n")
        f.write(f"Test window: {test_start.strftime('%Y-%m-%d %H:%M')} → {test_end.strftime('%Y-%m-%d %H:%M')}\n")
        f.write(f"Duration: {(test_end - test_start).total_seconds()/3600:.1f} hours\n\n")
        if temp_stats:
            f.write(f"Terrarium temp: {temp_stats['start']:.1f} → {temp_stats['min']:.1f}°C (min) → {temp_stats['end']:.1f}°C (end)\n")
        if room_stats:
            f.write(f"Room temp mean: {room_stats['mean']:.1f}°C\n")
        if temp_stats and room_stats:
            f.write(f"Max differential: {room_stats['mean'] - temp_stats['min']:.1f}°C below room\n")
            f.write(f"Cooling rate: {(temp_stats['start'] - temp_stats['min'])/((test_end - test_start).total_seconds()/3600):.2f}°C/hr\n")
        if humi_stats:
            f.write(f"Humidity: {humi_stats['min']:.0f}–{humi_stats['max']:.0f}% (mean {humi_stats['mean']:.0f}%)\n")
        if vpd_stats:
            f.write(f"VPD: {vpd_stats['min']:.3f}–{vpd_stats['max']:.3f} kPa\n")
    print(f"Report saved: {report_path}")

    # === COMMON COMPUTATIONS FOR ALL PAPER NOTES ===
    duration_h = (test_end - test_start).total_seconds() / 3600
    max_diff = early_rate = cooling_rate = time_to_min_h = mean_wbt = None

    if temp_stats and room_stats:
        max_diff = room_stats['mean'] - temp_stats['min']
        cooling_rate = (temp_stats['start'] - temp_stats['min']) / duration_h

        # Find time to minimum
        t_temps, v_temps = data['local_temperature']
        mask = (t_temps >= test_start) & (t_temps <= test_end)
        w_t, w_v = t_temps[mask], v_temps[mask]
        min_idx = np.nanargmin(w_v) if len(w_v) > 0 else 0
        min_time = w_t[min_idx] if len(w_t) > 0 else test_end
        time_to_min_h = (min_time - test_start).total_seconds() / 3600

        # Initial rapid cooling rate (first 2 hours)
        mask_early = (t_temps >= test_start) & (t_temps <= test_start + timedelta(hours=2))
        w_t_e, w_v_e = t_temps[mask_early], v_temps[mask_early]
        early_rate = (w_v_e[-1] - w_v_e[0]) / 2.0 if len(w_v_e) > 1 else cooling_rate

        # Room WBT mean during test
        rht_arr, rhv_arr = data['room_humidity']
        rt_arr, rv_arr = data['room_temperature']
        if len(rt_arr) > 0 and len(rht_arr) > 0:
            mask_r = (rt_arr >= test_start) & (rt_arr <= test_end)
            rv_w = rv_arr[mask_r]
            rh_interp_w = np.interp(
                [t.timestamp() for t in rt_arr[mask_r]],
                [t.timestamp() for t in rht_arr],
                rhv_arr
            )
            wbt_w = rv_w * np.arctan(0.151977 * np.sqrt(rh_interp_w + 8.313659)) + \
                    np.arctan(rv_w + rh_interp_w) - np.arctan(rh_interp_w - 1.676331) + \
                    0.00391838 * rh_interp_w**1.5 * np.arctan(0.023101 * rh_interp_w) - 4.686035
            mean_wbt = float(np.nanmean(wbt_w))

    # === HARDWAREX PAPER NOTE (Section 3.1.1) ===
    paper_note_path = os.path.join(outdir, f'cooling_test_{test_date_str}_paper_note.md')

    with open(paper_note_path, 'w') as f:
        f.write(f"<!-- Cooling capacity test results — draft for paper Section 3.1 -->\n")
        f.write(f"<!-- Date: {test_date_str}. Edit as needed before inserting. -->\n\n")

        f.write("#### 3.1.1 Maximum Cooling Capacity\n\n")

        if temp_stats and room_stats:

            # Convert test start UTC to CET (+1h) for display
            test_start_cet = test_start + timedelta(hours=1)
            f.write(
                f"To characterize the system's maximum cooling capacity, a forced-cooling test "
                f"was conducted on the evening of {test_start_cet.strftime('%d %B %Y')}. "
                f"Beginning at {test_start_cet.strftime('%H:%M')} CET (lights off), the compressor was "
                f"locked on continuously with evaporator and circulation fans at maximum PWM (255) "
                f"and outlet and impeller fans disabled (PWM 0) to isolate compressor performance "
                f"from air-exchange effects. "
                f"The test ran for {duration_h:.1f} hours until thermal equilibrium was detected "
                f"by an automated monitor (temperature range < 0.3 deg C over a rolling three-hour "
                f"window, with a minimum eight-hour runtime to avoid false detection from the "
                f"thermal mass plateau described below).\n\n"
            )

            f.write(
                f"Starting from {temp_stats['start']:.1f} deg C (room temperature "
                f"{room_stats['mean']:.1f} deg C), the terrarium reached a minimum of "
                f"{temp_stats['min']:.1f} deg C after {time_to_min_h:.1f} hours, "
                f"establishing a maximum differential of {max_diff:.1f} deg C below room ambient. "
            )

            if mean_wbt is not None:
                wbt_diff = temp_stats['min'] - mean_wbt
                f.write(
                    f"The minimum temperature was {abs(wbt_diff):.1f} deg C "
                    f"{'below' if wbt_diff < 0 else 'above'} the mean room wet-bulb temperature "
                    f"({mean_wbt:.1f} deg C), confirming that compressor-based refrigeration "
                    f"can drive the terrarium well below the thermodynamic limit of evaporative "
                    f"cooling. "
                )

            f.write(
                f"The initial cooling rate was {abs(early_rate):.1f} deg C/hr during the first "
                f"two hours, declining exponentially as the temperature differential with the room "
                f"increased, consistent with Newton's law of cooling applied to the enclosure's "
                f"thermal resistance. "
                f"The average cooling rate over the full test was "
                f"{abs(cooling_rate):.2f} deg C/hr.\n\n"
            )

            if humi_stats:
                f.write(
                    f"Humidity during the test ranged from {humi_stats['min']:.0f}% to "
                    f"{humi_stats['max']:.0f}% (mean {humi_stats['mean']:.0f}%), "
                    f"as the evaporator's dehumidifying action was partially offset by the mister "
                    f"responding to humidity setpoints. "
                )
            if vpd_stats:
                f.write(
                    f"VPD remained between {vpd_stats['min']:.2f} and {vpd_stats['max']:.2f} kPa "
                    f"throughout the test.\n\n"
                )

            f.write(
                f"These results establish the Vitrifrigo ND50 marine compressor's practical "
                f"cooling envelope for a {1.5*0.6*1.1:.0f}-liter acrylic enclosure in a "
                f"{room_stats['mean']:.0f} deg C room: a maximum sustained differential of "
                f"approximately {max_diff:.0f} deg C, with equilibrium reached in approximately "
                f"{time_to_min_h:.0f} hours of continuous operation. "
                f"During normal weather-mimicking operation, where the compressor cycles on and off "
                f"under hysteresis control, overnight lows of 13.5-16 deg C are routinely achieved "
                f"— well within the compressor's demonstrated capacity and sufficient for the "
                f"target species' requirements.\n"
            )
        else:
            f.write("*[Insufficient data to generate paper note — check InfluxDB queries]*\n")

    print(f"Paper note saved: {paper_note_path}")

    # === AOS PAPER NOTE (Orchids, informal/grower audience) ===
    aos_note_path = os.path.join(outdir, f'cooling_test_{test_date_str}_aos_note.md')
    with open(aos_note_path, 'w') as f:
        f.write("<!-- Cooling capacity test — draft insert for AOS paper, 'Lessons Learned' section -->\n")
        f.write("<!-- Tone: conversational, grower-oriented. Edit before inserting. -->\n\n")
        if temp_stats and room_stats:
            max_diff = room_stats['mean'] - temp_stats['min']
            test_start_cet = test_start + timedelta(hours=1)
            f.write(
                f"**Know your compressor's limits.** I ran a forced-cooling test to find out "
                f"how cold the marine compressor could actually push the terrarium. Starting at "
                f"{test_start_cet.strftime('%H:%M')} CET with the lights off, I locked the compressor on "
                f"continuously with the internal fans at full speed, outlet and impeller fans off, "
                f"and let it run until the temperature stopped dropping. "
                f"Starting from {temp_stats['start']:.1f} deg C (room at {room_stats['mean']:.1f} deg C), "
                f"the terrarium bottomed out at {temp_stats['min']:.1f} deg C — "
                f"a {max_diff:.0f} deg C differential with the room. "
            )
            if mean_wbt is not None:
                f.write(
                    f"That minimum is about {abs(temp_stats['min'] - mean_wbt):.0f} deg C below "
                    f"the room's wet-bulb temperature ({mean_wbt:.0f} deg C) — territory that "
                    f"no amount of evaporative cooling with fans could reach. "
                )
            f.write(
                f"During normal operation the compressor cycles on and off and nighttime lows "
                f"are typically 14–16 deg C, so there is plenty of headroom. "
                f"For growers considering marine compressors: in a room at {room_stats['mean']:.0f} deg C, "
                f"a Vitrifrigo ND50 can sustain about {max_diff:.0f} deg C of cooling in a "
                f"990-liter acrylic enclosure — enough for mid-elevation cloud forest species, "
                f"though not for the ultra-highland taxa that need sub-10 deg C nights.\n"
            )
    print(f"AOS note saved: {aos_note_path}")

    # === CPN/ICPS PAPER NOTE (Carnivorous plants, semi-technical) ===
    cpn_note_path = os.path.join(outdir, f'cooling_test_{test_date_str}_cpn_note.md')
    with open(cpn_note_path, 'w') as f:
        f.write("<!-- Cooling capacity test — draft for CPN paper -->\n")
        f.write("<!-- Insert in Section 4.1 (after existing temp table) or as new 4.1.1 -->\n")
        f.write("<!-- Also update the '13.5 deg C' minimum in table row 1 and Section 5.5/6 if needed -->\n\n")
        if temp_stats and room_stats:
            max_diff = room_stats['mean'] - temp_stats['min']
            f.write(
                f"A forced-cooling test was conducted to determine the system's maximum cooling "
                f"capacity. With the compressor locked on continuously, evaporator and circulation "
                f"fans at maximum speed, and outlet/impeller fans disabled to isolate compressor "
                f"performance, the terrarium cooled from {temp_stats['start']:.1f} deg C to a "
                f"minimum of {temp_stats['min']:.1f} deg C over {duration_h:.1f} hours (room "
                f"temperature {room_stats['mean']:.1f} deg C), establishing a maximum sustained "
                f"differential of {max_diff:.1f} deg C. "
            )
            if mean_wbt is not None:
                f.write(
                    f"The minimum temperature was {abs(temp_stats['min'] - mean_wbt):.1f} deg C "
                    f"below the room wet-bulb temperature ({mean_wbt:.1f} deg C), confirming that "
                    f"compressor-based refrigeration extends well beyond the evaporative cooling "
                    f"limit. "
                )
            f.write(
                f"Temperature decline followed an approximately exponential trajectory consistent "
                f"with Newton's law of cooling, with the rate decreasing from "
                f"{abs(early_rate):.1f} deg C/hr initially to near zero at equilibrium.\n\n"
            )
            f.write(
                f"This result refines the '13.5 deg C' minimum reported in Section 4.1, which "
                f"reflects routine overnight lows under normal cycling operation. The forced test "
                f"demonstrates that the Vitrifrigo ND50 has additional cooling capacity beyond "
                f"what normal hysteresis-controlled operation typically uses. "
                f"The {max_diff:.0f} deg C maximum differential remains insufficient for "
                f"ultra-highland species requiring sub-10 deg C nights (Section 5.5), but "
                f"provides comfortable margin for the mid-elevation taxa cultivated here.\n"
            )
    print(f"CPN note saved: {cpn_note_path}")

    print("\n=== OUTPUT FILES ===")
    print(f"  Chart:      {outpath}")
    print(f"  Stats:      {report_path}")
    print(f"  HardwareX:  {paper_note_path}")
    print(f"  AOS:        {aos_note_path}")
    print(f"  CPN/ICPS:   {cpn_note_path}")

    # === MULTI-TEST COMPARISON & FINAL MANUSCRIPTS ===
    generate_combined_report(outdir, test_start, test_end, data, temp_stats, room_stats,
                             humi_stats, vpd_stats, mean_wbt)


def detect_plateau(times, values, test_start, window_min=10):
    """Detect the thermal mass plateau in a cooling curve.

    Uses 5-minute resampled data to reduce misting-spike noise.
    Computes rolling cooling rate (°C/hr) over 30-minute windows.
    A plateau is where the rate slows below 0.55°C/hr (the "slow zone")
    flanked by faster cooling (> 0.7°C/hr) on at least one side.

    Returns dict with plateau_start, plateau_end, plateau_temp, plateau_duration_min,
    rate_before, rate_after — or None if no plateau found.
    """
    if len(times) < 30:
        return None

    # Resample to 5-minute bins to smooth misting spikes
    elapsed_h = np.array([(t - test_start).total_seconds() / 3600 for t in times])
    vals = np.array(values, dtype=float)
    bin_edges = np.arange(0, elapsed_h[-1] + 0.084, 5/60)  # 5min bins
    binned_vals = []
    binned_times = []
    for i in range(len(bin_edges) - 1):
        mask = (elapsed_h >= bin_edges[i]) & (elapsed_h < bin_edges[i+1])
        if np.any(mask):
            binned_vals.append(float(np.nanmean(vals[mask])))
            binned_times.append((bin_edges[i] + bin_edges[i+1]) / 2)
    if len(binned_vals) < 12:
        return None
    bv = np.array(binned_vals)
    bt = np.array(binned_times)

    # Compute rolling rate over 30-min windows (6 bins of 5 min)
    span = 6
    if len(bv) < span * 3:
        return None
    rates = np.array([(bv[i+span] - bv[i]) / (bt[i+span] - bt[i])
                       for i in range(len(bv) - span)])
    rt = bt[:len(rates)]
    rv = bv[:len(rates)]

    # Plateau = slow zone: |rate| < 0.55°C/hr, after first 1.5h
    slow = np.abs(rates) < 0.55
    after_start = rt >= 1.5
    candidates = slow & after_start

    if not np.any(candidates):
        return None

    # Find contiguous slow regions
    diffs = np.diff(candidates.astype(int))
    starts = np.where(diffs == 1)[0] + 1
    ends = np.where(diffs == -1)[0] + 1
    if candidates[0] and after_start[0]:
        starts = np.concatenate(([0], starts))
    if candidates[-1]:
        ends = np.concatenate((ends, [len(candidates)]))
    if len(starts) == 0 or len(ends) == 0:
        return None

    # Find longest slow region
    best_len = 0
    best_start = best_end = 0
    for s, e in zip(starts, ends):
        if e - s > best_len:
            best_len = e - s
            best_start = s
            best_end = e

    if best_len < 4:  # less than ~20 minutes at 5-min resolution
        return None

    # Verify that cooling is faster on at least one side
    pre_start = max(0, best_start - 6)
    post_end_idx = min(best_end + 6, len(rates))
    rate_before = float(np.mean(rates[pre_start:best_start])) if best_start > pre_start else None
    rate_after = float(np.mean(rates[best_end:post_end_idx])) if post_end_idx > best_end else None

    # At least one side must be cooling faster than the plateau zone
    faster_before = rate_before is not None and rate_before < -0.6
    faster_after = rate_after is not None and rate_after < -0.6
    if not (faster_before or faster_after):
        return None

    plat_start_h = float(rt[best_start])
    plat_end_h = float(rt[min(best_end, len(rt) - 1)])
    plat_temp = float(np.mean(rv[best_start:best_end]))
    plat_dur = (plat_end_h - plat_start_h) * 60

    return {
        'plateau_start_h': plat_start_h,
        'plateau_end_h': plat_end_h,
        'plateau_temp': plat_temp,
        'plateau_duration_min': plat_dur,
        'rate_before': rate_before,
        'rate_after': rate_after,
    }


def get_test_data(start_utc, end_utc):
    """Query temperature and room data for a given test window."""
    qs = (start_utc - timedelta(hours=1)).strftime('%Y-%m-%dT%H:%M:%SZ')
    qe = (end_utc + timedelta(hours=1)).strftime('%Y-%m-%dT%H:%M:%SZ')
    ts = start_utc.strftime('%Y-%m-%dT%H:%M:%SZ')
    te = end_utc.strftime('%Y-%m-%dT%H:%M:%SZ')

    temp_series = query_influx(
        f"SELECT value FROM local_temperature WHERE time >= '{qs}' AND time <= '{qe}'")
    room_series = query_influx(
        f"SELECT value FROM room_temperature WHERE time >= '{qs}' AND time <= '{qe}'")
    t_t, t_v = series_to_arrays(temp_series)
    r_t, r_v = series_to_arrays(room_series)

    # Window to test period
    if len(t_t) > 0:
        mask = (t_t >= start_utc) & (t_t <= end_utc)
        t_t, t_v = t_t[mask], t_v[mask]
    if len(r_t) > 0:
        mask = (r_t >= start_utc) & (r_t <= end_utc)
        r_t, r_v = r_t[mask], r_v[mask]

    return t_t, t_v, r_t, r_v


def generate_combined_report(outdir, test3_start, test3_end, test3_data,
                              temp_stats, room_stats, humi_stats, vpd_stats, mean_wbt):
    """Generate final combined manuscripts using data from all three tests."""
    print("\n" + "=" * 60)
    print("MULTI-TEST COMPARISON & FINAL MANUSCRIPTS")
    print("=" * 60)

    # Define all test windows (UTC)
    tests = {
        'Test 1 (Feb 26)': {
            'start': datetime.strptime('2026-02-26T18:47:00', '%Y-%m-%dT%H:%M:%S'),
            'end': datetime.strptime('2026-02-27T04:19:00', '%Y-%m-%dT%H:%M:%S'),
            'config': 'evap+circ=255, outlet/impeller=PID',
        },
        'Test 2 (Feb 27)': {
            'start': datetime.strptime('2026-02-27T18:47:00', '%Y-%m-%dT%H:%M:%S'),
            'end': datetime.strptime('2026-02-27T23:00:00', '%Y-%m-%dT%H:%M:%S'),  # clean portion only
            'config': 'evap+circ=255, outlet/impeller=0 (compromised after midnight)',
        },
        'Test 3 (Feb 28)': {
            'start': test3_start,
            'end': test3_end,
            'config': 'evap+circ=255, outlet/impeller=0',
        },
    }

    # Collect plateau data for each test
    plateau_results = {}
    test_summaries = {}
    for name, t in tests.items():
        print(f"\n  --- {name} ---")
        t_t, t_v, r_t, r_v = get_test_data(t['start'], t['end'])
        if len(t_v) == 0:
            print(f"    No temperature data")
            continue

        tmin = float(np.nanmin(t_v))
        tmax = float(t_v[0]) if len(t_v) > 0 else np.nan
        rmean = float(np.nanmean(r_v)) if len(r_v) > 0 else np.nan
        dur = (t['end'] - t['start']).total_seconds() / 3600

        test_summaries[name] = {
            'start_temp': tmax, 'min_temp': tmin, 'room_mean': rmean,
            'max_diff': rmean - tmin, 'duration_h': dur,
        }
        print(f"    {tmax:.1f} → {tmin:.1f}°C (room {rmean:.1f}°C, Δ={rmean - tmin:.1f}°C, {dur:.1f}h)")

        plateau = detect_plateau(t_t, t_v, t['start'])
        if plateau:
            plateau_results[name] = plateau
            rb = f"{plateau['rate_before']:.1f}" if plateau['rate_before'] is not None else "n/a"
            ra = f"{plateau['rate_after']:.1f}" if plateau['rate_after'] is not None else "n/a"
            print(f"    PLATEAU: {plateau['plateau_temp']:.1f}°C for {plateau['plateau_duration_min']:.0f}min "
                  f"(h {plateau['plateau_start_h']:.1f}–{plateau['plateau_end_h']:.1f}), "
                  f"rate before={rb}, after={ra} °C/hr")
        else:
            print(f"    No plateau detected")

    # Plateau confirmation
    n_plateaus = len(plateau_results)
    plateau_confirmed = n_plateaus >= 2
    if plateau_confirmed:
        plat_temps = [p['plateau_temp'] for p in plateau_results.values()]
        plat_durs = [p['plateau_duration_min'] for p in plateau_results.values()]
        plat_temp_mean = np.mean(plat_temps)
        plat_temp_std = np.std(plat_temps)
        plat_dur_mean = np.mean(plat_durs)
        print(f"\n  PLATEAU CONFIRMED across {n_plateaus} tests:")
        print(f"    Mean temperature: {plat_temp_mean:.1f} ± {plat_temp_std:.1f}°C")
        print(f"    Mean duration: {plat_dur_mean:.0f} min")
    else:
        print(f"\n  Plateau detected in {n_plateaus} test(s) — insufficient for confirmation")

    # Use test #3 as primary (ran to equilibrium)
    t3 = test_summaries.get('Test 3 (Feb 28)', temp_stats)

    if not temp_stats or not room_stats:
        print("  Insufficient test #3 data for final manuscripts")
        return

    duration_h = (test3_end - test3_start).total_seconds() / 3600
    max_diff = room_stats['mean'] - temp_stats['min']
    cooling_rate = (temp_stats['start'] - temp_stats['min']) / duration_h

    # Early rate
    t_temps, v_temps = test3_data['local_temperature']
    mask_test = (t_temps >= test3_start) & (t_temps <= test3_end)
    w_t, w_v = t_temps[mask_test], v_temps[mask_test]
    min_idx = np.nanargmin(w_v) if len(w_v) > 0 else 0
    min_time = w_t[min_idx] if len(w_t) > 0 else test3_end
    time_to_min_h = (min_time - test3_start).total_seconds() / 3600

    mask_early = (t_temps >= test3_start) & (t_temps <= test3_start + timedelta(hours=2))
    w_v_e = v_temps[mask_early]
    early_rate = (w_v_e[-1] - w_v_e[0]) / 2.0 if len(w_v_e) > 1 else cooling_rate

    test_start_cet = test3_start + timedelta(hours=1)

    # Build plateau paragraph (shared across manuscripts)
    plateau_para_technical = ""
    plateau_para_grower = ""
    if plateau_confirmed:
        p3 = plateau_results.get('Test 3 (Feb 28)')
        plat_temps_all = [p['plateau_temp'] for p in plateau_results.values()]
        plat_durs_all = [p['plateau_duration_min'] for p in plateau_results.values()]
        plateau_para_technical = (
            f"The cooling profile exhibited a characteristic multi-time-constant pattern "
            f"rather than a simple exponential decay. After an initial rapid phase "
            f"({abs(early_rate):.1f} deg C/hr over the first two hours), a prolonged plateau "
            f"appeared near {np.mean(plat_temps_all):.1f} deg C, lasting approximately "
            f"{np.mean(plat_durs_all):.0f} minutes before a second rapid cooling phase resumed. "
            f"This pattern was reproducible across {n_plateaus} independent test nights "
            f"(plateau temperatures: {', '.join(f'{t:.1f}' for t in plat_temps_all)} deg C), "
            f"consistent with a two-body thermal model: the low-mass air volume cools rapidly "
            f"to approximate equilibrium with the enclosure's thermal mass (acrylic walls, "
            f"wet sphagnum substrate, standing water), after which the substrate itself cools "
            f"through, releasing the compressor's full capacity to reduce air temperature further. "
        )
        plateau_para_grower = (
            f"The cooling curve was not the smooth decline I expected. After a fast initial drop, "
            f"the temperature stalled around {np.mean(plat_temps_all):.0f} deg C for about "
            f"{np.mean(plat_durs_all):.0f} minutes before suddenly dropping again. I saw this "
            f"same plateau on all {n_plateaus} test nights, at the same temperature. "
            f"The likely explanation: the wet sphagnum, standing water, and acrylic walls were "
            f"absorbing cold without the air temperature changing much, and once that thermal mass "
            f"caught up, the compressor could cool the air freely again. Worth knowing for anyone "
            f"building a similar system — a terrarium with a lot of wet substrate has significant "
            f"thermal inertia, and the first few hours of compressor runtime go into cooling the "
            f"mass, not just the air. "
        )

    # Also build cross-test comparison text
    t1 = test_summaries.get('Test 1 (Feb 26)')
    cross_test_sentence = ""
    if t1:
        cross_test_sentence = (
            f"A prior test with outlet and impeller fans under normal PID control reached "
            f"{t1['min_temp']:.1f} deg C (room {t1['room_mean']:.1f} deg C, "
            f"Δ = {t1['max_diff']:.1f} deg C) over {t1['duration_h']:.1f} hours but did not "
            f"reach equilibrium, confirming the result is reproducible and the compressor's "
            f"capacity is consistent across nights. "
        )

    # === FINAL HARDWAREX MANUSCRIPT ===
    path = os.path.join(outdir, 'cooling_test_final_paper_note.md')
    with open(path, 'w') as f:
        f.write("<!-- FINAL cooling capacity results — HardwareX Section 3.1.1 -->\n")
        f.write(f"<!-- Based on tests: Feb 26, 27, 28 2026. Generated {datetime.now().strftime('%Y-%m-%d %H:%M')} -->\n\n")
        f.write("#### 3.1.1 Maximum Cooling Capacity\n\n")

        f.write(
            f"To characterize the system's maximum cooling capacity, a series of forced-cooling "
            f"tests was conducted over three consecutive nights (26--28 February 2026). "
            f"In the definitive test, beginning at {test_start_cet.strftime('%H:%M')} CET "
            f"(lights off), the compressor was locked on continuously with evaporator and "
            f"circulation fans at maximum PWM (255) and outlet and impeller fans disabled (PWM 0) "
            f"to isolate compressor performance from air-exchange effects. The test ran for "
            f"{duration_h:.1f} hours until thermal equilibrium was detected by an automated "
            f"monitor (temperature range < 0.3 deg C over a rolling three-hour window, with a "
            f"minimum eight-hour runtime to avoid false detection from the thermal mass plateau "
            f"described below).\n\n"
        )

        f.write(
            f"Starting from {temp_stats['start']:.1f} deg C (room temperature "
            f"{room_stats['mean']:.1f} deg C), the terrarium reached an equilibrium minimum of "
            f"{temp_stats['min']:.1f} deg C after {time_to_min_h:.1f} hours, establishing a "
            f"maximum sustained differential of {max_diff:.1f} deg C below room ambient. "
        )
        if mean_wbt is not None:
            wbt_diff = temp_stats['min'] - mean_wbt
            f.write(
                f"The equilibrium temperature was {abs(wbt_diff):.1f} deg C "
                f"{'below' if wbt_diff < 0 else 'above'} the mean room wet-bulb temperature "
                f"({mean_wbt:.1f} deg C), confirming that compressor-based refrigeration "
                f"can drive the terrarium well below the thermodynamic limit of evaporative "
                f"cooling.\n\n"
            )
        else:
            f.write("\n\n")

        if plateau_para_technical:
            f.write(plateau_para_technical + "\n\n")

        if cross_test_sentence:
            f.write(cross_test_sentence + "\n\n")

        if humi_stats:
            f.write(
                f"Humidity during the test ranged from {humi_stats['min']:.0f}% to "
                f"{humi_stats['max']:.0f}% (mean {humi_stats['mean']:.0f}%), as the "
                f"evaporator's dehumidifying action was partially offset by the mister "
                f"responding to humidity setpoints. "
            )
        if vpd_stats:
            f.write(
                f"VPD remained between {vpd_stats['min']:.2f} and {vpd_stats['max']:.2f} kPa "
                f"throughout the test.\n\n"
            )

        f.write(
            f"These results establish the Vitrifrigo ND50 marine compressor's practical "
            f"cooling envelope for a 990-liter acrylic enclosure in a "
            f"{room_stats['mean']:.0f} deg C room: a maximum sustained differential of "
            f"{max_diff:.1f} deg C at thermal equilibrium. "
            f"During normal weather-mimicking operation, where the compressor cycles on and off "
            f"under hysteresis control, overnight lows of 13.5--16 deg C are routinely achieved "
            f"— well within the compressor's demonstrated capacity and sufficient for the "
            f"target species' requirements.\n"
        )
    print(f"\n  Final HardwareX:  {path}")

    # === FINAL AOS MANUSCRIPT ===
    path = os.path.join(outdir, 'cooling_test_final_aos_note.md')
    with open(path, 'w') as f:
        f.write("<!-- FINAL cooling capacity — AOS 'Lessons Learned' section -->\n")
        f.write(f"<!-- Based on tests: Feb 26, 27, 28 2026. Generated {datetime.now().strftime('%Y-%m-%d %H:%M')} -->\n\n")

        f.write(
            f"**Know your compressor's limits.** I ran forced-cooling tests over three nights "
            f"to find out exactly how cold the marine compressor could push the terrarium. "
            f"With the compressor locked on continuously and internal fans at full speed, "
            f"starting from {temp_stats['start']:.1f} deg C (room at "
            f"{room_stats['mean']:.1f} deg C), the terrarium bottomed out at "
            f"{temp_stats['min']:.1f} deg C after {time_to_min_h:.0f} hours — "
            f"a {max_diff:.0f} deg C differential with the room, confirmed across multiple "
            f"nights. "
        )
        if mean_wbt is not None:
            f.write(
                f"That minimum is about {abs(temp_stats['min'] - mean_wbt):.0f} deg C below "
                f"the room's wet-bulb temperature ({mean_wbt:.0f} deg C) — territory that "
                f"no amount of evaporative cooling with fans alone could reach.\n\n"
            )
        else:
            f.write("\n\n")

        if plateau_para_grower:
            f.write(plateau_para_grower + "\n\n")

        f.write(
            f"During normal operation the compressor cycles on and off and nighttime lows "
            f"are typically 14--16 deg C, so there is plenty of headroom. "
            f"For growers considering marine compressors: in a room at "
            f"{room_stats['mean']:.0f} deg C, a Vitrifrigo ND50 can sustain about "
            f"{max_diff:.0f} deg C of cooling in a 990-liter acrylic enclosure — enough for "
            f"mid-elevation cloud forest species, though not for the ultra-highland taxa "
            f"that need sub-10 deg C nights.\n"
        )
    print(f"  Final AOS:        {path}")

    # === FINAL CPN/ICPS MANUSCRIPT ===
    path = os.path.join(outdir, 'cooling_test_final_cpn_note.md')
    with open(path, 'w') as f:
        f.write("<!-- FINAL cooling capacity — CPN Section 4.1.1 -->\n")
        f.write(f"<!-- Based on tests: Feb 26, 27, 28 2026. Generated {datetime.now().strftime('%Y-%m-%d %H:%M')} -->\n\n")

        f.write(
            f"A series of forced-cooling tests was conducted over three consecutive nights "
            f"to determine the system's maximum cooling capacity. With the compressor locked "
            f"on continuously, evaporator and circulation fans at maximum speed, and "
            f"outlet/impeller fans disabled to isolate compressor performance, the terrarium "
            f"cooled from {temp_stats['start']:.1f} deg C to an equilibrium minimum of "
            f"{temp_stats['min']:.1f} deg C over {duration_h:.1f} hours (room temperature "
            f"{room_stats['mean']:.1f} deg C), establishing a maximum sustained differential "
            f"of {max_diff:.1f} deg C. "
        )
        if mean_wbt is not None:
            f.write(
                f"The equilibrium temperature was {abs(temp_stats['min'] - mean_wbt):.1f} deg C "
                f"below the room wet-bulb temperature ({mean_wbt:.1f} deg C), confirming that "
                f"compressor-based refrigeration extends well beyond the evaporative cooling "
                f"limit.\n\n"
            )
        else:
            f.write("\n\n")

        if plateau_confirmed:
            plat_temps_all = [p['plateau_temp'] for p in plateau_results.values()]
            plat_durs_all = [p['plateau_duration_min'] for p in plateau_results.values()]
            f.write(
                f"The cooling profile was notably non-exponential, exhibiting a reproducible "
                f"two-phase pattern across all test nights: an initial rapid decline "
                f"({abs(early_rate):.1f} deg C/hr) followed by a prolonged plateau near "
                f"{np.mean(plat_temps_all):.1f} deg C lasting approximately "
                f"{np.mean(plat_durs_all):.0f} minutes, then a second rapid cooling phase "
                f"before the final convergence to equilibrium. This is consistent with a "
                f"multi-time-constant thermal system in which the enclosure's thermal mass "
                f"(acrylic walls, wet sphagnum substrate, standing water) must equilibrate "
                f"before the compressor can further reduce air temperature.\n\n"
            )

        if cross_test_sentence:
            f.write(cross_test_sentence + "\n\n")

        f.write(
            f"This result refines the 13.5 deg C minimum reported in Section 4.1, which "
            f"reflects routine overnight lows under normal cycling operation. The forced test "
            f"demonstrates that the Vitrifrigo ND50 has additional cooling capacity beyond "
            f"what normal hysteresis-controlled operation typically uses. "
            f"The {max_diff:.0f} deg C maximum differential remains insufficient for "
            f"ultra-highland species requiring sub-10 deg C nights (Section 5.5), but "
            f"provides comfortable margin for the mid-elevation taxa cultivated here.\n"
        )
    print(f"  Final CPN/ICPS:   {path}")

    print(f"\n  All final manuscripts generated.")


if __name__ == '__main__':
    main()
