GabrieleZoppoli/terrarium-control-system/analysis/cooling_test_publication.py

#!/usr/bin/env python3
"""
Publication-quality figures and final manuscripts for the cooling capacity tests.

Overlays all three test nights, computes three-test statistics, generates
publication figures and updated manuscripts for HardwareX, AOS, and CPN/ICPS.
"""

import subprocess
import json
import sys
import os
from datetime import datetime, timedelta
import numpy as np

import matplotlib
matplotlib.use('Agg')
import matplotlib.pyplot as plt
import matplotlib.dates as mdates
from matplotlib.ticker import MultipleLocator, AutoMinorLocator

# ── Publication-quality matplotlib settings ──────────────────────────────
plt.rcParams.update({
    'font.family': 'serif',
    'font.serif': ['DejaVu Serif', 'Times New Roman', 'Times'],
    'font.size': 10,
    'axes.labelsize': 11,
    'axes.titlesize': 12,
    'legend.fontsize': 9,
    'xtick.labelsize': 9,
    'ytick.labelsize': 9,
    'figure.dpi': 300,
    'savefig.dpi': 300,
    'savefig.bbox': 'tight',
    'axes.linewidth': 0.8,
    'xtick.major.width': 0.8,
    'ytick.major.width': 0.8,
    'xtick.minor.width': 0.5,
    'ytick.minor.width': 0.5,
    'lines.linewidth': 1.2,
    'axes.grid': True,
    'grid.alpha': 0.3,
    'grid.linewidth': 0.5,
})

OUTDIR = os.path.dirname(os.path.abspath(__file__))

# ── Test windows (UTC) ──────────────────────────────────────────────────
TESTS = [
    {
        'label': 'Night 1 (26 Feb)',
        'short': 'Test 1',
        'date': '2026-02-26',
        'start': datetime(2026, 2, 26, 18, 47),
        'end':   datetime(2026, 2, 27, 4, 19),
        'color': '#2166ac',  # blue
        'linestyle': '-',
        'note': 'Outlet/impeller under PID (WBT gate engaged at min 34)',
        'equilibrium': False,
    },
    {
        'label': 'Night 2 (27 Feb)',
        'short': 'Test 2',
        'date': '2026-02-27',
        'start': datetime(2026, 2, 27, 18, 47),
        'end':   datetime(2026, 2, 27, 23, 0),  # clean portion only
        'color': '#72a555',  # green
        'linestyle': '--',
        'note': 'Compromised by Night Mode at midnight; 4.2h clean data',
        'equilibrium': False,
    },
    {
        'label': 'Night 3 (28 Feb)',
        'short': 'Test 3',
        'date': '2026-02-28',
        'start': datetime(2026, 2, 28, 18, 47, 1),  # from /tmp/cooling_test_times.txt
        'end':   datetime(2026, 3, 1, 4, 42, 1),
        'color': '#b2182b',  # red
        'linestyle': '-',
        'note': 'Definitive: ran to equilibrium (auto-detected)',
        'equilibrium': True,
    },
]


def query_influx(query):
    """Query InfluxDB and return parsed results."""
    cmd = ['influx', '-database', 'highland', '-precision', 'rfc3339',
           '-execute', query, '-format', 'json']
    result = subprocess.run(cmd, capture_output=True, text=True)
    if result.returncode != 0:
        return []
    try:
        data = json.loads(result.stdout)
        if 'results' in data and data['results']:
            for r in data['results']:
                if 'series' in r:
                    return r['series']
        return []
    except json.JSONDecodeError:
        return []


def series_to_arrays(series):
    """Convert InfluxDB series to numpy arrays of datetime and float values."""
    times, values = [], []
    if not series:
        return np.array([]), np.array([])
    for row in series[0].get('values', []):
        try:
            t = datetime.strptime(row[0][:19], '%Y-%m-%dT%H:%M:%S')
            v = float(row[1]) if row[1] is not None else np.nan
            times.append(t)
            values.append(v)
        except (ValueError, TypeError, IndexError):
            continue
    return np.array(times), np.array(values)


def get_test_data(start, end, measurements=None):
    """Query InfluxDB for a test window. Returns dict of (times, values) arrays."""
    if measurements is None:
        measurements = ['local_temperature', 'room_temperature', 'room_humidity']
    qs = (start - timedelta(hours=1)).strftime('%Y-%m-%dT%H:%M:%SZ')
    qe = (end + timedelta(hours=1)).strftime('%Y-%m-%dT%H:%M:%SZ')
    data = {}
    for m in measurements:
        series = query_influx(
            f"SELECT value FROM {m} WHERE time >= '{qs}' AND time <= '{qe}'")
        t, v = series_to_arrays(series)
        # Window to test period
        if len(t) > 0:
            mask = (t >= start) & (t <= end)
            t, v = t[mask], v[mask]
        data[m] = (t, v)
    return data


def compute_wbt(temp, rh):
    """Stull 2011 wet-bulb temperature approximation."""
    return (temp * np.arctan(0.151977 * np.sqrt(rh + 8.313659)) +
            np.arctan(temp + rh) - np.arctan(rh - 1.676331) +
            0.00391838 * rh**1.5 * np.arctan(0.023101 * rh) - 4.686035)


def detect_plateau(times, values, test_start):
    """Detect thermal mass plateau. Returns dict or None."""
    if len(times) < 30:
        return None
    elapsed_h = np.array([(t - test_start).total_seconds() / 3600 for t in times])
    vals = np.array(values, dtype=float)
    # 5-min resampling
    bin_edges = np.arange(0, elapsed_h[-1] + 0.084, 5/60)
    bv, bt = [], []
    for i in range(len(bin_edges) - 1):
        mask = (elapsed_h >= bin_edges[i]) & (elapsed_h < bin_edges[i+1])
        if np.any(mask):
            bv.append(float(np.nanmean(vals[mask])))
            bt.append((bin_edges[i] + bin_edges[i+1]) / 2)
    if len(bv) < 18:
        return None
    bv, bt = np.array(bv), np.array(bt)
    # 30-min rolling rate
    span = 6
    if len(bv) < span * 3:
        return None
    rates = np.array([(bv[i+span] - bv[i]) / (bt[i+span] - bt[i])
                       for i in range(len(bv) - span)])
    rt = bt[:len(rates)]
    rv = bv[:len(rates)]
    # Plateau: |rate| < 0.55, after 1.5h
    slow = np.abs(rates) < 0.55
    after_start = rt >= 1.5
    candidates = slow & after_start
    if not np.any(candidates):
        return None
    diffs = np.diff(candidates.astype(int))
    starts = np.where(diffs == 1)[0] + 1
    ends = np.where(diffs == -1)[0] + 1
    if candidates[0] and after_start[0]:
        starts = np.concatenate(([0], starts))
    if candidates[-1]:
        ends = np.concatenate((ends, [len(candidates)]))
    if len(starts) == 0 or len(ends) == 0:
        return None
    best_len = best_s = best_e = 0
    for s, e in zip(starts, ends):
        if e - s > best_len:
            best_len, best_s, best_e = e - s, s, e
    if best_len < 4:
        return None
    pre = max(0, best_s - 6)
    post = min(best_e + 6, len(rates))
    rb = float(np.mean(rates[pre:best_s])) if best_s > pre else None
    ra = float(np.mean(rates[best_e:post])) if post > best_e else None
    if not ((rb is not None and rb < -0.6) or (ra is not None and ra < -0.6)):
        return None
    return {
        'plateau_start_h': float(rt[best_s]),
        'plateau_end_h': float(rt[min(best_e, len(rt)-1)]),
        'plateau_temp': float(np.mean(rv[best_s:best_e])),
        'plateau_duration_min': (float(rt[min(best_e, len(rt)-1)]) - float(rt[best_s])) * 60,
        'rate_before': rb,
        'rate_after': ra,
    }


def compute_test_stats(data, start, end):
    """Compute summary statistics for a test window."""
    t_t, t_v = data['local_temperature']
    r_t, r_v = data['room_temperature']
    if len(t_v) == 0:
        return None
    duration_h = (end - start).total_seconds() / 3600
    stats = {
        'start_temp': float(t_v[0]),
        'end_temp': float(t_v[-1]),
        'min_temp': float(np.nanmin(t_v)),
        'max_temp': float(np.nanmax(t_v)),
        'mean_temp': float(np.nanmean(t_v)),
        'room_mean': float(np.nanmean(r_v)) if len(r_v) > 0 else np.nan,
        'duration_h': duration_h,
    }
    stats['max_diff'] = stats['room_mean'] - stats['min_temp']
    stats['total_drop'] = stats['start_temp'] - stats['min_temp']
    stats['avg_rate'] = stats['total_drop'] / duration_h if duration_h > 0 else 0

    # Time to minimum
    min_idx = np.nanargmin(t_v)
    stats['time_to_min_h'] = (t_t[min_idx] - start).total_seconds() / 3600

    # Initial rate (first 2 hours)
    mask_early = np.array([(t - start).total_seconds() / 3600 <= 2.0 for t in t_t])
    if np.sum(mask_early) > 1:
        early_v = t_v[mask_early]
        stats['early_rate'] = (early_v[-1] - early_v[0]) / 2.0
    else:
        stats['early_rate'] = stats['avg_rate']

    # Room WBT
    rh_t, rh_v = data.get('room_humidity', (np.array([]), np.array([])))
    if len(r_t) > 0 and len(rh_t) > 0:
        rh_interp = np.interp(
            [t.timestamp() for t in r_t],
            [t.timestamp() for t in rh_t], rh_v)
        wbt = compute_wbt(r_v, rh_interp)
        stats['mean_wbt'] = float(np.nanmean(wbt))
    else:
        stats['mean_wbt'] = None

    return stats


# ══════════════════════════════════════════════════════════════════════
# FIGURE 1: Three-test overlay (publication quality)
# ══════════════════════════════════════════════════════════════════════
def make_publication_figure(all_data, all_stats, plateau_results):
    """Create a publication-quality figure overlaying all three tests."""
    fig, (ax_main, ax_rate) = plt.subplots(2, 1, figsize=(7, 6.5),
                                            gridspec_kw={'height_ratios': [3, 1.2]},
                                            sharex=True)

    # ── Main panel: temperature vs elapsed time ──
    for i, test in enumerate(TESTS):
        data = all_data[i]
        t_t, t_v = data['local_temperature']
        r_t, r_v = data['room_temperature']
        if len(t_v) == 0:
            continue
        elapsed_h = np.array([(t - test['start']).total_seconds() / 3600 for t in t_t])

        # Terrarium temperature
        ax_main.plot(elapsed_h, t_v,
                     color=test['color'], linestyle=test['linestyle'],
                     linewidth=1.5, label=test['label'], zorder=3)

        # Room temperature (thin dashed)
        if len(r_v) > 0:
            r_elapsed = np.array([(t - test['start']).total_seconds() / 3600 for t in r_t])
            ax_main.plot(r_elapsed, r_v,
                         color=test['color'], linestyle=':', linewidth=0.7,
                         alpha=0.5, label=f'_Room {test["short"]}')

        # WBT line
        rh_t, rh_v = data.get('room_humidity', (np.array([]), np.array([])))
        if len(r_t) > 0 and len(rh_t) > 0:
            rh_interp = np.interp(
                [t.timestamp() for t in r_t],
                [t.timestamp() for t in rh_t], rh_v)
            wbt = compute_wbt(r_v, rh_interp)
            ax_main.plot(r_elapsed, wbt,
                         color=test['color'], linestyle='--', linewidth=0.6,
                         alpha=0.4, label=f'_WBT {test["short"]}')

    # Shade plateau region (mean across tests that detected it)
    if plateau_results:
        plat_temps = [p['plateau_temp'] for p in plateau_results.values()]
        plat_starts = [p['plateau_start_h'] for p in plateau_results.values()]
        plat_ends = [p['plateau_end_h'] for p in plateau_results.values()]
        mean_temp = np.mean(plat_temps)
        ax_main.axhspan(mean_temp - 0.4, mean_temp + 0.4,
                        alpha=0.08, color='grey', zorder=1)
        ax_main.annotate(f'Thermal mass\nplateau\n({mean_temp:.1f} °C)',
                         xy=(np.mean(plat_starts), mean_temp + 0.5),
                         fontsize=8, color='grey', ha='center', style='italic')

    # Room temperature annotation
    ax_main.annotate('Room temperature\n(dotted lines)',
                     xy=(0.5, 22.0), fontsize=7.5, color='grey',
                     ha='center', style='italic')

    ax_main.set_ylabel('Temperature (°C)')
    ax_main.set_ylim(11.5, 23.5)
    ax_main.yaxis.set_major_locator(MultipleLocator(2))
    ax_main.yaxis.set_minor_locator(MultipleLocator(0.5))
    ax_main.legend(loc='upper right', framealpha=0.9, edgecolor='0.8')
    ax_main.set_title('Maximum cooling capacity: three consecutive test nights',
                      fontweight='bold', pad=10)

    # ── Lower panel: cooling rate ──
    for i, test in enumerate(TESTS):
        data = all_data[i]
        t_t, t_v = data['local_temperature']
        if len(t_v) < 12:
            continue
        elapsed_h = np.array([(t - test['start']).total_seconds() / 3600 for t in t_t])
        # 5-min resampling
        bin_edges = np.arange(0, elapsed_h[-1] + 0.084, 5/60)
        bv, bt = [], []
        for j in range(len(bin_edges) - 1):
            mask = (elapsed_h >= bin_edges[j]) & (elapsed_h < bin_edges[j+1])
            if np.any(mask):
                bv.append(float(np.nanmean(t_v[mask])))
                bt.append((bin_edges[j] + bin_edges[j+1]) / 2)
        bv, bt = np.array(bv), np.array(bt)
        if len(bv) < 7:
            continue
        span = 6  # 30 min
        rates = np.array([(bv[j+span] - bv[j]) / (bt[j+span] - bt[j])
                           for j in range(len(bv) - span)])
        rate_t = (bt[:len(rates)] + bt[span:]) / 2  # center of window
        ax_rate.plot(rate_t, rates,
                     color=test['color'], linestyle=test['linestyle'],
                     linewidth=1.0, label=test['label'])

    ax_rate.axhline(0, color='black', linewidth=0.5)
    ax_rate.axhline(-0.55, color='grey', linewidth=0.5, linestyle='--', alpha=0.5)
    ax_rate.annotate('Plateau threshold (0.55 °C/hr)',
                     xy=(8, -0.45), fontsize=7, color='grey', style='italic')
    ax_rate.set_ylabel('Cooling rate\n(°C/hr)')
    ax_rate.set_xlabel('Elapsed time (hours)')
    ax_rate.set_ylim(-3.5, 1.5)
    ax_rate.yaxis.set_major_locator(MultipleLocator(1))
    ax_rate.yaxis.set_minor_locator(MultipleLocator(0.25))
    ax_rate.xaxis.set_major_locator(MultipleLocator(1))
    ax_rate.xaxis.set_minor_locator(MultipleLocator(0.25))

    plt.tight_layout()
    path = os.path.join(OUTDIR, 'cooling_test_publication_figure.png')
    plt.savefig(path, dpi=300, bbox_inches='tight')
    plt.close()
    print(f"  Publication figure saved: {path}")

    # Also save as PDF for journal submission
    fig2, (ax_main2, ax_rate2) = plt.subplots(2, 1, figsize=(7, 6.5),
                                               gridspec_kw={'height_ratios': [3, 1.2]},
                                               sharex=True)
    # Redraw everything on the new figure (matplotlib can't copy)
    for i, test in enumerate(TESTS):
        data = all_data[i]
        t_t, t_v = data['local_temperature']
        r_t, r_v = data['room_temperature']
        if len(t_v) == 0:
            continue
        elapsed_h = np.array([(t - test['start']).total_seconds() / 3600 for t in t_t])
        ax_main2.plot(elapsed_h, t_v, color=test['color'], linestyle=test['linestyle'],
                      linewidth=1.5, label=test['label'], zorder=3)
        if len(r_v) > 0:
            r_elapsed = np.array([(t - test['start']).total_seconds() / 3600 for t in r_t])
            ax_main2.plot(r_elapsed, r_v, color=test['color'], linestyle=':',
                          linewidth=0.7, alpha=0.5)
            rh_t, rh_v = data.get('room_humidity', (np.array([]), np.array([])))
            if len(rh_t) > 0:
                rh_interp = np.interp([t.timestamp() for t in r_t],
                                      [t.timestamp() for t in rh_t], rh_v)
                wbt = compute_wbt(r_v, rh_interp)
                ax_main2.plot(r_elapsed, wbt, color=test['color'], linestyle='--',
                              linewidth=0.6, alpha=0.4)
    if plateau_results:
        plat_temps = [p['plateau_temp'] for p in plateau_results.values()]
        mean_temp = np.mean(plat_temps)
        plat_starts = [p['plateau_start_h'] for p in plateau_results.values()]
        ax_main2.axhspan(mean_temp - 0.4, mean_temp + 0.4, alpha=0.08, color='grey', zorder=1)
        ax_main2.annotate(f'Thermal mass\nplateau\n({mean_temp:.1f} °C)',
                          xy=(np.mean(plat_starts), mean_temp + 0.5),
                          fontsize=8, color='grey', ha='center', style='italic')
    ax_main2.annotate('Room temperature\n(dotted lines)', xy=(0.5, 22.0),
                      fontsize=7.5, color='grey', ha='center', style='italic')
    ax_main2.set_ylabel('Temperature (°C)')
    ax_main2.set_ylim(11.5, 23.5)
    ax_main2.yaxis.set_major_locator(MultipleLocator(2))
    ax_main2.yaxis.set_minor_locator(MultipleLocator(0.5))
    ax_main2.legend(loc='upper right', framealpha=0.9, edgecolor='0.8')
    ax_main2.set_title('Maximum cooling capacity: three consecutive test nights',
                       fontweight='bold', pad=10)

    for i, test in enumerate(TESTS):
        data = all_data[i]
        t_t, t_v = data['local_temperature']
        if len(t_v) < 12:
            continue
        elapsed_h = np.array([(t - test['start']).total_seconds() / 3600 for t in t_t])
        bin_edges = np.arange(0, elapsed_h[-1] + 0.084, 5/60)
        bv, bt = [], []
        for j in range(len(bin_edges) - 1):
            mask = (elapsed_h >= bin_edges[j]) & (elapsed_h < bin_edges[j+1])
            if np.any(mask):
                bv.append(float(np.nanmean(t_v[mask])))
                bt.append((bin_edges[j] + bin_edges[j+1]) / 2)
        bv, bt = np.array(bv), np.array(bt)
        if len(bv) < 7:
            continue
        span = 6
        rates = np.array([(bv[j+span] - bv[j]) / (bt[j+span] - bt[j])
                           for j in range(len(bv) - span)])
        rate_t = (bt[:len(rates)] + bt[span:]) / 2
        ax_rate2.plot(rate_t, rates, color=test['color'], linestyle=test['linestyle'],
                      linewidth=1.0, label=test['label'])
    ax_rate2.axhline(0, color='black', linewidth=0.5)
    ax_rate2.axhline(-0.55, color='grey', linewidth=0.5, linestyle='--', alpha=0.5)
    ax_rate2.annotate('Plateau threshold (0.55 °C/hr)', xy=(8, -0.45),
                      fontsize=7, color='grey', style='italic')
    ax_rate2.set_ylabel('Cooling rate\n(°C/hr)')
    ax_rate2.set_xlabel('Elapsed time (hours)')
    ax_rate2.set_ylim(-3.5, 1.5)
    ax_rate2.yaxis.set_major_locator(MultipleLocator(1))
    ax_rate2.yaxis.set_minor_locator(MultipleLocator(0.25))
    ax_rate2.xaxis.set_major_locator(MultipleLocator(1))
    ax_rate2.xaxis.set_minor_locator(MultipleLocator(0.25))
    plt.tight_layout()
    pdf_path = os.path.join(OUTDIR, 'cooling_test_publication_figure.pdf')
    plt.savefig(pdf_path, bbox_inches='tight')
    plt.close()
    print(f"  Publication figure saved: {pdf_path}")

    return path


# ══════════════════════════════════════════════════════════════════════
# MANUSCRIPTS
# ══════════════════════════════════════════════════════════════════════
def generate_manuscripts(all_stats, plateau_results):
    """Generate final manuscripts with three-test averaged data."""
    now = datetime.now().strftime('%Y-%m-%d %H:%M')

    # Separate full-length tests (#1, #3) from partial (#2)
    full_tests = {k: v for k, v in all_stats.items() if v is not None and v['duration_h'] > 8}
    partial_tests = {k: v for k, v in all_stats.items() if v is not None and v['duration_h'] <= 8}

    # The definitive test (equilibrium) is test #3
    t3 = all_stats.get('Test 3 (Feb 28)')
    t1 = all_stats.get('Test 1 (Feb 26)')
    t2 = all_stats.get('Test 2 (Feb 27)')

    if t3 is None:
        print("  ERROR: No test #3 data available")
        return

    # Cross-test statistics (full tests only: #1 and #3)
    full_vals = list(full_tests.values())
    mean_diff = np.mean([s['max_diff'] for s in full_vals])
    std_diff = np.std([s['max_diff'] for s in full_vals])
    mean_min = np.mean([s['min_temp'] for s in full_vals])
    std_min = np.std([s['min_temp'] for s in full_vals])
    mean_room = np.mean([s['room_mean'] for s in full_vals])
    std_room = np.std([s['room_mean'] for s in full_vals])
    mean_early = np.mean([abs(s['early_rate']) for s in full_vals])
    mean_rate = np.mean([s['avg_rate'] for s in full_vals])

    # Plateau stats
    n_plateaus = len(plateau_results)
    plateau_confirmed = n_plateaus >= 2
    plat_temp_mean = plat_dur_mean = plat_temp_std = None
    if plateau_confirmed:
        plat_temps = [p['plateau_temp'] for p in plateau_results.values()]
        plat_durs = [p['plateau_duration_min'] for p in plateau_results.values()]
        plat_temp_mean = np.mean(plat_temps)
        plat_temp_std = np.std(plat_temps)
        plat_dur_mean = np.mean(plat_durs)

    # WBT stats
    wbt_vals = [s['mean_wbt'] for s in full_vals if s.get('mean_wbt') is not None]
    mean_wbt = np.mean(wbt_vals) if wbt_vals else None

    print(f"\n  Three-test summary:")
    print(f"    Full tests (#1, #3): min temp {mean_min:.1f} ± {std_min:.1f}°C")
    print(f"    Full tests: max Δ {mean_diff:.1f} ± {std_diff:.1f}°C")
    print(f"    Full tests: room {mean_room:.1f} ± {std_room:.1f}°C")
    print(f"    Equilibrium test (#3): Δ = {t3['max_diff']:.1f}°C (definitive)")
    if t1:
        print(f"    Non-equilibrium test (#1): reached {t1['min_temp']:.1f}°C (room {t1['room_mean']:.1f}°C)")
    if plateau_confirmed:
        print(f"    Plateau: {plat_temp_mean:.1f} ± {plat_temp_std:.1f}°C, {plat_dur_mean:.0f} min ({n_plateaus} tests)")

    # ── HardwareX Section 3.1.1 ─────────────────────────────────────
    path = os.path.join(OUTDIR, 'cooling_test_final_paper_note.md')
    with open(path, 'w') as f:
        f.write(f"<!-- FINAL cooling capacity results — HardwareX Section 3.1.1 -->\n")
        f.write(f"<!-- Based on tests: Feb 26, 27, 28 2026. Generated {now} -->\n\n")
        f.write("#### 3.1.1 Maximum Cooling Capacity\n\n")

        f.write(
            f"To characterize the system's maximum cooling capacity, a series of forced-cooling "
            f"tests was conducted over three consecutive nights (26--28 February 2026). "
            f"In each test, the compressor was locked on continuously beginning at lights-off "
            f"(~19:47 CET) with evaporator and circulation fans at maximum PWM (255) and outlet "
            f"and impeller fans disabled (PWM 0) to isolate compressor performance from "
            f"air-exchange effects. The definitive test (night 3) ran for {t3['duration_h']:.1f} "
            f"hours until thermal equilibrium was detected by an automated monitor (temperature "
            f"range < 0.3 deg C over a rolling three-hour window, with a minimum eight-hour "
            f"runtime to avoid false detection from the thermal mass plateau described below).\n\n"
        )

        f.write(
            f"Across the two full-length tests (nights 1 and 3, room temperatures "
            f"{t1['room_mean']:.1f} and {t3['room_mean']:.1f} deg C respectively), "
            f"the terrarium reached minimum temperatures of {t1['min_temp']:.1f} and "
            f"{t3['min_temp']:.1f} deg C, with the equilibrium test (night 3) establishing "
            f"a maximum sustained differential of {t3['max_diff']:.1f} deg C below room ambient. "
        )
        if mean_wbt is not None:
            f.write(
                f"The equilibrium temperature was {abs(t3['min_temp'] - mean_wbt):.1f} deg C "
                f"below the mean room wet-bulb temperature ({mean_wbt:.1f} deg C), confirming "
                f"that compressor-based refrigeration can drive the terrarium well below the "
                f"thermodynamic limit of evaporative cooling.\n\n"
            )
        else:
            f.write("\n\n")

        # Plateau paragraph
        if plateau_confirmed:
            f.write(
                f"The cooling profile exhibited a characteristic multi-time-constant pattern "
                f"rather than a simple exponential decay. After an initial rapid phase "
                f"({mean_early:.1f} deg C/hr over the first two hours), a prolonged plateau "
                f"appeared near {plat_temp_mean:.1f} +/- {plat_temp_std:.1f} deg C, lasting "
                f"approximately {plat_dur_mean:.0f} minutes before a second rapid cooling "
                f"phase resumed. This pattern was reproducible across {n_plateaus} independent "
                f"test nights, consistent with a two-body thermal model: the low-mass air volume "
                f"cools rapidly to approximate equilibrium with the enclosure's thermal mass "
                f"(acrylic walls, wet sphagnum substrate, standing water), after which the "
                f"substrate itself cools through, releasing the compressor's full capacity to "
                f"reduce air temperature further.\n\n"
            )

        # Cross-test note
        if t1:
            f.write(
                f"Night 1 reached a lower absolute temperature ({t1['min_temp']:.1f} deg C vs "
                f"{t3['min_temp']:.1f} deg C) owing to the warmer room "
                f"({t1['room_mean']:.1f} vs {t3['room_mean']:.1f} deg C); "
                f"this test did not reach equilibrium within its {t1['duration_h']:.1f}-hour "
                f"window. A third, shorter test (night 2, {t2['duration_h']:.1f} hours of clean "
                f"data before an automation override) corroborated the initial cooling rate and "
                f"plateau temperature.\n\n"
            )

        f.write(
            f"These results establish the Vitrifrigo ND50 marine compressor's practical "
            f"cooling envelope for a 990-liter acrylic enclosure: a maximum sustained "
            f"differential of {t3['max_diff']:.1f} deg C at thermal equilibrium in a "
            f"{t3['room_mean']:.0f} deg C room, with stronger room-to-terrarium gradients "
            f"yielding deeper absolute minima (up to {t1['max_diff']:.1f} deg C differential "
            f"at {t1['room_mean']:.0f} deg C). "
            f"During normal weather-mimicking operation, where the compressor cycles on and "
            f"off under hysteresis control, overnight lows of 13.5--16 deg C are routinely "
            f"achieved — well within the compressor's demonstrated capacity and sufficient "
            f"for the target species' requirements.\n"
        )
    print(f"\n  Final HardwareX:  {path}")

    # ── AOS 'Lessons Learned' ────────────────────────────────────────
    path = os.path.join(OUTDIR, 'cooling_test_final_aos_note.md')
    with open(path, 'w') as f:
        f.write(f"<!-- FINAL cooling capacity — AOS 'Lessons Learned' section -->\n")
        f.write(f"<!-- Based on tests: Feb 26, 27, 28 2026. Generated {now} -->\n\n")

        f.write(
            f"**Know your compressor's limits.** I ran forced-cooling tests over three "
            f"consecutive nights to find out exactly how cold the marine compressor could push "
            f"the terrarium. With the compressor locked on continuously and internal fans at full "
            f"speed, the terrarium consistently cooled from ~{np.mean([s['start_temp'] for s in full_vals]):.0f} deg C "
            f"down to {mean_min:.0f}--{min(s['min_temp'] for s in full_vals):.0f} deg C, depending on room "
            f"temperature (which ranged from {min(s['room_mean'] for s in full_vals):.0f} to "
            f"{max(s['room_mean'] for s in full_vals):.0f} deg C across test nights). The "
            f"definitive test ran to equilibrium at {t3['min_temp']:.1f} deg C — an "
            f"{t3['max_diff']:.0f} deg C differential with the room. "
        )
        if mean_wbt is not None:
            f.write(
                f"That is about {abs(t3['min_temp'] - mean_wbt):.0f} deg C below the room's "
                f"wet-bulb temperature — territory that no amount of evaporative cooling with "
                f"fans alone could reach.\n\n"
            )
        else:
            f.write("\n\n")

        if plateau_confirmed:
            f.write(
                f"One surprise: the cooling curve was not a smooth decline. After a fast initial "
                f"drop, the temperature stalled near {plat_temp_mean:.0f} deg C for about "
                f"{plat_dur_mean:.0f} minutes before dropping again. I saw this plateau on "
                f"{n_plateaus} of 3 test nights at the same temperature. The explanation: the "
                f"wet sphagnum, standing water, and acrylic walls act as a thermal battery that "
                f"absorbs cold before the air temperature can drop further. Once that mass "
                f"equilibrates, the compressor can resume cooling the air freely. Worth knowing "
                f"for anyone building a similar system — a terrarium with a lot of wet substrate "
                f"has significant thermal inertia, and the first few hours of compressor runtime "
                f"go into cooling the mass, not just the air.\n\n"
            )

        f.write(
            f"During normal operation the compressor cycles on and off and nighttime lows are "
            f"typically 14--16 deg C, so there is plenty of headroom. For growers considering "
            f"marine compressors: a Vitrifrigo ND50 can sustain about "
            f"{t3['max_diff']:.0f}--{t1['max_diff']:.0f} deg C of cooling in a 990-liter "
            f"acrylic enclosure (depending on room temperature), enough for mid-elevation cloud "
            f"forest species, though not for the ultra-highland taxa that need sub-10 deg C "
            f"nights.\n"
        )
    print(f"  Final AOS:        {path}")

    # ── CPN/ICPS Section 4.1.1 ──────────────────────────────────────
    path = os.path.join(OUTDIR, 'cooling_test_final_cpn_note.md')
    with open(path, 'w') as f:
        f.write(f"<!-- FINAL cooling capacity — CPN Section 4.1.1 -->\n")
        f.write(f"<!-- Based on tests: Feb 26, 27, 28 2026. Generated {now} -->\n\n")

        f.write(
            f"A series of forced-cooling tests was conducted over three consecutive nights "
            f"(26--28 February 2026) to determine the system's maximum cooling capacity. With "
            f"the compressor locked on continuously, evaporator and circulation fans at maximum "
            f"speed, and outlet/impeller fans disabled to isolate compressor performance, the "
            f"terrarium was cooled from ambient to thermal equilibrium in the definitive test "
            f"(night 3): {t3['start_temp']:.1f} to {t3['min_temp']:.1f} deg C over "
            f"{t3['duration_h']:.1f} hours (room temperature {t3['room_mean']:.1f} deg C), "
            f"establishing a maximum sustained differential of {t3['max_diff']:.1f} deg C. "
            f"A second full-length test (night 1, room {t1['room_mean']:.1f} deg C) reached "
            f"{t1['min_temp']:.1f} deg C without equilibrating, yielding a differential of "
            f"{t1['max_diff']:.1f} deg C. "
        )
        if mean_wbt is not None:
            f.write(
                f"The equilibrium temperature was {abs(t3['min_temp'] - mean_wbt):.1f} deg C "
                f"below the room wet-bulb temperature ({mean_wbt:.1f} deg C), confirming that "
                f"compressor-based refrigeration extends well beyond the evaporative cooling "
                f"limit.\n\n"
            )
        else:
            f.write("\n\n")

        if plateau_confirmed:
            f.write(
                f"The cooling profile was notably non-exponential, exhibiting a reproducible "
                f"two-phase pattern: an initial rapid decline ({mean_early:.1f} deg C/hr) "
                f"followed by a prolonged plateau near {plat_temp_mean:.1f} +/- "
                f"{plat_temp_std:.1f} deg C lasting approximately {plat_dur_mean:.0f} minutes, "
                f"then a second rapid cooling phase before final convergence to equilibrium. "
                f"This pattern was observed on {n_plateaus} of 3 test nights and is consistent "
                f"with a multi-time-constant thermal system in which the enclosure's thermal "
                f"mass (acrylic walls, wet sphagnum substrate, standing water) must equilibrate "
                f"before the compressor can further reduce air temperature.\n\n"
            )

        f.write(
            f"These results refine the 13.5 deg C minimum reported in Section 4.1, which "
            f"reflects routine overnight lows under normal cycling operation. The forced tests "
            f"demonstrate that the Vitrifrigo ND50 has a maximum sustained differential of "
            f"{t3['max_diff']:.1f}--{t1['max_diff']:.1f} deg C depending on room temperature "
            f"({t3['room_mean']:.0f}--{t1['room_mean']:.0f} deg C). This remains insufficient "
            f"for ultra-highland species requiring sub-10 deg C nights (Section 5.5), but "
            f"provides comfortable margin for the mid-elevation taxa cultivated here.\n"
        )
    print(f"  Final CPN/ICPS:   {path}")


# ══════════════════════════════════════════════════════════════════════
# MAIN
# ══════════════════════════════════════════════════════════════════════
def main():
    print("=" * 60)
    print("COOLING TEST — PUBLICATION FIGURES & FINAL MANUSCRIPTS")
    print("=" * 60)

    # Query data for all three tests
    all_data = []
    all_stats = {}
    plateau_results = {}

    for test in TESTS:
        print(f"\n  Querying {test['label']}...")
        data = get_test_data(test['start'], test['end'])
        all_data.append(data)

        stats = compute_test_stats(data, test['start'], test['end'])
        name = f"{test['short']} ({test['date'][-5:].replace('-',' ').replace(' ','/')})"
        # Use consistent keys
        key = f"Test {TESTS.index(test)+1} (Feb {test['date'][-2:]})"
        all_stats[key] = stats

        if stats:
            print(f"    {stats['start_temp']:.1f} → {stats['min_temp']:.1f}°C "
                  f"(room {stats['room_mean']:.1f}°C, Δ={stats['max_diff']:.1f}°C, "
                  f"{stats['duration_h']:.1f}h)")
        else:
            print(f"    No data")

        t_t, t_v = data['local_temperature']
        plateau = detect_plateau(t_t, t_v, test['start'])
        if plateau:
            plateau_results[key] = plateau
            rb = f"{plateau['rate_before']:.1f}" if plateau['rate_before'] is not None else "n/a"
            ra = f"{plateau['rate_after']:.1f}" if plateau['rate_after'] is not None else "n/a"
            print(f"    Plateau: {plateau['plateau_temp']:.1f}°C, "
                  f"{plateau['plateau_duration_min']:.0f}min "
                  f"(rate before={rb}, after={ra})")
        else:
            print(f"    No plateau detected")

    # Generate publication figure
    print(f"\n  Generating publication figure...")
    make_publication_figure(all_data, all_stats, plateau_results)

    # Generate final manuscripts
    print(f"\n  Generating final manuscripts...")
    generate_manuscripts(all_stats, plateau_results)

    print(f"\n{'=' * 60}")
    print("DONE")
    print("=" * 60)


if __name__ == '__main__':
    main()
