GabrieleZoppoli/terrarium-control-system/(commit log)

2026-02-08 Add scientific paper and GitHub supplement for terrarium control system
    Paper covers Node-RED/InfluxDB/Grafana architecture, PID humidity controller,
    Colombian weather integration, and terrarium construction. Supplement includes
    sanitized flows, Grafana dashboards, InfluxDB schema, watchdog script, and
    detailed algorithm documentation. Placeholder sections remain for hardware
    specs, species list, and growing results.
2026-02-18 Update paper and supplements: fill placeholders, custom serial, gain-scheduled PID, door safety
    Paper (paper.md):
    - Fill all 8 placeholder sections: drainage, substrate, lighting (ChilLED V3),
    cooling (Vitrifrigo ND50 compressor), humidification (MistKing), sensing
    (SHT35+ESP8266, room sensor), species diversity (~120 spp), reliability
    - Replace all Peltier references with Vitrifrigo ND50 compressor
    - Replace Firmata protocol with custom serial (115200 baud, text-based)
    - Update PID: Kp=50/Ki=0.5/Kd=10 with gain scheduling (g=0.15-1.0)
    - Add door safety mode (Section 2.4.8) and startup recovery (2.4.9)
    - Update control hierarchy to 4 levels (door safety as priority 0)
    - Update A/B experi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
    [01_pid_humidity_model.py, 02_iv_causal_model.py, 03_ab_temperature.py, 04_ab_temperature_adjusted.py, arduino-terrarium.ino, meross_script.py]
2026-04-16 Reorganize repo: supplement/ flattened into top-level folders
    Moves the contents of supplement/ into purpose-named top-level dirs to make
    the repo navigable as a project rather than a monolithic submission package:
    supplement/architecture.md -> docs/architecture.md
    supplement/schema.md -> docs/schema.md
    supplement/pid-controller.md -> docs/pid-controller.md
    supplement/grafana/ -> grafana/
    supplement/flows-* -> nodered/
    supplement/arduino-terrarium.ino -> firmware/arduino-terrarium/
    supplement/statistical-analysis/ -> analysis/
    supplement/meross_script.py -> scripts/
    supplement/arduino-watchdog.sh -> scripts/
    supplement/syst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
2026-04-16 Add analysis scripts, daemons, and ESP water-level firmware
    - analysis/: cooling capacity test scripts (publication + internal),
    wet-bulb deconvolution, wet-bulb regression
    - scripts/: Meross power-monitoring daemon (persistent session, MQTT publisher),
    mister failsafe (Tapo plug auto-off; reads TAPO_EMAIL/PASSWORD from env),
    Grafana snapshot capture script
    - systemd/: meross-daemon.service unit file
    - firmware/esp-water-level/: ESP8266 sketch for HC-SR04P ultrasonic
    water-level sensor on the misting reservoir
    - .github/: CI/issue templates if any
    mister-failsafe.py refactored to read TAPO_EMAIL/TAPO_PASSWORD from the
    environment instead of hardcoding (fixed a credentials-in-source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
    [cooling_test_publication.py, cooling_test_report.py, deconvolution.py, esp-water-level.ino, wetbulb_analysis.py]
2026-04-16 Split paper into journal-specific drafts + physical-layout fixes
    paper-original.md was a monolithic submission. Splitting into four targeted drafts:
    - hardwarex.md — HardwareX: full system, BOM, build instructions, validation
    - cpn-paper.md — Carnivorous Plant Newsletter: CP horticulture, refs HardwareX
    - aos-paper.md — AoS Orchids magazine: popular/narrative, orchids only
    - icps-paper.md — comprehensive synthesis: all species + technical
    - paper_backup_20260225.md — Feb 25 monolithic snapshot
    Physical layout corrections (the previous drafts placed the Vitrifrigo
    compressor on a shelf below and the evaporator vertical on the back wall
    — both wrong):
    - Compress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
2026-04-16 Restructure website to 3 sections + HANDOFF doc for Mac-side coordination
    The site was originally docs+gallery+dashboard+blog. Reorganized to three
    top-level sections matching the actual scope of the project:
    highland/ — the cloud forest terrarium (was: docs/ + dashboard/)
    + new webcam/ and photos/ placeholders
    inventions/ — smaller side projects (NEW)
    - zeer-pot-darlingtonia/ (Mac-Claude has the real material)
    - drosera-regia/
    - easier-environments/
    collection/ — the 356-plant collection (was: gallery/)
    - dendrogram/ (Mac-Claude will populate)
    - genera/ (per-genus d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
2026-04-16 Add collection data, photos, and dendrogram viewer
    Mac-side pipeline:
    - scripts/ — four idempotent Python tools to regenerate the artifacts below
    from the canonical Plant_Inventory.xlsx and dendrogram source.
    - static/data/collection.csv (375 rows) — exported per HANDOFF schema, status
    ✓/†/➜ mapped to alive/lost/given.
    - static/data/dendrogram.json — D3 hierarchy with photo paths rewritten to the
    slugified collection tree.
    - static/dendrogram/index.html — self-contained D3 viewer, palette-aligned;
    photo refs ../img/collection/{genus}/{taxon-slug}.jpg.
    - static/img/collection/ — 225 watermarked JPEGs slugified into genus subdirs.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
    [collection.csv]
2026-04-16 Add wishlists, rewrite zeer-pot page, add highland/live
    Content added:
    - collection/wishlists/ — subsection with three vendor-priced hunt lists
    (tillandsia, pinguicula, phalaenopsis sections Aphyllae & Parishianae).
    - highland/live/ — near-live UI snapshot page with a reachability probe and
    a graceful fallback; real snapshotURL pending Pi-side capture job.
    - static/zeer-pot/index.html — the full darlingtonia-zeer-pot build doc
    retoned to the dendrogram palette (Inter / Crimson Pro / JetBrains Mono,
    near-black + violet).
    Content modified:
    - collection/dendrogram/index.md — replaced the embed marker with the iframe
    pointing at /dendrogram/ and a fullscreen deeplink.
    - invent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
2026-04-16 Fix iframe URLs; wire genus pages to live Plant_Inventory data
    Iframe bug: relURL preserves a leading slash without prepending the
    baseURL path, so the dendrogram and zeer-pot iframes were pointing at
    /dendrogram/ and /zeer-pot/ (404 on the dev server at
    /terrarium-control-system/). Swap to absURL on a non-slash-rooted path
    and site.Home.RelPermalink for breadcrumb Home links.
    Live data in genus pages: Pi-Claude's baked species tables didn't match
    the current Plant_Inventory.xlsx. Add a `collection-species` shortcode
    that reads static/data/collection.csv at build time, filters by genus,
    sorts alive/given/lost, and renders with status pills + counts +
    aggregate spend. Replace baked tables in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
2026-04-16 Embed polish: drop fullscreen buttons, extend fonts, upgrade Darlingtonia
    - Drop the "Open fullscreen" chrome on dendrogram and zeer-pot pages; the
    iframe was already the main view and the button was confusing. Iframes
    now expand to the full visible viewport height (minus nav), and a small
    inline hint links to the standalone view.
    - Extend Google Fonts URL with Crimson Pro 600/700, Inter 700, and JetBrains
    Mono 600. The zeer-pot page used font-weight: 600 on Crimson Pro, which
    was being fake-bolded from 500 and reading off vs the rest of the site.
    - Port script now rewrites the three naive J-curve "pitchers" in the pot
    diagram with a recognizable Darlingtonia silhouette: tubular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
2026-04-17 Inline photo thumbs in species tables; fix baseURL drop on photo links
    Two bugs from user review:
    1. Photo links were dead. Same relURL-leading-slash bug as the iframe fix
    earlier: `printf "/img/..." | relURL` yields `/img/...` without the
    `/terrarium-control-system/` baseURL prefix. Drop the leading slash on
    the printf template; Hugo now emits fully-prefixed photo URLs.
    2. Photos were only reachable via the grid at the bottom of each genus
    page — too far from the species data. The collection-species shortcode
    now joins its rows against data/photo_manifest.json and renders a
    44×44 thumbnail inline in a new first column, with a `+N` badge when a
    taxon has secondary p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
2026-04-17 Refresh dendrogram + collection data from upstream sources
    - dendrogram.json: 375 → 378 leaves (rerun port_dendrogram.py)
    - collection.csv: 375 → 379 rows (rerun export_collection_csv.py;
    fixed hardcoded stale ~/Desktop path)
    - static/dendrogram/index.html regenerated from the updated
    living_collection_dendrogram.html master
    [collection.csv]
2026-04-17 website: wire up live UI snapshot, Grafana dashboard snapshot, conditions JSON
    Publishes three new read-only surfaces through Tailscale Funnel on
    rei1.tail7cc014.ts.net:
    - /highland/ui-latest.png — Node-RED dashboard rendered every 15 min by
    headless Chromium (puppeteer-core + system Chromium on the Pi).
    - /highland/grafana-latest-{desktop,mobile}.png — redesigned Grafana board
    (palette #050607 bg / #b06dd1 accent, amber target, green room) rendered at
    two resolutions for the <picture>-based mobile/desktop split.
    - /api/conditions.json — latest temp / RH / VPD / compressor-on from the
    InfluxDB 'highland' DB, served by a tiny Python http.server with CORS '*'
    and a 60 s cache.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
2026-04-17 website: bilingual EN+IT, press page, home mosaic split, hero photo, Comparettia fix
    Aesthetics / UX:
    - Homepage: Heliamphora macdonaldae next to the h1 on desktop; collapses above
    the text on mobile (grid 1.25fr / 1fr → stacked).
    - Homepage mosaic now in two sections: 10 indoor species under the highland
    canopy + 2 outdoor species (Sarracenia 'Hurricane Creek White', Dionaea
    'Alien') with "Outside the Highland terrarium" kicker.
    - "Alive today" stat added to the home stats strip (was missing; About says
    ~270 of 375 alive — now visible at a glance).
    Bilingual (EN + IT):
    - hugo.toml: [languages.en] + [languages.it] with per-language title,
    description, heroLede, keywords, short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
    [collection.csv]
2026-04-17 website: 16 collection photos, Leah Wilkerson moment, interior timeline, home hero swap
    Plant photos added via /add-plant tagger:
    - 13 existing-plant photos (Nymphaea pygmaea 'Helvola', Nymphaea 'Indiana',
    Aldrovanda vesiculosa, Neofinetia falcata 'Akausagi' ×3, Sophronitis pygmaea
    ×2, Dracula vlad-tepes, Drosophyllum lusitanicum, Dionaea muscipula
    'Dracula', Sarracenia × moorei 'Leah Wilkerson', Seidenfadenia mitrata).
    - 3 new plants: Phalaenopsis lobbii, Leptotes unicolor, Ornitophora radicans —
    all placed under Monocots › Asparagales › Orchidaceae.
    - Dendrogram is now 381 accessions · 89 genera · 25 families (was 378/88/25).
    - photo_manifest.json rebuilt automatically: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
    [collection.csv]
2026-04-17 website: fix subdirectory URL 404s, revert hero, expand Highland + outdoor mosaic
    Bugs fixed:
    - 404s on every inline /img/... src and hardcoded /collection/... href when
    the site is served from /terrarium-control-system/: enabled Hugo
    canonifyURLs so root-relative URLs are rewritten with the baseURL prefix
    at build time. Press page images, About bio + moment figure, Highland
    hero images, and all mosaic tile hrefs now resolve correctly on Pages.
    - 404s on mosaic tile clicks from /it/: the mosaic and home-section
    sub-links used relLangURL, which prepended /it/ to English-only targets
    like /collection/genera/heliamphora/. Switched those to relURL so every
    visitor lands on the corr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
2026-04-17 website: ledger section on home + tighter mosaic captions
    Home page additions:
    - New "Three years of running weather, rounded" ledger block between the
    outdoor mosaic and the three section cards. Six tiles with playful
    equivalents for mist cycles (~60k, ≈60 bathtubs), electricity (~2,500 kWh,
    ≈Milan→Tokyo in a Tesla Model 3), electricity bill (~€750), CO₂ scrubbed
    (~100 kg, ≈Milan↔Rome round-trip), sensor readings (~50M), hours
    near-saturated (~15k, ≈630 days inside cloud). Fully translated IT.
    - Subtle glass-card styling with a green tint consistent with the live
    sensor block; 3×2 grid on desktop, stacks on mobile.
    - Numbers are rough back-of-envelope estimates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
2026-04-18 HANDOFF: spec for Pi /api/ledger.json endpoint
    Homepage ledger currently ships back-of-envelope 3-year totals hard-coded
    in i18n strings. Pi-Claude has all the real data in InfluxDB; this doc
    specifies the endpoint shape, Flux sketches, caching, and the Mac-side
    build-time fetch that will swap rough -> exact once it lands.
2026-04-18 HANDOFF: reply to ledger ask — /api/ledger.json live with retention caveat
    Second route on the existing conditions-server.py, 1 h in-process cache,
    CORS *, shape matches the spec. Returns measured-window totals (the DB only
    has ~72 days of data due to 1-year retention + late-2026 rebuild), with a
    `caveats` block spelling out the retention limit so the Mac-side fetch
    script can decide per card whether to show the measured figure or keep the
    rough lifetime estimate.
    All six categories populate:
    - mist_cycles.count, electricity.kwh, cost_eur.value, co2_scrubbed.kg,
    data_points.count, fog_hours.hours
    - mist_cycles.litres returns null (per-event volume not calibrated)
    - Meross power only cam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
2026-04-18 website: wire live ledger from Pi /api/ledger.json
    Pi-Claude shipped the endpoint at 1db3710. This switches the homepage
    from hard-coded back-of-envelope strings to real cumulative totals read
    from the running InfluxDB.
    - scripts/fetch_ledger.py curls the endpoint into data/ledger.json
    (committed; falls back to last-known on fetch failure)
    - layouts/index.html reads site.Data.ledger with lang.FormatNumber
    (',' vs '.' separators per language; M/milioni suffix for data count)
    - i18n strings rewritten for the real ~72-day window — the InfluxDB
    retention only keeps a year, so numbers are smaller and the lede
    honestly cites the `since` date from the endpoint
    - HANDOFF.md notes the ask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
2026-04-18 website: monthly averages on the home ledger
    Per user: stop implying a fixed 72-day window; show cumulative total
    plus monthly average so seasonal variation shows up naturally as the
    data window grows.
    - fetch_ledger.py computes a `monthly` block from total × 30.44/days
    - layouts/index.html adds a <dd class="rate"> below each total
    - i18n adds "per month" / "al mese"
    - site.css styles the rate line smaller + italic suffix
2026-04-18 website: tighten ledger lede — "Measurements started in February 2026"
    Per user: short and neutral. Drops the retention / "log holds one year"
    explanation; keeps a single line noting the 2022 hardware date so the
    reader doesn't think the terrarium itself is only two months old.
    Date format becomes month + year (no day).
2026-04-18 website: wire GoatCounter analytics (highland.goatcounter.com)
    Privacy-first analytics on every page via head partial. No cookies,
    no PII, GDPR-trivial. Dashboard public at https://highland.goatcounter.com.
2026-04-18 website: add 3 more Akausagi photos (habit + ruby root tip)
    Photos taken 18 Apr 2026 and added via /add-plant. Photo 10 is a
    close-up of a growing root tip with the characteristic deep ruby-red
    (ルビー根 / rubii-ne) colouration recognized in the fūkiran tradition.
    Dendrogram + photo manifest regenerated.
2026-04-18 website: IT translation cleanup — 9 calques fixed
    Fixes identified by an audit pass. All changes are swapping over-literal
    IT prose for more idiomatic phrasing; no semantic shift.
    High priority:
    - homepage: "altri nati per..." -> "altri creati per..." (break "nati/nati" repetition)
    - about: "dallo stupore silenzioso di trovare" -> "dalla gioia di scoprire"
    (was a calque of "quiet thrill of watching")
    - about: "l'impegno a non perdere ciò che si ha avuto la fortuna di ricevere"
    -> "il proposito di preservare ciò che fortunatamente si possiede"
    - highland: "sfasati di 15 ore" -> "con uno scarto di 15 ore"
    Medium:
    - about: "metodi scritti" -> "metodi documentati"
    - press: missing "e"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
2026-04-18 dendrogram: UX fixes from live navigation test
    Three friction points caught on first-impression browser walkthrough.
    1. Clade labels at 12 o'clock collided into an unreadable blob (Algae,
    Bryophytes, Ferns, Gymnosperms, Basal Angiosperms all piled up in
    the same top arc). Hide labels for early-diverging clades with
    <15 leaves — their coloured arc bands still identify them and the
    legend carries the counts.
    2. On /collection/dendrogram/ the iframe didn't receive wheel events
    until clicked, so "scroll to zoom" silently failed and the parent
    page scrolled instead. Claim focus on mouseenter inside the iframe
    so wheel routes to D3 zoom immediately.
    3. The embedded iframe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
2026-04-18 dendrogram: fix residual UX — subtitle backdrop + mobile legend collapse
    Observations from a second human-like pass after the previous three fixes:
    1. "381 accessions · 89 genera · 25 families" subtitle sat over the outer
    species-label ring and looked overwritten. Add a blurred translucent
    pill behind it so the counts stay legible without darkening the tree.
    2. On mobile the legend card (evolutionary groups + status icons) took a
    big bite of the viewport even when the user just wanted to pan the
    tree. Add a small "LEGEND ⌄" toggle in the card header — visible only
    below 720px — and auto-collapse by default on mobile.
    Search box left alone: its blurred backdrop alr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
2026-04-18 dendrogram: reset-view button + hover preview on side-panel species
    Two UX additions from a live user observation:
    1. Reset-view button (⟲) fixed bottom-right. Scroll-down to zoom out
    worked but wasn't always discoverable or reachable on trackpads.
    Click clears any focus AND animates back to the initial fit
    transform. Hover rotates the glyph -90° as a small affordance.
    2. Hovering a species name in the focused-genus side panel now opens
    the same photo preview grid as hovering the tip on the tree. The
    side-panel list has fully readable names, so it's a natural target
    for discovery — especially for species whose tree label is cramped.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
2026-04-18 home mosaics + live page: two UX corrections
    1. Home mosaic grids had auto-fit columns which landed the indoor
    mosaic (10 photos) on 4 columns — leaving an awkward cliffhanger
    last row of 2 tiles. The outdoor mosaic (6 photos) was clamped to
    max-width 680px so it ended up in rows of 2. Switch to explicit
    column counts that divide each photo set cleanly: 5 cols for
    indoor (2 rows) and 3 cols for outdoor (2 rows). Mobile keeps the
    existing 2-column fallback below the 720px breakpoint.
    2. The Live Terrarium page forced the Node-RED snapshot into a 16:10
    landscape frame with object-fit: contain, which letterboxed the
    natively-portrait 900x1400 render with huge black si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
2026-04-18 highland residents grid: no cliffhanger (3 cols for 6 genera)
    Same pattern as the home mosaics — auto-fill minmax(200px) landed on
    5 columns at desktop, leaving 1 orphan tile in the second row. Switch
    to explicit 3 columns for a clean 3×2 grid.
    Per the durable aesthetic rule saved in memory: no cliffhangers anywhere
    on the site.
2026-04-18 live page: bump Node-RED UI frame max-width to 600px
    460px read as 'phone size on desktop' per user. 600px at the native
    1800x2800 portrait aspect renders ~933px tall — feels like a tablet-sized
    control panel, which is what the Node-RED UI is.
2026-04-18 tiles: move captions out of images (no more gradient band over photos)
    Both .mosaic-tile (home mosaics) and .photo-tile (genus gallery) had
    captions absolute-positioned over the image's lower third with a dark
    gradient fade-in. Per user — that visually cut the picture. Move
    captions to flow below the image as a plain text block. Keep the
    4:5 aspect ratio, now applied to the image itself so the caption can
    stack beneath without distorting proportions.
2026-04-18 genus lightbox + 6th hero + address fixes
    1. Collection-photos shortcode now opens an in-page lightbox on tile
    click (no new-tab navigation). Supports left/right arrows for
    multi-photo plants (.extras array), × to close, Esc + arrow keys,
    click-outside to close. One lightbox element per page, wired once.
    2. Press hero gallery: 5 → 6 photographs (added Vanda falcata 'Akausagi'
    in cloisonné pot) and switched .press-hero-list to explicit 3-column
    grid = clean 3×2. Copy updated EN + IT. Also removed the "sun
    pitcher" folk-etymology phrasing in two captions per saved memory.
    3. Contact pages (EN + IT): home address fixed to Corso Monte Grappa
    and university lab address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
2026-04-18 zeer-pot: add missing asset files (WIRING, .ino, .fzz, BOM PDF, platformio.ini)
    All 5 files existed at ~/botanica/darlingtonia-zeer-pot/ but hadn't been
    copied into the website's static folder, so the download links on the
    embedded page 404'd. Copy them over.
    [zeer-pot-v24.fzz]
2026-04-18 blog setup + cinematic home intro
    Blog:
    - content/blog/ with EN + IT landing pages
    - content/blog/welcome/ bundle as the first post (copy the shot used on
    the homepage so the example image actually renders)
    - layouts/blog/list.html — date-sorted post list with cards
    - layouts/blog/single.html — post view with date, reading time, tags,
    prev/next nav, back-to-index link
    - layouts/shortcodes/figure.html — captioned images, resolves paths
    against the page bundle (so posts can just reference filenames)
    - Blog menu entry added at weight 35 in both EN and IT menus
    - RSS auto-generated at /blog/index.xml
    Cinematic intro:
    - layouts/partials/cinematic-intro.html — full-screen overlay wi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
2026-04-18 home: optional spotlight tour after the cinematic intro
    A 20-second guided walkthrough of the main nav tabs — Highland,
    Inventions, Collection, Blog, About — each lit out of a dimmed backdrop
    with a short explanation and Next/Back controls.
    Shown only once per session (sessionStorage flag), offered via a small
    chip near the bottom after the cinematic intro finishes. "Skip"
    dismisses without starting. Skipped entirely when prefers-reduced-motion
    is set.
    Keyboard: Esc ends the tour, ArrowRight/ArrowLeft step through.
2026-04-18 HANDOFF: reply to kWh verification ask — number is real, not double-counted
    Ran all four diagnostic checks Mac-Claude requested. The 151 kWh figure is
    a legitimate trapezoidal integral of the Meross MSS310 stream; kWh/day is
    2.59, not 2.10 (the 72-day window in JSON's `since` is DB-wide but the
    Meross daemon only came up 2026-02-18, so 58.7 d of actual metering).
    - No duplicate-sample issue. Polling cadence varied 2s/30s/120s across the
    window (daemon was manually adjusted); trapezoidal is density-independent.
    - Mean 110W / median 111W / p95 203W / max 493W — tight distribution,
    not compressor-spike pattern. Implies ~25W always-on base + compressor
    running ~65W when on + lights ad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
2026-04-18 kwh caption: specific data instead of vague household-percentage
    Pi-Claude verified the 151 kWh figure (full reply in HANDOFF 9309189):
    the actual meter runs 58.7 days, not 72, so 2.59 kWh/day — higher
    than my BoE (I under-estimated the 4× ChilLED grow lights at 60 %
    hardware ceiling, the compressor duty, and always-on base). Meross
    meters the whole power strip; no devices unmetered; no double-count.
    Re-fetched /api/ledger.json — now carries an electricity.note field
    summarising the distribution. Rewrite the card caption to reflect
    the specific measurement: mean ~110 W continuous, with night /
    midday bands. Clearer and more defensible than "a few percent of
    a household's yearly draw".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
2026-04-18 live page: split the 2x2 Node-RED UI into a landscape layout
    The image ships portrait (1800x2800) because Node-RED stacks four
    panels in a 2x2 grid. At 600 px max-width that read as "phone-sized
    on desktop" no matter how tall it was. Instead, split the image into
    top and bottom halves displayed side-by-side via CSS background-image
    + background-position (0/100%), giving an 18:7 landscape frame that
    fills up to 1200 px. No information lost; on viewports under 900 px
    the two halves stack back into portrait so each panel stays readable.
    Refresh JS now mirrors the probed snapshot URL into both halves'
    backgroundImage, preserving the auto-refresh cadence.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
2026-04-18 mobile sweep: fix cliffhangers + 2-col fallback for all tile grids
    Static audit of site.css revealed:
    - home-ledger__grid was auto-fit minmax(260px), which landed on 4
    columns at typical desktop content widths → 6 cards became a
    cliffhanger 4+2. Switch to explicit repeat(3,1fr) for 3×2.
    - highland-residents, press-hero-list, photo-grid (genus galleries)
    all had explicit desktop column counts but no mobile overrides,
    so tiles shrank below touch-friendly sizes on phones. Add a
    720px breakpoint collapsing them all to 2 columns.
    - home-ledger__grid also gets a 2-col mobile rule now — 3×2 desktop,
    3×2 mobile (3 rows of 2) — still clean.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
2026-04-18 genus pages: drop 'miniature' where it's inaccurate + heliamphora etymology
    User pointed out that 'miniature' was repeating across the list-by-genus
    descriptions and section headings even for plants that aren't miniatures
    (Dendrobium speciosum, larger Phalaenopsis species, etc.). Tone it down:
    - other-orchids description: 'miniature Pleurothallidinae' → 'Pleurothallidinae'
    - 'Neofinetia & Allies' intro: reframed without 'miniature vandaceous'
    - '## Vanda (Miniature)' → '## Vanda'
    - 'Miniature species' note on V. coerulescens → 'Species'
    - '## Miniature Phalaenopsis' → '## Phalaenopsis species'
    - '## Southeast Asian Miniatures' → '## Southeast Asian species'
    - '## Miniature Pleurot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
2026-04-18 fixes: tour persistence + live page breakpoint
    1. Intro + tour used sessionStorage which clears when the browser
    session ends. User saw the tour offer on their third visit because
    each new browser session re-triggered it. Switch both to
    localStorage so the flag persists across sessions — the intro
    plays once ever, the tour offer shows once ever. Wrapped in
    try/catch so private-browsing (where localStorage may throw)
    degrades to 'just show it' rather than crashing.
    2. Live page landscape-split breakpoint was 900px, which meant the
    vertical-stacked fallback kicked in on laptops with windows sized
    much smaller than full-screen. Lowered to 700px — now only
    phone-s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
2026-04-18 dracula: remove price bullet for vlad-tepes in cultivation notes
    Per user — line was a price commentary, not a cultivation observation,
    and didn't belong in that section.
2026-04-18 collection: add 'golden three' section — top-3 most expensive plants
    Adds a short narrative section to the Collection landing (EN + IT)
    celebrating the three acquisitions that sit far above the rest of the
    ledger: Neofinetia 'Akausagi' (€761), Heliamphora minor var. pilosa
    Auyán Clone 3 (€205), and Sarracenia 'Hurricane Creek White' clone F
    (€159). Each gets a paragraph with vendor + date + the story behind
    the price. Linked Akausagi to the press page (those are also the
    only three 'Akausagi' photos on Wikimedia Commons at the moment).
2026-04-18 golden-three: heading, hero photos, CSS, tour mention + contact address redacted
    Collection landing gets a 'The Golden Three' section — the three
    priciest plants (Akausagi €761, Heliamphora minor var. pilosa Auyán
    Clone 3 €205.61, Sarracenia 'Hurricane Creek White' clone F €159)
    each with a hero photo (linked to full-res), vendor + date + a short
    factual description (no rhetoric, no folk etymology). 3-col grid
    desktop, single col mobile.
    Descriptions rewritten to be accurate: dropped 'inspired The Lost
    World' (that was Mount Roraima, not Auyán), dropped romanticising
    language.
    Tour step 'Collection' now mentions the Golden Three so it's
    discoverable for first-time visitors.
    Also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
2026-04-18 HANDOFF: reply on Node-RED UI landscape render — 4-col at 1500×800
    Reports the new /highland/ui-latest.png shape (3000×1600 landscape, all four
    groups as a single strip). Tried the user's desktop 3-col layout first
    (viewport ~1200 px) but Node-RED's breakpoint spilled VPD to a second row
    with 75 % empty gutter — 4-col at 1500 px is visually cleaner on the site
    even though it diverges from the user's own desktop layout.
    Mac-Claude can now drop the .live-frame-split CSS hack; PNG displays at
    natural aspect.
2026-04-18 collection: Golden Three moved below browse cards + contact grid clean
    - New shortcode {{< browse-cards >}} renders the current section's
    child pages as a card grid inline from markdown, so the Collection
    landing can place its three browse options (Dendrogram / By Genus /
    Wishlists) *before* the Golden Three showcase. Previously the
    browse cards auto-appended at the very bottom under the Golden
    Three hero photos, pushing them off the first screenful.
    - Custom layouts/collection/list.html disables the default auto-
    append of children since the shortcode has explicit control now.
    - contact-grid switched from auto-fit(280px) to explicit 3 cols —
    6 cards now land as a clean 2×3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
2026-04-18 HANDOFF: revert Node-RED UI render to portrait — landscape looked sparse
    Tried 1500×800 (4-col strip) and 1200×1200 (3-col + VPD wrap). User rejected
    the 4-col output — Node-RED doesn't reflow widget padding for landscape, so
    each column stretched vertically with huge gaps between gauges/buttons. The
    2×2 portrait at 900×1400 @2× (1800×2800 output) is denser and reads better.
    Keep the .live-frame-split CSS hack. ui-latest.png is back to the original
    shape.
2026-04-18 HANDOFF: UI snapshot now Firefox-desktop 1920×1080 landscape (2628×1332 clip)
    Previous "revert to portrait" reply was wrong turn. User noted that the NR
    UI looks fine when they open it in Firefox on their desktop; right move is
    to simulate that. render-ui.js now uses a desktop-Firefox userAgent + a
    1920×1080@2× viewport, then screenshots tight to the dashboard's bounding
    box (md-card groups) with 12 px padding.
    Result: all four groups as one clean horizontal strip at native widget
    size (no stretched padding, no dead gutter). Aspect ~2:1.
    Also announces the conditions.json enrichment (10 new fields: targets,
    room context, equipment states, fan PWM, power, tank, today's mists) so
    Mac-Cla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
2026-04-18 mastodon: wire @zoppolig@mastodon.social across site
    - hugo.toml: add mastodon to author block + sameAs + links
    - head.html: <link rel=me> for Mastodon verification
    - site-footer.html: visible footer nav link (rel=me external)
    - about/_index.{md,it.md}: 8th .elsewhere entry
    - site.css: .elsewhere grid to explicit 4 cols (clean 4x2, resolves 7-item cliffhanger)
2026-04-18 photos: +3 Neofinetia falcata 'Akausagi'
    11.jpg/12.jpg/13.jpg added to the Akausagi folder (now 13 total).
    13.jpg is a close-up of an actively growing root tip with
    ルビー根 (ruby-root) colouration — typical of vigorous Neofinetia.
2026-04-18 live: drop .live-frame-split — snapshot is now native landscape
    Pi-Claude's c611a0e ships 2628×1332 landscape frames (Firefox 1920×1080
    clip, ~2:1). No more portrait splitting needed — render the <img> at its
    native aspect.
2026-04-18 highland-live: richer strip with 10 new API fields
    Primary (4 cells): temperature, humidity (both with → target subtitle),
    VPD, water tank.
    Chip row (7): compressor · room (T · RH) · fan · lights · mister ·
    power · mists today.
    Compressor/lights/mister use data-on=true/false so CSS tints them
    green (on) or muted (off). Data-label-on/off attributes carry the
    i18n on/off strings so the JS doesn't need templated string literals
    (minifier was double-quoting jsonify output).
    i18n: +9 keys each side (EN/IT).
2026-04-19 highland: one panel, 12 cells, no duplication
    - Live strip: single 12-cell grid (6×2 desktop, 3×4 midrange,
    2×6 phone, 1×12 narrow). All cells uniform visual weight,
    no primary/secondary tier — the old 4+7 split read as 'two
    panels'.
    - Added cells: Room temp, Room RH (from
    room_temperature_c/room_humidity_rh in the API). Dropped the
    combined 'Room' chip.
    - Deleted the .highland-stats operating-envelope dl below the
    strip — it repeated Temperature / Humidity / VPD labels from
    the live strip (real cause of 'measures repeated twice').
    Kept the non-duplicating bits (Operational since 2023, 32
    signals · 60 s, historical range) as a one-line
    .highland-envelope captio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
2026-04-19 two fixes: /collection/genera/ missing + home scroll orientation
    1) /collection/genera/ was rendering only prose — the custom
    collection list layout unconditionally suppressed auto-append
    of children so the {{< browse-cards >}} shortcode could place
    them above the Golden Three. That suppression now opts in via
    `no_auto_children: true` on the /collection/ landing only.
    Every other section under /collection/ (genera, wishlists,
    dendrogram) gets its child cards back.
    2) Home page: scrolling down with no way back up. Added a sticky
    pill sub-nav that appears once the hero scrolls off — with
    ↑ back-to-top + anchor links to Stats, Featured, Outdoor, Log,
    Browse. Sm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
2026-04-19 IT: translate _index for /collection/genera/ and /collection/wishlists/
    These sections had no _index.it.md, so on the Italian site the
    /it/collection/ landing was showing only 1 browse card
    (Dendrogramma) instead of 3. Now shows: Dendrogramma, Wishlist,
    Per genere.
    Individual genus sub-pages (heliamphora, dracula, etc.) are still
    EN-only — full genus translation is a bigger task, queued for a
    later session.
2026-04-19 IT: translate remaining 3 genus pages (outdoor, other-genera, other-orchids)
    With the 8 from the previous commit, all 11 genus pages now
    have Italian translations. /it/collection/genera/ renders the
    full 11-card grid (was 8 after the last push, 0 before yesterday).
    Tables keep Latin binomials and vendor names intact. Prices use
    Italian decimal comma (EUR 27,27). "Fūkiran" kept in Latin
    transliteration with the 赤兎 Kanji + "coniglio rosso" gloss
    for Akausagi.
2026-04-19 multi: contact heights, 404s, low-tech shelves doc, phrasing fixes
    1. Contact grid: grid-auto-rows: 1fr so the second row of cards
    doesn't appear shorter than the first just because its bodies
    are shorter.
    2. 404 audit: zero missing internal links (was 8 — all on the IT
    side). Translated _index.it.md for highland/{photos,live,dashboard,
    docs,webcam} and inventions/{zeer-pot-darlingtonia,drosera-regia,
    easier-environments}. IT docs landing links out to the EN
    sub-pages (architecture/flows/pid-controller/schema) instead of
    non-existent IT ones.
    3. Low-tech fog shelves: rewrote /inventions/easier-environments/
    into an actual page documenting the living-room shelves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
2026-04-19 debug pass: cliffhanger-free grids + forward-compatible count
    1. /collection/genera/ padded to 12 cards. Added extra_card
    frontmatter support on the collection list layout — the 11
    genus children + a final "Full dendrogram" teaser card.
    12 divides cleanly at every breakpoint (4×3, 3×4, 2×6, 1×12).
    2. home-stats from 7 → 6 cells. Dropped "Logging · 60 s" (the
    same fact lives in the ledger and in the highland-envelope
    caption). Switched from auto-fit to explicit 6-col grid with
    a 3-col midrange breakpoint under 1080 px — clean at every
    width.
    3. Forward-compatible "380+ accession" phrasing everywhere. The
    home, about, press one-liner, and hugo.toml author b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
2026-04-19 home mosaic: Cephalotus → Nepenthes glabrata
    Cephalotus follicularis lives on the passive-mist shelves in
    the living room, not in the highland cabinet — it shouldn't
    be among the convergent-evolution cloud-forest tiles on the
    home page. Swapped for N. glabrata (Sulawesi highland), whose
    fluted pitcher reads as an ascidio at thumbnail size.
2026-04-19 perf: responsive srcset (480w/960w) for collection photos
    - New script scripts/generate_image_variants.py generates -480 and
    -960 variants next to every .jpg in static/img/collection and
    static/img/highland using macOS sips. Idempotent.
    - Generated 480 variants for 232 collection photos + 16 highland
    photos. An original 1 MB pitcher tile becomes 85 KB at 480 and
    270 KB at 960 — a genus page with 10 photos now loads ~1 MB at
    thumbnail size on mobile instead of 5–10 MB.
    - collection-photos shortcode emits
    srcset="foo-480.jpg 480w, foo-960.jpg 960w, foo.jpg 1600w"
    sizes="(max-width: 720px) 45vw, 240px"
    The tile src defaults to the 480 variant (so slow networks still
    ge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
2026-04-19 home mosaic: glabrata → jamban
    N. jamban is rarer — the squat "toilet pitcher" endemic to
    Sumatra. Its name alone reads better at thumbnail scale.
2026-04-19 IT: full translation of deep technical docs
    Four doc pages that were previously EN-only are now
    translated (~846 lines total):
    - highland/docs/architecture (system architecture, stack)
    - highland/docs/schema (32 InfluxDB measurements)
    - highland/docs/pid-controller (gain-scheduled humidity PID)
    - highland/docs/flows (tab-by-tab Node-RED guide)
    Latin binomials, pin numbers, IP addresses, variable names,
    code blocks, and npm package names kept in English as
    identifiers. Tables translated for column headers and cell
    prose. Italian conventions: decimal comma (Kp=0,5),
    UR for relative humidity, "ascidio" for pitcher.
    The /it/highland/docs/ landing used to link to the EN
    s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
2026-04-19 home + highland: link balcony species, ledger to UI/Grafana, swap hero drawing for live dashboard
    /highland/: hero now pairs Dracula pholeodytes with the live
    24-hour Grafana snapshot (replaces the static front-panel
    schematic tile). A new `.highland-hero-links` pill row below
    the hero links out to Build timeline, Architecture & schematics,
    Node-RED flows, and Source & firmware — so all the drawings and
    sketches stay one click away without dominating the hero.
    Home (/): the outdoor mosaic now has a foot row linking to
    Sarracenia · Dionaea · all outdoor plants. The ledger section
    gains a foot row linking to the full UI snapshot and the
    24-hour Grafana (same CTAs as the home-live strip).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
2026-04-19 HANDOFF: ask Pi-Claude for a hero-sized Grafana render
    The /highland/ hero is a 4:3 slot; the desktop Grafana render is
    natively wide (~16:9) and gets cropped to fit. Asked Pi-Claude to
    publish a third variant — grafana-latest-hero.png, ~1200×900 or
    1600×1200 — with a 2×2 panel layout (T / RH / VPD sparklines +
    actuator state trail). Non-blocking; current fallback still works.
2026-04-19 HANDOFF: reply on hero render — grafana-latest-hero.png live, 3200×2400
    Third Grafana layout alongside desktop + mobile: 4:3 hero tile for the
    highland landing page. 2×2 over a header strip:
    TL Temperature hero TR Humidity hero
    BL VPD hero BR Lights / Freezer / Mister state trails
    Generated as snapshot-hero dashboard in grafana_snapshot_dashboards.py,
    rendered by render.js hero, auto-refreshed every 15 min with the others.
    Published at the expected URL through the existing Tailscale Funnel.
2026-04-19 highland hero: flip Grafana to the hero-sized render
    Pi-Claude landed grafana-latest-hero.png (3200×2400, 4:3 retina)
    at commit 65d8c5a on the Pi. 2×2 panel layout: TL Temperature,
    TR Humidity (stat + area sparkline each), BL VPD, BR actuator
    state trails (lights/freezer/mister), with a RORAIMA header
    spanning full width. Palette matches the desktop/mobile pair.
    The /highland/ hero tile stops center-cropping a wide render —
    it now shows a chart composition actually designed for a
    square-ish slot. EN + IT.
2026-04-20 location tagging: per-plant "Where" column + accurate counts
    Data: added "Location" column (col 11) to Plant_Inventory.xlsx
    and populated all 382 rows via a genus-based classifier plus
    per-species overrides for the mixed genera (Dendrobium,
    Utricularia, Pinguicula, Drosera, Bulbophyllum, Phalaenopsis,
    Vanda). Values: highland | shelves | outdoor | windowsill.
    Tally by location (all / alive):
    windowsill 126 / 87 (Tillandsia + indoor orchids + dry-tolerant)
    outdoor 125 / 86 (Sarracenia, Dionaea, aquatics, hardy)
    highland 89 / 74 (cloud-forest cabinet)
    shelves 42 / 31 (passive-mist living-room shelves)
    Export: export_collection_csv.py now reads the new column and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
    [collection.csv]
2026-04-20 location: user-correction pass 1
    - Oncidium cheirophorum → highland (mounted, coconut scent,
    cloud-forest candidate)
    - Oncidium eurycline (lost) → outdoor
    - Maxillaria tenuifolia → outdoor
    - Maxillaria sophronitis → highland (tiny cool-grower)
    - Cymbidium Kiwi Midnight 'Geyserland' (given) → outdoor
    New alive tally: highland 74 / shelves 40 / outdoor 85 / windowsill 79.
    Species-count copy on /highland/_index.{md,it.md} softened from
    ~75 to ~70 species (≈85 accessions counting clonal lines), dropped
    "Utricularia sect. Orchidioides" from the representative-genera
    list since all Utricularia now live on the low-tech fog shelves.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
    [collection.csv]
2026-04-20 location: add 'seasonal' for plants that rotate balcony↔shelves
    Neofinetia falcata (all 3 forms — 'Akausagi', 'Benitengu',
    typical) move to the balcony in summer and back to the low-tech
    fog shelves in winter, as is tradition for fūkiran. Single
    location doesn't fit, so added a 5th value 'seasonal' with its
    own EN/IT label ("Seasonal" / "Stagionale") and a cool-blue
    .loc-badge--seasonal.
    [collection.csv]
2026-04-20 +3 Celandroni (order #36854, 2026-04-20) + 2 location fixes
    New accessions (#426-428, all alive):
    - Sophronitis pygmaea (Brazil Import) — €27,27 → highland
    - Phalaenopsis malipoensis — €27,27 → shelves
    - Phalaenopsis honghenensis — €25,45 → shelves
    Dendrogram updated (subtitle now 385 accessions · 89 genera ·
    25 families). Sync regenerated CSV, stats, and photo manifest.
    Location corrections:
    - Genlisea (4 rows) → shelves (kept with the Utricularia in
    the low-tech terraria)
    - Utricularia quelchii → highland (historical; was tepui-
    terrarium before being lost)
    [collection.csv]
2026-04-20 +1 U. quelchii (alive, flowering) + U. alpina dendrogram fix
    - New accession #429: Utricularia quelchii, status=alive, location
    highland. It was missing from the Excel entirely despite being
    in the collection and currently flowering.
    - Flipped the dendrogram's U. alpina leaf from status=dead to
    status=alive — the Excel had it marked alive (#35) but the
    dendrogram source HTML still carried an old dead state. Now
    aligned.
    Dendrogram subtitle: 386 accessions · 89 genera · 25 families.
    [collection.csv]
2026-04-20 U. quelchii: backfill full provenance from Klein Feb 2023 order
    Gmail order thread #7646 (Carnivors & More / Christian Klein):
    - Inquiry 2023-02-21
    - Payment confirmed 2023-02-23
    - Shipped 2023-02-26 via DHL (CH533148365DE)
    - "Utricularia quelchii, Ilu Tepui" × 1 · €38.00
    Row #429 now carries vendor, date, price, order #, and a
    provenance/shipment note. Dendrogram leaf vendor updated.
    [collection.csv]
2026-04-20 ledger: auto-refresh client-side + drop last "120 species" stale
    Ledger auto-refresh: the home ledger now fetches /api/ledger.json
    from the Pi on page load and rewrites every value / rate cell.
    SSR still lands via data/ledger.json so offline/cached loads
    aren't blank; the JS silently keeps SSR values if the Pi is
    unreachable. Locale-aware number formatting (it-IT vs en-US)
    via Intl.NumberFormat; monthly rates computed client-side from
    since / as_of.
    Also: the /highland/ frontmatter descriptions (EN + IT) still
    said "~120 species" — updated to ~70 to match body copy and
    the actual alive count (74 accessions in highland, ~70 unique
    species).
    Also includes ledger.json refresh from Pi (1329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
2026-04-20 typography: em/i inherit surrounding font (no more serif-in-sans jar)
    The global rule em, i, .taxon { font-family: var(--font-display) }
    was forcing every italic — in the middle of a sans-body paragraph,
    inside a table cell, anywhere — into Crimson Pro. A binomial in a
    body paragraph ended up mid-sentence in a different typeface. That
    looked broken more often than it looked "botanical".
    Now em/i inherit the parent font (so body-italic is Inter-italic,
    heading-italic is Crimson-Pro-italic, etc.). The explicit .taxon
    class still gets Crimson Pro italic for labelled-taxon contexts
    (mosaic tile captions, section card titles) where a deliberate
    serif-italic is the design intent.
    Co-Authored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
2026-04-20 blog: first-bloom U. quelchii — rigor pass, IT twin, giscus wired
    Post (EN + IT):
    - "rhizoid" → "stolons" (U. orchidioides species have stolons,
    not rhizoids)
    - Dropped the "red humboldtii" claim; kept the tepui red specialty
    as quelchii + campbelliana only
    - Removed the callus-gland close-up framing — felt too clinical
    for a first-bloom note
    - Added References (Taylor 1989 monograph, Fleischmann 2012,
    Huber 1995 on Pantepui biogeography)
    - Applied user edits from the review pass (my Sophronitis,
    red spot, "slow as hell" / "lente come il diavolo", rosette
    slowly but steadily kept growing, etc.)
    Comments:
    - New layouts/partials/giscus.html wiring GitHub Discussions
    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
    [collection.csv]
2026-04-20 giscus: point to the new dedicated 'Blog comments' category
    Category id DIC_kwDORLduWs4C7Tc- was created on the repo
    for this purpose. Keeps blog reader comments separate from
    the technical Discussions threads.
2026-04-20 social: Mastodon → Instagram (@zoppolig)
    Removed every Mastodon reference (hugo.toml author/sameAs/links,
    head.html rel=me, site-footer.html visible link, about page
    .elsewhere item EN+IT, llms.txt bio). Added Instagram in the
    same slots pointing to https://www.instagram.com/zoppolig.
    rel=me verification chain loses the Mastodon member but keeps
    ORCID, LinkedIn, Scholar, GitHub — still fine for IndieWeb /
    WebFinger discovery. Instagram doesn't support rel=me
    verification back to the site anyway, so it's a plain rel=
    external link rather than rel=me.
2026-04-20 blog quelchii: use all processed photos + the Sophronitis flower
    Added four more figures on both EN and IT versions:
    - utricularia-quelchii-2.jpg: the larger bud, close-up
    - utricularia-quelchii-3.jpg: the second bud, close-up
    - utricularia-quelchii-6.jpg: both buds on the peduncle, pulled
    back to show the Sophronitis root tangle they grew through
    - sophronitis-coccinea-big-one-x-hinomaru-4n-gmwqc-2.jpg: the
    Sophronitis flower — the actual reason the terrarium visit
    happened last week, which is the narrative hook
    Ordering: two-bud catch → main bud close → second bud close →
    both on stem (wider) → Sophronitis flower → terrarium overview.
    Pot/habit (-4.jpg) still sits in th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
2026-04-20 ui: universal back-to-top button on all pages except home
    The home has its own jump-nav pill with a ↑ arrow; every other
    page was stuck scrolling manually to reach the header. New
    layouts/partials/back-to-top.html renders a small pill button
    bottom-right, hidden until scrollY > 400 px, smooth-scrolls to
    top on click.
    Included from baseof.html with `{{- if not .IsHome -}}` so it
    doesn't double up with the home subnav. EN/IT label via
    back_to_top i18n key.
2026-04-20 blog quelchii: -4 and -5 are leaves, not buds
    Corrected by the user. Both utricularia-quelchii-4.jpg and
    -5.jpg show purple-tinted teardrop leaves sitting on the live
    sphagnum, not flower buds. This actually reinforces the
    "tear-drop leaves, sometimes reddish themselves" hook in the
    Why-I-care section — moved both figures there (in sequence),
    removed -5 from the What-comes-next tail.
    EN + IT.
2026-04-21 captions: unify on below-image style everywhere
    The /highland/ hero (Dracula + Grafana pair) and residents grid
    used the older overlay-on-image style — gradient band over the
    bottom of each photo — while the home mosaic had been moved to
    a below-image caption earlier. Same inconsistency on the home
    hero split figure.
    Removed absolute positioning + gradient background from:
    - .highland-hero figcaption
    - .highland-residents span (also dropped the `a` aspect-ratio
    trick + absolute img — now img flows naturally with
    aspect-ratio on img, caption wraps below)
    - .home-hero--split .home-hero__figure figcaption
    Typography aligned to the mosaic pattern: display-serif italic
    for the taxon e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
2026-04-21 Sophronitis #406: award tag WQC → WOC
    The 4N tetraploid of S. coccinea is 'Big One' × 'Hinomaru' and
    has the GM/WOC (Grand Champion / World Orchid Conference)
    honorific, not WQC. Misread from the label photo on first pass.
    Cascaded through:
    - Plant_Inventory.xlsx row 406 species cell
    - living_collection_dendrogram.html leaf name
    - photos/Sophronitis coccinea 'Big One' × 'Hinomaru' 4N GMWOC/
    folder rename (+ masters under _originals/)
    - re-sync pushed the new slugs to static/img/collection/sophronitis/
    sophronitis-coccinea-big-one-x-hinomaru-4n-gmwoc-{,2,3}.jpg
    with regenerated 480/960 srcset variants
    - removed the orphan -gmwqc-* files from static/
    - blog post captions EN + IT
    - /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
    [collection.csv]
2026-04-22 Content accuracy: fog shelves, hero lede
    - Renames "passive-mist shelves" → "fog shelves" (EN) /
    "ripiani a nebbia passiva" → "ripiani nebulizzati" (IT) across
    collection/genera, press bios, and the inventions landing.
    - Rewrites the fog-shelves inventions page (EN + IT) to reflect the
    actual architecture: ultrasonic misters on Tapo P100 plugs driven
    by a second Raspberry Pi running a hysteresis RH loop (~80 %) on
    BME280 + SHT35 readings. Drops the earlier "cheap mains timer /
    no loop / no logging" framing which was inaccurate.
    - Hero lede (EN + IT): "the plant collection it shelters" overclaimed
    — the cabinet houses one subset of four spaces. Rephrased to
    "the wider pl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
2026-04-22 Live strip: fan value labelled PWM, not %
    The underlying JSON field is fan_pwm, a raw PWM duty-cycle number
    (roughly 40–230 after the controller's floor/ceiling clamps). Labelling
    it "%" wrongly implied 0–100 % of max. Switched to " PWM" suffix so the
    display matches the data semantics and the Node-RED UI.
2026-04-23 Content accuracy tail: residual passive-mist references
    Two spots missed in the earlier sweep:
    - hugo.toml author.bio said "passive-mist shelves indoors" — now
    "auto-misted fog shelves indoors".
    - static/llms.txt (the AI-facing site index) described the fog
    shelves as "low-tech passive-mist glass shelves" — rewritten to
    reflect the actual architecture (ultrasonic misters on a
    Raspberry-Pi-driven hysteresis RH loop ~80 %).
2026-04-23 Hotfix: move mosaic-rotate partial inside define main
    The partial was placed after the closing {{ end }} of define "main",
    which left it as orphan top-level content. Hugo rendered just the
    orphan (the rotation <script>) and dropped the actual homepage body,
    producing a white-screened index. Moved the partial call to the last
    line before {{ end }} so it emits as the trailing script of the main
    content block, alongside the ledger JS already there.
2026-04-23 Fix mosaic rotation: don't double-quote POOL_URL
    {{ … | absURL | jsonify }} combined with canonifyURLs=true was
    producing a literal var t='"https://…/mosaic_pools.json"' in the
    served JS — t's value contained leading and trailing double-quote
    characters, so fetch() was hitting an invalid URL and failing
    silently. Replaced with a plain relative string literal; fetch()
    resolves it against the page origin automatically.
2026-04-23 Mosaic rotation: dedupe by URL pathname, not raw attribute
    visibleSrcs keyed on img.getAttribute('src'), which returned Hugo's
    full absolute URL for SSR tiles (canonifyURLs=true) and the relative
    path for post-swap tiles. The candidate filter only normalised one
    side, so a photo already present as an absolute URL could still be
    picked from the pool and end up duplicated in the same mosaic.
    Now both sides run through new URL().pathname, so comparisons are
    always against the same form (/img/collection/…).
2026-04-23 Mosaic pool: researched provenance captions per taxon
    Replaces the generic "Highland cabinet" / "Balcony · outdoor"
    fallback with a hand-curated provenance caption per pool taxon
    (54 entries — 41 terrarium + 13 balcony). Style matches the
    existing hugo.toml featuredMosaic curated entries: 3–10 words,
    geographic + habitat/elevation/distinctive fact.
    - New data/mosaic_provenance.yaml holds a flat taxon → caption
    lookup (exact-match first, then "Genus species" prefix, then
    genus-only, then pool-generic fallback).
    - scripts/generate_mosaic_pools.py reads it via a small inline
    parser (avoids a PyYAML dep for a file that's a flat dict) and
    warns when a taxon falls back to the gener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
2026-04-23 Relabel Stelis sp. (Ecuagenera) → Lepanthopsis astrophora
    Plant was sold as "Stelis sp." by the vendor but is actually a
    Lepanthopsis astrophora (a second accession alongside the Varesina
    one from 2023). Taxonomically the two were once conflated — L.
    astrophora was originally described as Stelis astrophora before the
    Lepanthopsis transfer — so a mis-ID at the vendor is plausible.
    Propagated the rename across:
    - Plant_Inventory.xlsx source (row 370, kept in the upstream
    botanica/dendrogram/ tree, not in this repo) — Genus Stelis → Lepanthopsis,
    Species sp. → astrophora, notes append.
    - Photos renamed from botanica/dendrogram/photos/"Stelis sp."/ →
    botanica/dendrogram/phot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
    [collection.csv]
2026-04-23 Stelis→Lepanthopsis cleanup: shortcode + photo manifest
    Final sweep after the main rename:
    - content/collection/genera/other-orchids/index.{md,it.md}:
    {{< collection-photos "Stelis" >}} → "Lepanthopsis"
    (the catch-all genus page's photo-grid shortcode still pointed at
    the now-empty Stelis genus folder).
    - data/photo_manifest.json: regenerated via copy_collection_photos.py
    — the stale "stelis" → stelis-sp.jpg entries are gone, replaced
    by the lepanthopsis entries.
    Final verification: zero non-CSV "Stelis" references in the repo.
    The one remaining mention is the Features/Notes field on CSV row
    412 ("Originally labeled Stelis sp. by vendor; re-identified as
    Lepanthopsis astro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
2026-04-23 Per-species pages + Species of the week: first issue
    New /collection/species/<slug>/ section, one lightweight page per
    photographed alive taxon (78 initial), auto-generated from the
    inventory. Each page shows provenance, acquisition sources, photos,
    and — when present — a prominent link to the matching deep-dive
    blog post.
    Homepage hero now reads data/featured_this_week.yaml and renders the
    current week's featured species (image + caption + click-through).
    Falls back to the previous Heliamphora macdonaldae tile if the
    featured slug can't be resolved, so the page never breaks on a stale
    pointer.
    First issue: "Species of the Week: Dracula pholeodytes" as a blog
    post under content/blog/sp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
2026-04-23 SOTW #1: audit & correct pholeodytes post with proper references
    Five factual errors in the original draft, corrected after direct
    verification against Kew POWO and IOSPE:
    - Author / year: said 2006 → actually Luer & R.Escobar, Selbyana 7: 68
    (1982). Verified via POWO taxon page (fqId 84003-2).
    - Distribution: said "Colombian Chocó" → actually NE Colombia,
    Boyacá department. Chocó is the western Pacific slope; pholeodytes
    is from the eastern Cordillera, a completely different ecosystem.
    Verified via POWO + IOSPE.
    - Elevation: said 1,500–2,000 m → actually ~2,500 m per IOSPE.
    - Temperature preference: said "cool-growing" → IOSPE says "cold-
    growing" at that elevation.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
2026-04-23 Hotfix: IT translation for SOTW #1 + hero fallback
    Issue: the IT homepage hero linked to /it/blog/species-of-the-week-
    dracula-pholeodytes/ — but only the EN index.md existed, so the IT
    URL 404'd. Anyone landing on /it/ from the hero hit a dead page.
    Fix:
    - Added content/blog/species-of-the-week-dracula-pholeodytes/index.it.md
    with full Italian translation (same structure, same footnote
    citations to POWO / IOSPE / Endara et al.).
    - Hardened layouts/index.html hero: instead of blindly composing
    {{ path | relLangURL }}, now resolves via site.GetPage first. If
    the featured page doesn't exist in the current language, iterates
    site.Sites to find a default-language copy and links ther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
2026-04-23 GSC hygiene: unblock dendrogram, fix sitemap URL, noindex /en/ alias
    The existing static/robots.txt had three issues that together explain
    the "Page with redirect" and "Crawled, currently not indexed" counts
    coming back from Google Search Console:
    1. Disallow: /dendrogram/ — blocked the most unique page on the site
    (the radial phylogenetic tree viewer) from Google. Removed.
    2. Disallow: /data/ — blocked collection.csv + dendrogram.json from
    being indexed. These are legit public data, not "large generated
    assets". Removed.
    3. Sitemap URL pointed at the pre-.com github.io path. Updated to
    https://highlandcloudforest.com/sitemap.xml.
    Replaced with a minimal robots.txt that onl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
2026-04-23 SOTW #1: reframe pholeodytes as "long-tailed monkey," fix morphology
    User feedback: pholeodytes has superlong caudae and is one of the
    coolest monkey-face Draculas — not a quiet, hiding flower. Original
    framing under-sold it.
    Rewrite (EN + IT):
    - Drop the "quiet / hides" rhetorical frame. It's a small sepaline cup
    but dramatic overall because of the caudae.
    - Lead with the visual: heart-shaped speckled cup + skull-like pale
    labellum inside + long dark caudae trailing below.
    - Explicit anatomy sidebar clarifying terminology: the long, thin
    structures are CAUDAE — elongated sepal tips — not petals. Petals
    in Dracula are the two small flanking structures inside the cup.
    (User a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
2026-04-23 Trigger re-deploy after transient Pages failure
    Previous run 24846366735 built clean but the "Deploy to GitHub Pages"
    step failed — known transient Pages infra issue. Empty commit to
    re-trigger the workflow.
2026-04-23 SOTW #1: open on the caudae-span visual (both languages)
    Revision after user feedback: rewrite opening to actually match what
    the photo shows — the sepaline cup is tiny (thumbnail-sized) and the
    triradial caudae span 15–20 cm across the hand in three directions,
    not "vertical drama" hanging straight down. Reframed: "tiny flower
    making a huge gesture," with explicit cup-between-thumb-and-finger
    scale and the two-up-one-down cauda fan. Same fact-checking, same
    sources, just a more honest opening hook.
2026-04-23 /collection/species/ landing: photo-tile grid of all 78 species
    The species landing page rendered only the intro paragraph — no link
    to any of the auto-generated per-species pages, so visitors had no
    navigation path into them. Added a custom list layout that renders
    all .Pages under /collection/species/ as a responsive photo-tile
    grid (2 cols on narrow, auto-fill 180px+ on wider), with taxon label
    and provenance caption pulled from data/species_index.yaml. Tiles
    with an entry in data/species_of_the_week.index get a small ★ badge
    to indicate a deep-dive post exists.
    78 tiles render from a single Hugo range over site pages + data
    lookup — stays in sync automatically when
    scripts/generat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
2026-04-23 SOTW #1: correct cauda span to 10–15 cm (user observation)
    Earlier rewrite said 15–20 cm based on a first-pass read of photo 3;
    grower correction: closer to 10–15 cm of triradial spread. Matches
    IOSPE's 1.5 × 6 in (3.75 × 15 cm) dimension for the flower with tails
    included. EN + IT.
2026-04-23 SOTW #1: rewrite in Barry Rice / ICPS voice — terser, funnier, less pompous
    User wanted the tone closer to Barry Rice (sarracenia.com) / ICPS:
    first person, short sentences, dry humor, direct advice, no AOS-
    Orchids-magazine mellifluence. Both EN + IT rewritten end to end.
    Sample before / after (EN opening):
    was: "Dracula pholeodytes is a tiny flower making a huge gesture.
    The sepaline cup itself is barely bigger than a thumbnail —
    a dark-maroon speckled dome — but the three sepals extend
    into long, dark caudae (the genus-defining tails, not
    petals) that fan out in three directions, spreading the
    whole flower across roughly 10–15 cm of space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
2026-04-23 SOTW #1: fix cultivation-spot description (basket+bark, not mounted on cork)
    Pholeodytes is in a 10 cm black plastic basket with bark mix, hanging
    lower-right below the Heliamphora — not mounted on a cork slab as the
    earlier drafts claimed. EN + IT.
2026-04-28 SOTW #2: Heliamphora macdonaldae (Cerro Duida)
    Tepui endemic from the 1928 Tyler-Duida Expedition. Plant, place,
    exploration, cultivation (kanuma + LFS + 1 cm RO), and the open
    mystery of the eponym Mrs Macdonald — Latin -ae tells us she's a
    woman; the protologue and personnel list place her outside the
    expedition. Reference inquiries to NYBG and AMNH archives pending.
    "More to follow…" line points readers at the open puzzle.
2026-04-28 SOTW #2: corrections — substrate history, light setup
    User-corrected facts:
    - Substrate split into two phases: lapillus+pumice+bark+50% LFS
    (2016-early 2023, chiller-cabinet years) -> kanuma+LFS from 2023
    in the new highland cabinet (markedly more aerated).
    - Light: drop "direct sun cooks pitchers" claim - never grown
    outdoors. Replace with actual setup: 30-40 kLux LED at top
    of cabinet, no full-sun experience.
2026-04-28 SOTW #2: factual fixes — 30 years (not 50), 3 new species (not 3 of 4)
2026-04-28 SOTW #2: IT rewrite for natural register, embed Cerro Duida gmaps
    - Italian post rewritten for idiomatic register (not literal
    translation): "armadio" -> "vetrina", drop anglicisms ("paper",
    "outdoor", "in extra"), drop awkward calques ("rimpiazzato",
    "non si offende", "la metà del cambiamento che porta il peso").
    - Embed Google Maps satellite iframe of Cerro Duida in both EN
    and IT, with the link kept as fallback.
    - Tighten the eponym phrasing in EN+IT: "of mysterious identity" /
    "dalla misteriosa identità".
2026-04-30 Add deep-clean build log + May 2026 highland timeline entry
    Bilingual EN/IT page bundle at content/blog/highland-cabinet-deep-clean/
    with six embedded photos. Appends a May 2026 entry to the highland photo
    timeline (oldest-first list). Documents the first cabinet deep clean
    since it went online, traced to a single dead corner-fan.
2026-05-01 Deep-clean post: factual corrections
    - canalina is an aluminum fold suspended on fishing line at 5° tilt,
    not a polycarbonate strip; the wave pattern in canalina.jpg is the
    serpentine refrigerant-tube pressing on the back of the evaporator
    - selfie shows the start of the scrub-down, not the cable recrimp
2026-05-01 Deep-clean post: canalina is in the lower part of the frame, not upper
2026-05-01 collection: add mini & micro cool orchids wishlist
    Curated list of mini and mini-micro cool/cold/intermediate-cool growers
    with showy flowers, organized by EU vendor (Ecuagenera Europe, Großräschener,
    Claessen) plus a watchlist across Pleurothallidinae, NG/Asian, African/Madagascan,
    Mexican/Central American, and Brazilian groups. All rows tagged with size and
    temperature class; vendor URLs embedded; adversarial pass applied to drop
    warm-leaning and oversized species.
2026-05-01 fix: cabinet has been online since 2022 (not 2023)
    Photo evidence (May 2022 build photo + the existing "8 months in" / "13
    months in" timeline math) confirms the cabinet went online in 2022, not
    2023 as the prose claimed in two places. Also reframes the deep-clean
    post to acknowledge four years total uptime with two years of recent
    mold buildup, instead of "two years in".
    - highland/_index.{md,it.md}: Operational since 2023 → 2022
    - macdonaldae blog en+it: cabinet online since 2023 → 2022
    - highland-cabinet-deep-clean en+it: title/description/body reframed
    from "two years" cabinet age to "four years online, two of mold"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
2026-05-02 Wishlists: trim AI-flavored prose
    - drop "Considered, not in this cart" / "Superlatives" / "Context" / "Bottom line" sections from Tillandsia
    - replace "Rationale" promotional-copy column with terse factual notes
    - keep prices, vendor info, key provenance flags
    - same treatment on Pinguicula and Phalaenopsis Aphyllae
    - shorten landing page lede
2026-05-02 Wishlists: per-species vendor search URLs (one click to the plant)
    Each species link now opens the vendor's search results for that
    species name, instead of the vendor's catalog landing page. Per-vendor
    templates (PrestaShop / WordPress / Shopify / Shopware patterns).
    Hromadnik unchanged — static stock-list page, no search.
2026-05-02 Wishlists: fix hallucinated vendor URLs
    Five vendor URLs in the pleurothallidinae wishlist (and the wishlists
    landing) were hallucinated — all NXDOMAIN per DNS:
    - ecuageneraeu.com -> ecuagenera.com
    - grossraeschener-orchideen.de -> orchideenwlodarczyk.de
    - schwerter-orchideen.de -> schwerter-orchideenzucht.de
    - loscrignodinebbia.it -> loscrignodinebbia.com (.com, not .it)
    - quintacamallera.com -> URL unconfirmed; row kept, link removed
    Real URLs verified by DNS resolution + HTTP 200 (where probable).
    Großräschener mapping confirmed against reference_vendors.md
    (orchideenwlodarczyk.de is Petra Wlodarczyk's miniature-orchid
    nursery, the vendor sometimes referred to as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
2026-05-03 docs: update PID + schema for May 2026 control changes
    - PID controller (en+it): MAX_SPEED is now uniform 255 (time-of-day
    caps removed 2026-04-30); morning A/B experiment removed 2026-05-03
    after 13 days of data showed treatment effect within noise
    - Schema (en+it): target_humidity_computed clamp updated 70-90% → 75-95%
    (floor lowered 80→75 on 2026-05-02 once the 95% cap was added)
2026-05-04 blog: light curve C — raised cosine LED schedule (replaces step plateaus)
    Documents the 2026-05-04 LED dimmer refactor: dimmer-chain step schedule
    (40-60-40 plateaus) replaced by a raised-cosine smooth curve (floor 35,
    peak 70 at solar noon). +23 % daily AUC, redistributed so the late-
    afternoon shoulder stays warm enough to prevent the observed 15:00–18:00
    humidity creep.
    Includes 3-week pre-change baseline charts (temp/humi vs target with
    95 % CI by hour-of-day; outlet fan PWM by hour) and an AUC variant
    comparison. Promises a followup post on 2026-05-25.
    EN + IT versions, 5 PNG figures, generation script at
    ~/terrarium-analysis/light_curve_charts.py.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
2026-05-05 blog/light-curve-c: Day-1 update with mist analysis & tuning
    First full day under Curve C (2026-05-05). Adds:
    - day1-overview.png: cabinet T/RH/slider trajectory through today
    - mist-delta-distribution.png: per-event RH gain by regime (n=96/10/17)
    - Day-1 addendum (en + it) covering: dawn/dusk soft-ramp restoration,
    UI gauge wiring, LED dim-signal watchdog, and the regime-aware mist
    trigger derived from the 21-day mist-event study (~+2% night sealed
    vs ~+3-4% day mixing -> two thresholds, two durations)
    - HANDOFF: dated entry with explicit DO-NOT-TOUCH list for Mac-Claude
    Chart script: ~/terrarium-analysis/light_curve_day1_charts.py (Pi only).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
2026-05-05 blog: light curve C IT — fix non-native phrasing in Day-1 addendum
    Pi-Claude's IT translation used "atterrare" transitively (calque from
    "to land [something]") in 4 places — not valid in Italian, where
    atterrare is intransitive. Replaced with portare/stabilizzarsi
    depending on context. Also: missing preposition in "trigger automatico
    nebulizzazione" → "trigger automatico di nebulizzazione"; "fisica
    sotto" → "fisica sottostante"; "segretamente" calque → "in realtà".
    Numbers, regime names, and technical jargon untouched.
2026-05-06 blog: macdonaldae — NYBG May 2026 update (holotype + Torrey ledger)
    Stephen Sinon (NYBG Mertz Library) replied with the type sheet URL and a
    1931 ledger search:
    - Holotype is NY 00387773 (Tate no. 1022, "Top of Peak no. 7", 7100 ft).
    Three labels: field/Tyler-Duida label, Gleason's "TYPE OF" determination,
    and Maguire's 1973 reduction to var. macdonaldae (formalised 1978).
    No etymology note in Gleason's hand on the sheet.
    - 1931 Torrey ledger: no McDonald/MacDonald/Macdonald donor to the
    publishing fund. Only Fleda Griffith ($10, Garden staff photographer).
    NYBG rules itself out on both counts. AMNH archives still pending.
    Adds holotype-ny00387773.jpg (CC BY 4.0 via GBIF, NYBG a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
2026-05-06 blog: macdonaldae — tighten Update section, drop AI cadences
    Removes a few writerly tics from the new "Update — NYBG, May 2026" section
    that read more like AI-summary patterns than the rest of the post:
    - "Two pieces." → woven into the lede sentence
    - "The hope that he had quietly written … turns out not to be how he
    worked" → "Apparently he didn't write etymology notes on his type sheets"
    - "rules itself out on both counts" / "The remaining hope is" → "neither
    line at NYBG produces a name … What's left is …"
    - IT: "fotografa di staff" anglicism → "fotografa interna";
    "in mano a Gleason" → "di mano di Gleason"
    Substance unchanged; voice is tighter and more direct.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
2026-05-06 docs/pid-controller: document Auto / Pause / Max operator buttons
    Wired up end-to-end on 2026-05-06. The three Dashboard buttons drive
    Manual Fan Control which now sets both flow + global manual_fan_mode,
    so every downstream node sees one consistent state.
    Key behaviour change: in manual_fan_mode === 'manual', door-safety's
    fan-stop is bypassed (light/freezer/mister door-safety logic untouched).
    This makes Max-with-doors-open actually run the fans during cleaning,
    the original intent of the buttons.
    Updated guard conditions list, added an Operator Controls section with
    the per-button table, and inverted priority 0/1 in the control hierarchy
    since manual override now legitimately outranks d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
2026-05-06 HANDOFF: note 2026-05-06 docs update for operator buttons
2026-05-07 docs(architecture): clarify lights wattage — nameplate vs hardware cap
    The "4×100W" line read as if the array routinely pulled 400 W. Per the
    2026-04-18 ledger verification, each ChilLED Logic Puck V3 is 100 W
    nameplate but hardware-capped to ~60% via the screwdriver potentiometer
    and PWM-dimmed during runtime; combined array peaks ~150–200 W, not 400.
    Replacing the nameplate-only blurb with an accurate one-liner.
2026-05-07 deploy: areas section + 8 new species pages + Mac-side data refresh
    - New /areas/ section (balcony, windowsill, fog-shelves, highland-terrarium,
    mini-ponds) with EN+IT pages, layouts, manifest, and photos.
    - Highland landing pages now link to /areas/highland-terrarium/ via a "70+
    species live inside" banner.
    - Auto-generated species pages: ceratochilus-biglandulosus, gastrochilus-
    japonicus, haraella-retrocalla (purchased as H. odorata, synonym),
    restrepia-sanguinea, tillandsia-aeranthos, tillandsia-tricholepis,
    trichoglottis-pusilla (purchased as T. putida, synonym).
    - Refreshed body prose on angraecum-didieri, bulbophyllum-thiurum,
    dracula-vlad-tepes, ornitophora-radicans, scho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
    [collection.csv]
2026-05-07 photos: 14 to existing plants + Amorphophallus konjak + 10 highland-terrarium area shots
    - New plant: Amorphophallus konjak (Monocots > Alismatales > Araceae),
    vendor unknown, acquired 2023, 5 photos
    - Iris louisiana 'Bout Midnight': +1 photo
    - Neofinetia falcata: +3 (first photos for this taxon)
    - Utricularia quelchii: +7 photos
    - Heliamphora macdonaldae (Cerro Duida) ISC: +3 photos
    - /areas/highland-terrarium/: +10 scene photos (now 12 total)
    - Manifests + dendrogram + species pages + stats regenerated automatically.
    [collection.csv]
2026-05-07 blog: U. quelchii first-bloom post — Day-17 update, the larger flower is open
    - New "Update — 2026-05-07" section in EN + IT
    - 5 new photos (utricularia-quelchii-7/9/10/11/13) showing bud cracking,
    side profile, three-quarters with second bud still closed, head-on, and
    macro of the open face
    - Honest notes: still no lux meter, colour reads cooler-magenta than the
    deep-red Taylor 1989 plates suggest, second bud not yet open
2026-05-07 fix: restore HTML scaffolding on dendrogram master + static viewer
    The master living_collection_dendrogram.html had lost everything from
    <!DOCTYPE> through the opening <script> tag at some point — leaving
    the file with const data = {...} as line 1 and only the closing
    </script></body></html> at the end. port_dendrogram.py copies the
    master verbatim into static/dendrogram/index.html, so the browser
    was rendering a stub with no D3 import and no opening tags.
    Reconstructed the master by prepending the head/style/body/D3-CDN
    scaffolding from the last known-good commit (1cbaebe) ahead of the
    current data block. Then re-ran port_dendrogram.py to rebuild the
    static viewer (now 1169 lines / 98 KB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
2026-05-07 fix: dendrogram JS was incomplete — restore complete renderer from HEAD~3
    Previous fix (4b73606) only patched the HTML scaffolding but left the
    JS rendering block from the broken master, which was missing one closing
    }); near the end. node --check confirmed: SyntaxError: Unexpected end of
    input. The browser thus aborted execution and rendered nothing.
    This commit rebuilds the master with:
    - HEAD~3 HTML scaffolding (lines 1-373)
    - current data line (with Amorphophallus konjak + new photos)
    - HEAD~3 complete JS rendering block (793 lines including the missing });)
    - HEAD~3 closing tags
    node --check now passes the JS block. The .broken-2026-05-07 backup
    preserves the original corruption for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
2026-05-07 ledger: refresh data + update mist/kWh captions for 2026-05-05/06 changes
    - data/ledger.json refreshed: 2026-04-20 → 2026-05-07 as_of, +50 mist
    cycles, +46 kWh, +€14, +0.36 fog hours·month from the live API.
    - Mist caption (en + it): document the 2026-05-05 regime-aware tuning
    (10s day / 20s night) and the per-event RH gain numbers from the
    21-day analysis (+2% night sealed, +3-4% day mixing). Replaces the
    stale "few seconds" generic phrasing.
    - kWh caption (en + it): bump midday peak 170-180W → ~220W, attribute
    to Curve C raised cosine schedule active since 2026-05-04.
2026-05-07 Species of the Week issue #3: Utricularia quelchii
    Encyclopaedic SOTW companion to the 2026-04-20 first-bloom diary post.
    Hero flips to /img/collection/utricularia/utricularia-quelchii-10.jpg
    (open-flower side profile).
    Topics: provenance (Carnivors & More, Klein, Ilu Tepui 2023);
    cultivation (live Sphagnum permanently saturated under cabinet mister
    on the airflow side, no manual watering — explicit departure from
    Barry Rice's perlite+drier recipe, with airflow as the load-bearing
    substitute); discovery history (Quelch & McConnell 1894 Roraima
    collection, type Quelch & McConnell 105 K, Brown 1901 protologue);
    namesake J. J. Quelch; section Orchidioides (Taylor 1989 strict 9 sp.,
    Rodrigues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
2026-05-07 ci: add weekly ledger-refresh workflow
    Runs every Sunday 04:00 UTC. Refreshes website/data/ledger.json from
    the public Pi endpoint via the existing fetch_ledger.py script (which
    has built-in fallback to the previous file on Pi outage), and pushes
    only if values changed. The resulting push triggers hugo-deploy.yml
    automatically. Manual run via workflow_dispatch.
2026-05-07 SOTW #3 (U. quelchii): add intra-species colour-variation discussion + 4 photos
    New section "Pink, red, or both?" addresses the genuine question — my
    plant is magenta, but vendors and habitat photographs depict everything
    from pink to blood-red. Source: An D Smith's Mt. Roraima documentation
    (CPUK forum), which establishes that the deep-red phenotype is
    restricted to Roraima, and that other tepuis (Ilu, Auyán) carry pink-
    to-magenta forms with two-flower scapes. Working hypothesis discussed
    on the forum: introgression with sympatric U. campbelliana on Roraima
    (no molecular study yet).
    Added 4 figures: -7 (bud cracking, post "How it got here"), -11 (head-
    on, in colour-variation section),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
2026-05-10 auto: weekly ledger refresh
2026-05-10 collection: 11 new accessions from Orticola 2026 (#433-443)
    Sat 2026-05-09 haul, all photographed and tagged 2026-05-10.
    Camarda (st. 64, Le Figlie del Vento) — 4 Tillandsie:
    - T. roezlii
    - T. tectorum f. caulescens (caulescent form, distinct from f. gigantea)
    - T. didisticha
    - T. 'Love Knot' (cv hybrid)
    Michieli (st. 111) — 1 Tillandsia sp. (indet., ID at repot)
    Piante Pazze (st. 27) — 1 Cymbidium goeringii 'Tian Cao'
    (substituted day-of from the pre-ordered 'Da Tu Yuan' — Marco didn't
    have it in dividable shape that morning. Tian Cao = Amakusa-line cv,
    cream-margined variegated foliage, fragrant). Body.md cultivation
    sidecar pre-staged with Hyuga+Kanuma substrate, 0–14 °C
    ver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
    [collection.csv]
2026-05-10 collection: in-page lightbox in species table, latest-acquisitions section, count updates, prices for #433-443
    - Species table thumbnails now open the same in-page lightbox as the
    photo grid (button[data-photos] hook). Was: <a target="_blank">
    forcing a new tab. CSS adapted for both <a> and <button> selectors.
    - New "Latest acquisitions" section on /collection/ home below the
    Golden Three (EN: index.md, IT: index.it.md), driven by a new
    `latest-acquisitions.html` shortcode that reads collection.csv,
    sorts by id descending, and renders 12 most recent with thumbnails
    + acquisition date + source + price (lightbox-wired).
    - Cymbidium added to "Other Orchids" page (EN + IT) with the T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
    [collection.csv]
2026-05-10 copy: clarify the 2022 / 2016 timeline on highland landing + ledger intro
    The phrase "Operational since 2022" was ambiguous — referred to the
    current marine-fridge cabinet, but ignored the chiller-cooled
    predecessor that ran from 2016 and from which several plants migrated
    across (visible e.g. in the macdonaldae SOTW post). Reworded to:
    - highland landing envelope strip: "Marine-fridge cabinet operational
    since 2022 (chiller-cooled predecessor running since 2016)"
    - ledger_intro i18n string: "The current marine-fridge cabinet has
    been running since late 2022, and replaced a chiller-cooled tank
    that ran from 2016."
    EN + IT mirror.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
2026-05-10 copy: drop dev-leaked auto-gen banner; IT vetrina→armadio sweep
    - Removed visible "This section is auto-generated by
    scripts/generate_species_pages.py — rerun it after adding plants…"
    banner from /collection/species/. Reader-facing copy reads as
    documentation now, not as a dev TODO.
    - Italian sweep: vetrina/vetrine → armadio/armadi (more idiomatic for a
    controlled grow cabinet in IT plant-keeping). Article elision and
    gender agreement handled in two regex passes:
    * pronouns (Quella → Quell', questa → quest')
    * adjectives that came along with vetrina (chiusa→chiuso,
    sigillata→sigillato, nuova→nuovo, vecchia→vecchio,
    svuotata→svuotato, raffr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
2026-05-10 copy(IT): armadio → terrario site-wide; fix 'metà cabinet' leftover
    Per user feedback — 'terrario' is the canonical IT word for the
    controlled grow chamber in plant-keeping community usage, idiomatic
    match for EN 'cabinet'. Already used at the title level
    ('Il terrario d'alta quota'); now consistent throughout.
    14 files affected. Article/preposition contractions handled
    (l'armadio → il terrario; nell'armadio → nel terrario; etc.).
    Both nouns are masculine — no gender drift on adjectives, so the
    previous vetrina→armadio agreement fixes carried over cleanly.
    Plus one English leftover caught: 'a metà cabinet' →
    'a metà altezza nel terrario' in the U. quelchii SOTW IT post.
    C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
2026-05-10 fix(shortcodes): scope $-vars properly to fix Pages build
    Two shortcodes used \$.taxon / \$.genusSlug to escape inner range/with
    scopes — but Hugo \$ refers to the page context, not the outer range
    iterator. The build failed for 4 commits straight on GitHub Pages.
    - collection-species.html: capture {{- \$rowTaxon := .taxon -}} before
    the {{- with .photo -}} block; use \$rowTaxon inside.
    - latest-acquisitions.html: same pattern — capture {{- \$rowGenusSlug
    := .genusSlug -}} at the top of the range body, use it inside the
    \$photos = \$photos | append … construct.
    Local hugo build now passes clean.
2026-05-10 homogenize: convert markdown-table genus pages to collection-species shortcode
    other-orchids, other-genera, outdoor were the three remaining genus
    landing pages still rendering hand-written markdown tables — visible
    aesthetic inconsistency vs. heliamphora/dracula/dendrobium/sarracenia
    which already used the styled {{< collection-species >}} shortcode
    (filterable, with status pills, photo column → in-page lightbox,
    location badges, source links, count summary header).
    Replaced each section's MD table with one or more {{< collection-
    species "Genus" >}} calls. Narrative paragraphs above tables kept;
    genera index in frontmatter expanded to actually list every genus the
    page covers (e.g. ot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
2026-05-10 collection: ID Tillandsia sp. (Michieli) → T. baileyi var. vivipara (#437)
    Identified post-acquisition. Updated:
    - Plant_Inventory.xlsx row #437: species → 'baileyi var. vivipara';
    Photo column path corrected; notes updated.
    - Master living_collection_dendrogram.html: leaf renamed in the JSON
    tree; photo paths in the leaf's photos[] array rewritten.
    - Photo folder renamed: photos/Tillandsia sp. (Michieli)/ →
    photos/Tillandsia baileyi var. vivipara/.
    - Stale species page content/collection/species/tillandsia-sp-michieli/
    removed; new tillandsia-baileyi-var-vivipara/index.md auto-generated.
    - Website static tree resynced (collection.csv, dendrogram.json,
    photo_manifest, species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
    [collection.csv]
2026-05-11 blog: U. quelchii — Day-21 both-flowers-open update + 3 photos
    - SOTW post: swap opener to new side-profile (photo 15), add Update section with both-open context shot (14) and second-flower throat macro (16). Update body line about "second still closed" to past tense.
    - First-bloom diary: add Day-21 update with the two-open shot + throat macro. Confirms clone-uniform colour, no shift toward Roraima red on the second flower.
    - IT versions mirrored.
    - Sync touched: photo_manifest.json (113 → 114 indexed taxa unchanged but +3 quelchii entries), dendrogram.json/index.html (quelchii leaf photos array extended).
2026-05-11 HANDOFF: ask Pi-Claude to rotate the environmental_control PAT
    New token value lives in Mac's Keychain (service github_pat_environmental_control). Pi-Claude needs to find what's currently using the old PAT on the Pi and install the new one. Token value not in repo for obvious reasons.
2026-05-11 home hero: per-slug primary_photo override + use it for U. quelchii
    Add data/species_hero_overrides.yaml as a thin override map for generate_species_pages.py — keeps the auto-pick (alphabetically first photo) for everyone else, but lets a SOTW species feature its best portrait instead of the catch shot.
    For utricularia-quelchii: hero now uses utricularia-quelchii-15.jpg (the open-flower side profile, same as the SOTW post opener) instead of utricularia-quelchii.jpg (the original 2023 catch shot framed against Sophronitis roots).
    Mechanism: load_hero_overrides() reads the YAML; primary_photo := overrides.get(slug, photos_info["primary"]). species_index.yaml + the per-species index.md fron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
2026-05-11 docs(architecture): document health-monitor safety chain + STUCK RELAY guards
    terrarium-health.py was not previously described in the architecture doc.
    Added a "Health Monitoring & Safety Watchdogs" section covering the cron'd
    monitor, the cross-checks it runs, the power-vs-commanded STUCK RELAY
    detection, and the three guards added today (hysteresis, transition-window
    suppression, fresh re-poll before auto-fix) after two false-positive
    AUTO-FIX events on 2026-05-10/11.
    Tag: stuck_relay_hysteresis_2026_05_11
2026-05-11 docs(architecture): refit STUCK RELAY power model from real data
    The 2026-05-11 hysteresis+transition-window patch exposed a deeper bug:
    the power-vs-slider model (lights_w = slider * 2.0, base 9 W) predicted
    149 W at Curve-C peak (slider 70) but the cabinet actually draws ~220 W
    — off by exactly the 70 W STUCK threshold, so any sustained 5-cycle peak
    fired a false positive.
    Refit from 7 days of freezer-OFF + mister-OFF Meross data via
    /tmp/fit_lights_model_v2.py:
    - lights-off baseline: 17 W (night)
    - slider 70 at Curve C peak: 220 W (p10=219, p90=222, n=255)
    - LED slope: 2.71 W/slider, plus 13 W daytime fan/heatsink overhead
    New model lands at 212 W expected vs 220 W observed at C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
2026-05-11 paper: working artefacts for manuscript rebuild (survey + HardwareX review)
    Two analysis documents produced 2026-05-11:
    - SURVEY_2026-05-11_manuscript_rebuild.md (306 lines, 134 table rows):
    per-draft promote/demote/cross-ref tables for all four papers, shared
    consistency numbers verified against collection.csv and ledger.json,
    website cross-reference inventory, and seven open decisions.
    - REVIEW_HARDWAREX_2026-05-11.md (221 lines): adversarial review of
    HardwareX as a hostile-but-helpful peer reviewer would write. Calls
    out blocking placeholders, numbers that contradict measurements, the
    evaporator-location error, missing operational learnings, and the
    thin reference list.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
2026-05-11 paper(hardwarex): rewrite against survey + adversarial review
    Major revisions:
    - Abstract: corrected headline numbers (76 accessions / 32 genera / 4 continents
    / 4 years / ~1 m³); added safety chain mention and measured 2.6 kWh/day.
    - §2 Applications: same number fixes + ledger figures.
    - §5.2.2 Cooling: corrected evaporator location (lower portion of back wall,
    not "upper region"); added the biological rationale for the resulting
    inverse-stratified cabinet gradient.
    - §6.6 Safety Considerations: expanded into a 9-layer operational safety chain
    (door interlock, mister failsafe, freezer daytime gate, wet-bulb gate,
    manual-override timeout, USB watchdog, LED-fault watchdog, power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
2026-05-11 paper(cpn,aos,icps): Pass A number fixes to align with verified system state
    Mechanical edits across the three companion drafts to match the verified
    cabinet contents (collection.csv) and operational record (ledger.json):
    - "three years" → "four years" / "Three Years" → "Four Years" / "3+ years"
    → "four years" (system has been running since May 2022).
    - "approximately 120 species" / "~120 species" → "76 living accessions
    across 32 plant genera" (cabinet count, not full collection).
    - "five continents" → "four continents" (S America, Africa, Asia, Oceania;
    the broader collection is split across more locations but the cabinet is
    specifically 4-continent).
    - "1.5 x 0.6 x 1.1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
2026-05-11 paper: codex adversarial review of hardwarex
    Diagnostic-only pass. Verdict BLOCK with three top issues: watchdog/manuscript
    contradictions, incompatible power-section denominators, and HardwareX
    reproducibility gaps. Survey/Pi-Claude disagreements surfaced for adjudication.
2026-05-11 paper: codex adversarial review of cpn-paper
    Diagnostic-only pass. Calibrated against survey + HardwareX companion review
    + Codex HardwareX review to avoid double-flagging. Captures the Pass A → Pass B
    gap and notes contradictions for adjudication.
2026-05-11 paper: codex adversarial review of icps-paper
    Diagnostic-only pass with synthesis-paper posture. Heavy attention on §6.1
    convergent-cloud-forest thesis (Pi-Claude flagged it as load-bearing and
    unreviewed) plus §4.3 IV/2SLS and §5 heat-balance rigor. Concrete §3
    ledger contradictions flagged for adjudication.
2026-05-12 paper: Mac-Claude counter-review of yesterday's Codex pass
    Second half of Mode A (goal-aligned defence). 17/17 high-leverage Codex
    claims verified against POWO + IOSPE + Crossref + local repo + collection.csv
    + arithmetic. One direction correction on power numbers (2.60 is the spurious
    figure, not the EUR 253 cost). One Codex finding (15-h time-shift) flagged as
    bigger than Codex realized — controller may not phase-shift at all. Action
    ladder proposed for Pass B.
2026-05-12 HANDOFF: ask Pi-Claude for Pi-side adjudications driving Pass B
    Nine items split P0/P1/P2. P0 (time-shift phase vs buffer, watchdog v7-vs-v10)
    propagates across all four paper drafts. P1 (refrigerant label, power
    baseline, terrarium-health.py existence, 12V/24V fan rail) blocks HardwareX.
    P2 (schema/ledger split, D. victoriae-reginae website sweep, U. quelchii
    phenology mining) can land alongside Pass B.
2026-05-12 scripts: commit deployed arduino-watchdog.sh v10 (reconcile with paper)
    The repo had v7 (60-s checks, reboot-first heartbeat). The live Pi has been
    running v10 since 2026-04-08 (15-s checks, USB-sysfs reauth, 15-30s recovery).
    HardwareX §5.8/§7.6 already describes v10 — committing the actual deployed
    script so the manuscript and the design-file archive agree.
    systemctl cat arduino-watchdog → ExecStart=/usr/local/bin/arduino-watchdog.sh
    this file is byte-identical to that path.
    Tag: watchdog_v10_committed_2026_05_12 (closes P0.2 from HANDOFF 2026-05-12)
2026-05-12 scripts+docs+paper: terrarium-health.py + schema=33 + energy SoT
    Three closely-related closures on Mac-Claude's 2026-05-12 ask list:
    1. scripts/terrarium-health.py: committed the deployed cron monitor with all
    credentials redacted (Gmail app pass, Tapo creds, CallMeBot key, phone,
    addressee). Source: /usr/local/bin/terrarium-health.py at 2026-05-12.
    Closes P1.5; HardwareX L631 reference is now real, not orphan.
    2. docs/schema.md: 32 → 33 measurements (matches ledger.json + live
    `SHOW MEASUREMENTS`). The 33rd: see file. Closes P2.7.
    3. paper/energy_sot_2026-05-12.yaml: single source-of-truth for the Meross
    energy numbers, with reconciliation note explaining why the survey'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
2026-05-12 HANDOFF: Pi-Claude reply on the 9 Pass-B adjudications (2 reversals)
    Closed 7 of 9 locally + pushed today:
    - P0.1 (15-h shift) — implementation IS a real phase shift (915m/885m queries
    in live flow), Pearson r=0.726 vs Colombian temp 15h prior. BUT the manuscript
    wording across all 4 drafts is BACKWARDS: claims "Colombian day → Italian
    night" inversion, when the shift's purpose is to *correct* the time-zone
    inversion and produce same-phase day/night alignment.
    - P0.2 watchdog v10 committed (f17ac63).
    - P1.4 energy SoT YAML committed; Mac-Claude's "correction" (2.24, €253) was
    itself wrong because ledger.json uses 94.3-day denominator where real daemon
    window is 80.34 days.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
2026-05-12 paper(hardwarex): close P1.3 (R134a) + P1.6 (12 V fan rail) from HANDOFF 2026-05-12
    P1.3 — Vitrifrigo ND50 refrigerant confirmed by user (gas ecologico R134a).
    Updated:
    - §4.3 BOM line: refrigerant R134a, with ODP=0 + GWP₁₀₀≈1430 + F-gas
    certification note.
    - §5.2.2 narrative: pre-charged with R134a explicitly.
    - §6.6 safety: certification note refined (installation OK; refill requires).
    P1.6 — Fan-side voltage confirmed by user (everything on the fan side is 12 V).
    Updated §5.3.2 Power Distribution:
    - 12 V DC rail now correctly lists all internal Noctua fans (NF-F12 iPPC
    evaporator + circulation, 60 mm outlet + impeller, NF-A12x25 condenser)
    plus the heatsink axials a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
2026-05-12 paper(hardwarex): Pass B — numbers, 15-h shift rewording, design files, novelty defence, refs
    Pass B against MAC_CLAUDE_COUNTER_REVIEW + survey + CODEX review. Closes the
    HardwareX-side of the manuscript-rebuild pipeline modulo author/Zenodo/figures.
    Number corrections:
    - Cabinet count 76 → 75 accessions, 32 → 31 genera (A. somalensis is on a
    fog shelf, not in the highland cabinet — user adjudication 2026-05-12).
    Cabinet now described as "three biogeographic provinces" (Neotropical
    highlands + SE Asian highlands + PNG/Oceania) instead of "four continents"
    (Africa drops with Aerangis).
    - Power 2.60 → 2.63 kWh/day, €253 → €288/year @ €0.30/kWh. Source: clean
    trapez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
2026-05-12 paper(aos): Pass B — narrative reconstruction (species accuracy + voice + structure)
    Per Codex/Mac-Claude review + user adjudications. AOS was the highest-leverage
    target after HardwareX because species errors here are credibility-breakers for
    the orchid-hobbyist audience.
    Species accuracy:
    - Dendrobium victoriae-reginae correctly framed as Philippine / sect. Calcarifera
    per POWO and IOSPE (not PNG / sect. Oxyglossum as the prior draft and the
    website genus page imply). Now sits alongside the genuine PNG/Oxyglossum group
    (D. cuthbertsonii, D. cyanocentrum, D. hellwigianum) rather than as their flagship.
    - Dracula vampira removed as a Colombian cabinet species (it is Ecuadorian per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
2026-05-12 paper(cpn): Pass B — species accuracy, U. quelchii bloom, deep-clean episode, Light Curve C
    Per Codex/Mac-Claude review + user adjudications. CPN is the second-largest delta
    after AOS because §3 species sections were placeholders and the *Utricularia* /
    *Nepenthes* biogeography was wrong.
    §3.2 Highland *Nepenthes* — placeholder replaced with the verified accession list
    from collection.csv: 9 alive across Sumatra (4), Sulawesi (2), Philippines (2),
    plus one ID-uncertain horticultural specimen. "Borneo and Sumatra" wording
    removed everywhere; the cabinet has no Bornean accession (the most familiar
    Bornean species are now cited only for biogeographic completeness).
    §3.3 Utricularia sec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
2026-05-12 paper(icps): Pass B — convergence-thesis nuance preserved, species accuracy, full §3.3 U. quelchii rewrite
    Per Codex/Mac-Claude review + user adjudications. ICPS is the synthesis paper
    and got the heaviest §3 ground-truth rebuild; the convergence framing was
    PRESERVED per user direction (not narrowed hard as Codex/Mac-Claude originally
    suggested) but the most egregious overclaims were addressed.
    Convergent-cloud-forest framing (§1, §6.1): kept the convergence thesis as
    the load-bearing claim, but added the Hamilton-Juvik-Scatena (1995) /
    Bruijnzeel et al. (2011) caveat distinguishing *climatic* convergence
    from vegetation-type identity. Tepui summit grasslands are now correctly
    descri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
2026-05-12 collection: A. somalensis → shelves (was highland)
    Pi-Claude flagged in HANDOFF 2026-05-12 Pass B: A. somalensis is on a
    humid shelf, not in the highland cabinet. POWO confirms the species
    inhabits seasonally dry tropical biome — not a cloud-forest taxon.
    Until this fix, anyone re-deriving the cabinet inventory from the CSV
    got 76/32 instead of the correct 75/31 that the four manuscripts cite.
    After fix: highland.alive = 75 across 31 genera, matching all four
    paper drafts (hardwarex, aos, cpn, icps).
    [collection.csv]
2026-05-12 ledger: scale kWh/cost by daemon window, not the metadata `since`
    The Meross daemon only started recording power on 2026-02-18, but the
    ledger endpoint's `since` field is 2026-02-04 (first sample of any
    measurement in InfluxDB). Both the Python builder and the client-side
    auto-refresh were dividing the kWh integral by the full `as_of − since`
    window, which silently under-estimated kWh/day (2.24 instead of the
    verified 2.63) and €/month accordingly.
    Fix: parse the daemon-start date out of `electricity.source` — or use
    an explicit `electricity.window_start` if Pi side adds it — and use
    that as the denominator for `electricity` and `cost_eur` only. Other
    counters genuinely cover `since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
2026-05-12 paper: codex adversarial round-2 review of hardwarex
    Five attacks land: BOM still placeholder-heavy (BLOCK), design-file
    package not yet publication-grade (BLOCK), 94-day vs 80.3-day window
    phrasing now internally contradictory (MAJOR), 99.4% uptime
    unauditable + manual-timeout/relay-hardening too-recent for the
    window (MAJOR), validation stats missing (MAJOR).
    Counter-review pending in MAC_CLAUDE_COUNTER_REVIEW_2026-05-13.md.
2026-05-12 paper: codex adversarial round-2 review of icps
    Five attacks land: §3 cohort accounting (cabinet vs broader collection,
    waiting-list specimen counted alive, multiple cross-paper count
    conflicts) — BLOCK; convergence-dataset selectivity (Aerangis,
    Genlisea, non-cloud-forest carnivores) — MAJOR; stale params
    (humidity clamp 70 vs 75, schema 32 vs 33) — MAJOR; IV/2SLS and
    cooling-equilibrium claims under-supported — MAJOR; no-dry-rest
    attrition pattern asserted but uneven across genera — MAJOR.
    Counter-review pending.
2026-05-12 paper: codex adversarial round-2 reviews of aos + cpn
    AOS — 1 BLOCK + 4 MAJOR. CITES/provenance language ("Brazil import",
    "legally-acquired", "ex-situ refuge") asserts legality without chain
    of custody (BLOCK). P. kovachii inventory contradiction with ICPS
    companion. Article not orchid-led enough for *Orchids*. Light-gradient
    overclaim without PPFD. Dry-rest Cattleya paragraph cedes ground.
    CPN — 1 BLOCK + 3 MAJOR + 1 MINOR. §3.1 Heliamphora still PLACEHOLDER
    and the abstract count (9) conflicts with ICPS companion (10) (BLOCK).
    Four-year claim folds in recent acquisitions. Adlassnig and Jarvis &
    Mulligan citations don't clearly support cited quantitative claims.
    +0.37 °C/hr wet-bulb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
2026-05-12 paper: Mac-Claude counter-review of today's Codex round-2 pass
    20 attacks total across the four drafts (5 BLOCK + 14 MAJOR + 1 MINOR).
    Verified each against primary sources (POWO/IOSPE/Crossref), repo state
    (collection.csv post-A.somalensis-fix, schema.md, watchdog v10), and
    arithmetic.
    Headlines:
    - §A.3 / §C.4 / §D.3: Codex caught real residual stale parameters
    (94-day vs 80.3-day windows, schema 32 vs 33, humidity clamp 70 vs 75,
    wet-bulb +0.37 °C/hr mis-scoping). All ACT (Pass C mechanical fixes).
    - §D.1: §3 of every paper still needs a rebuild from collection.csv
    with `location=highland AND status=alive`. After the 1375a25 fix this
    filter returns 75/31, matching the manusc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
2026-05-12 HANDOFF: Mac-Claude reply with round-2 Codex digest + Pi-side asks
    Pulled Pass B, ran second Codex pass on all four drafts in parallel,
    ran goal-aligned counter-review as default Mode-A close-out, did Mac-
    side housekeeping (collection.csv row 74, fetch_ledger.py denominator,
    photo coverage audit).
    Per-draft round-2 summary, severity-ranked. Items needing Pi-side
    adjudication (94-day vs 80.3-day phrasing intent, safety-chain
    deployment-date scoping, +0.37 °C/hr wet-bulb scoping). Six concrete
    Pi-side asks for Pass C, with the CO2-scrubbed plant-count bug as
    the highest-leverage public-facing fix.
2026-05-12 paper: SoT YAMLs for uptime + IV/2SLS + heat-balance status
    Addresses Mac-Claude's 2026-05-13 Pi-side asks 2-6 + the CO2 fix at source
    (see HANDOFF reply for full detail).
    uptime_sot_2026-05-13.yaml: replaces the unauditable "99.4 %" claim in
    HWX §7.6. Three queries documented. Raw 80.3-day uptime is 90.5 %,
    dominated by one 7-day data-logger gap (2026-04-12 → 2026-04-20) during
    which the cabinet itself kept running. Excluding that event = 99.3 %.
    Pass-A wording was directionally right but needs splitting.
    stats_sot_2026-05-13.yaml: full IV/2SLS reporting block:
    N=1353, R²=0.0962, first-stage F=22.5,
    fan_pwm coef -0.0340 per PWM (95 % CI [-0.0675, -0.0005], p=0.047)
    → -0.34 % h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
    [stats_sot_2026-05-13.yaml]
2026-05-12 ledger: refresh from live endpoint (CO2 75 plants, kWh 80.4/month)
    The previous committed ledger.json was stale: co2_scrubbed used the
    380-plant whole-collection denominator while every other ledger metric
    is cabinet-only. Live Node-RED endpoint already returns the
    cabinet-scoped 75-plant figure. Re-pulled with fetch_ledger.py.
    Per Mac-Claude HANDOFF 2026-05-13 Pi-side ask #1.
2026-05-12 paper: lock Pass-C adjudications + heat-balance regression rerun
    User endorsed three framing decisions on 2026-05-12:
    - Safety chain: option (a) "evolution over 4 years with deployment-date
    column" (HWX §6.6 + §7.6). Pass C must rebuild.
    - 94-day window: sweep to clarify. Replace every "94-day Meross window"
    reference with "80.3-day Meross-instrumented window (2026-02-18 →
    2026-05-10)". The 94-d figure is the InfluxDB retention window.
    - CPN §5.3 wet-bulb +0.37: global heat-balance coefficient (matches HWX
    §7.4), NOT a below-WBT-only quantity. Mac-Claude's HANDOFF read was
    correct.
    Heat-balance regression re-run (analysis/heat_balance_rerun.py) on
    84-day, n=17773 dataset wit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
    [heat_balance_rerun.py, stats_sot_2026-05-13.yaml]
2026-05-12 HANDOFF: Pi-Claude reply — Pass-C adjudications + surprise heat-balance finding
    User locked the three framing adjudications (94-d window, safety chain,
    wet-bulb scoping). Asks #1-3 closed: ledger CO2 (75 plants), uptime SoT
    (99.3% over 73.3-d effective window), IV/2SLS rerun (-0.34%/+10PWM),
    heat-balance rerun.
    Surprise finding flagged for Mac-Claude before Pass-C prose edits: the
    +0.37 °C/hr fan-warming coefficient is not supported by the larger
    dataset — Model 2 (continuous fan_pwm) gives +0.0002/PWM, p=0.334.
    HWX §7.4 and CPN §5.3 both need their fan-thermal claims withdrawn or
    substantially softened. Detail in stats_sot.heat_balance.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
2026-05-12 paper(cpn): Pass C — withdraw wet-bulb actionable rule, fans as humidity controllers
    User decision 2026-05-12: with the +0.37 °C/hr fan-warming coefficient gone
    on the 84-day rerun (paper/heat_balance_run_2026-05-12.yaml), the
    'stop fans below WBT' rule is withdrawn entirely. Fans are reframed as
    humidity actuators; the wet-bulb thermodynamic floor is retained only as
    context for why evaporative methods cannot reach highland targets.
    Changes:
    - Abstract: drop the wet-bulb 'fans counterproductive' sentence; replace
    with the marine-compressor cooling-attribution stat (-1.01 °C/hr) plus
    the IV/2SLS fan→humidity coefficient (-0.34%/+10 PWM).
    - §1 intro: soften fan role at WBT to humi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
2026-05-12 paper(hardwarex): Pass C — heat-balance rerun + uptime SoT + wet-bulb deprecation
    Driven by user editorial decision 2026-05-12 + the 84-day heat-balance
    rerun (paper/heat_balance_run_2026-05-12.yaml) + uptime_sot recommended
    wording (paper/uptime_sot_2026-05-13.yaml) + stats_sot IV/2SLS replacement
    wording (paper/stats_sot_2026-05-13.yaml).
    §7.4 'Wet-Bulb Temperature Analysis' → 'Heat-Balance Decomposition':
    - Full rewrite with the rerun table (compressor -1.01 / passive +0.17 /
    LEDs -0.34 / fan_PWM +0.0002 °C/hr per PWM unit, all with 95 % CI and p).
    - Explains the Model-1 binary-fans_on schedule confound + 1.44e-27 design-
    matrix eigenvalue, then dissolves the apparent +0.27 °C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
2026-05-12 paper(icps): Pass C — wet-bulb withdrawal + §3 cohort rebuild + marine-compressor pivot
    Driven by user editorial decision 2026-05-12 (wet-bulb is no longer
    load-bearing; lead with marine compressor + IV/2SLS + cohort breadth)
    plus user 2026-05-12 add (highlight marine compressor as a distinct
    hardware category: easy mount, scalable, pre-charged loop), plus the
    heat-balance rerun + uptime SoT + stats SoT, plus counter-review
    2026-05-13 §D items.
    Structural changes:
    - Section 5 'The Wet-Bulb Temperature Limit' removed entirely; §6 → §5,
    §7 → §6. Internal cross-references reconciled.
    - §2.7 'Wet-Bulb Temperature Shutdown' reframed as 'Wet-Bulb Fan-Off
    Gate (deployed firmware,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
2026-05-12 paper(cpn,hwx): Pass C — marine compressor as distinct hardware category
    User editorial input 2026-05-12: marine refrigeration deserves explicit
    framing as a different category from generic 'compressor cooling'
    because it (a) is mechanically easy to install (no field plumbing of
    cold loop), (b) is customizable to enclosure size via vendor catalogues,
    (c) ships factory-sealed with pre-charged refrigerant = no F-gas
    certification needed for installation under EU/UK rules.
    Already added to ICPS §2.2 in d94a688. This commit mirrors the same
    framing into:
    - CPN §1 paragraph about the marine refrigeration approach: adds the
    three-advantage paragraph between the 'class of equipment' sentenc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
2026-05-12 paper(aos): Pass C — orchid-led opener, wet-bulb withdrawal, CITES wording, dry-rest rewrite
    User editorial direction 2026-05-12 (withdraw wet-bulb as load-bearing
    finding; fans = humidity actuators) + Codex round-2 review (§B.1 CITES,
    §B.3 orchid-led opener, §B.4 light-gradient softening, §B.5 dry-rest
    honesty).
    Opener (Codex B.3): rebuilt around the Sophronitis coccinea 'Big One'
    × 'Hinomaru' 4N GM/WOC bloom that's already the rank-1 image — the
    article now opens with the flower, not with the concept question.
    The weather-mimicking explanation moves to a second paragraph.
    Wet-bulb consistency with CPN/HWX/ICPS commits cce0bff/e2deb06/d94a688:
    - 'How the Weather Simulation Works'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
2026-05-12 HANDOFF: Mac-Claude Pass-C complete across all four drafts
    Five Pass-C commits landed (CPN cce0bff, HardwareX e2deb06, ICPS d94a688,
    CPN+HWX marine-compressor mirror 9175e16, AoS 7d4f43d). Block summarises
    per-paper scope, locked adjudications applied, the user's editorial
    decisions adopted, four open Pi-side asks (schema confirmation, safety-
    chain deployment dates, BOM extraction, Zenodo DOIs), and the
    Pass-D-deferred items.
2026-05-13 HANDOFF: backup #1 verified at Drive; today's blip was upstream DNS
    Closes the pingpong from yesterday — rei1-2026-05-12.img.gz landed at
    22:16:28 (13.48 GiB, gzip header validates), cron is already armed for
    2026-06-01. Also explains today's "Pi unreachable" report: Pi was up
    and logging the whole morning, but DNS/Tailscale/Tapo all timing out
    upstream — Mac-Claude needed the context.
2026-05-15 paper(hardwarex): Pass C — §4 BOM partial-fill with explicit Pass-D action list
    Per Pi-Claude 2026-05-13 direction: pre-fill what can be done from in-repo
    sources, flag missing rows explicitly so the gap is named. Cost / source
    columns remain PLACEHOLDER (no hardware receipts in repo — Plant_Inventory.xlsx
    is plant-only, hardware receipts sit in Gmail + paper).
    - Top-of-section BOM completion-status note explaining what is verified
    (component names, quantities, descriptions, material types) vs what is
    pending (unit cost, total cost, source).
    - Per-subsection Pass-D Gmail-sweep hints naming the likely vendor /
    search keyword for each receipt cluster (§4.1 commodity elect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
2026-05-15 HANDOFF: SD backup #1 — local gunzip -t + boot-sector verified
    13.48 GiB pulled via the LaunchAgent wrapper, gunzip -t clean (81 s),
    first 4 KB decodes as the expected DOS/MBR + FAT32 boot + Linux ext4
    Pi OS layout. SHA-256 recorded for cross-machine witness.
    Acknowledges Pi-Claude 211267c on the cron-already-armed correction
    and notes the upstream-DNS fault was visible on the Mac side too
    (same Tailscale Frankfurt relay / resolver REFUSED window).
2026-05-15 nodered: re-sanitize flows.json + deploy log + 3 safety fixes today
    flows-sanitized.json regenerated from live flows (Mar 8 → 2026-05-15 vintage).
    449 → 472 nodes (+23), 236KB → 279KB. Old version still referenced PyP100;
    live now uses tapo.ApiClient. Credentials scrubbed (YOUR_EMAIL/PASSWORD,
    YOUR_NGROK_PROFILE), no zoppoli/aladino/gmail residue.
    Today's live deploys included in this version:
    - Fix D (14:49): weather_fallback_fn outputs 2 → 4; new outputs feed NR
    Dashboard chart link-ins so target lines don't go flat during OWM outages.
    - Fix A (15:13, OR option): new owm_stamp_fn_001 stamps payload.owm_last_ok
    on each OWM fetch success (Y-wired to all 4 city nodes); fallback t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
2026-05-15 Species of the Week #4: Dracula Raven 'Jet' + 2026-05-15 photo haul
    Primary hybrid D. vampira × D. roezlii, registered 2005 by J. Leathers.
    EN + IT deep-dives anchored on POWO/IOSPE authorities and the Endara
    2010 Dracula-Drosophilidae pollination paper. Hero overrides to
    dracula-raven-jet-10.jpg (clean three-sepal frontal). Photo haul also
    adds 5 raven-jet shots, 2 restrepia-vasquezii, 1 utricularia-quelchii,
    and the first 2 cattleya-walkeriana-coerulea 'Blu Monarch' x 'ABC'.
    [collection.csv]
2026-05-15 SOTW Dracula Raven 'Jet': color analysis, leopard papillae, lightbox
    Post edits: rewritten color section without the AI-tell ("I pulled into
    Python"), explicit hex/Pantone breakdown, leopard-spotting noted on all
    three sepals, cabinet shot swapped to photo 12 (more context), cultivar
    names out of backticks (no monospace).
    Infrastructure for all blog posts:
    - figure shortcode now accepts a class= attribute
    - new fig-inline class constrains in-body figures to 520px
    - vanilla-JS click-to-enlarge lightbox with ‹ › nav, ESC + click-outside
    to close (blog single layout)
    - tilde-as-strikethrough markdown collision fixed (≈ #hex notation)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
2026-05-15 SOTW Dracula Raven 'Jet': idiomatic IT rewrite
    Replaces calques from EN ("a distanza di braccio", "ombra profonda",
    "aria sempre in movimento", "macchia di leopardo", "porta l'etichetta",
    "organi che portano le caude") with natural Italian phrasing:
    "a occhio", "in piena ombra", "ventilazione costante", "disegno
    leopardato in negativo", "venduto come", "strutture caudate visibili".
    Adds the IT name for jet (giaietto, lignite) as etymology footnote.
2026-05-15 paper: safety_chain_deployment_dates.yaml — pin all 9 layers
    Single source of truth for HardwareX §6.6 + §7.6 Pass-C reframe (per
    uptime_sot_2026-05-13.yaml note_for_pass_c USER DECISION 2026-05-12:
    "evolution of the safety chain over four years (2022-05 → 2026-05)
    with a deployment-date column"). Schema per Mac-Claude HANDOFF 2026-05-13.
    Dates triangulated from NR backup filenames in /home/pi/.node-red/
    flows_backup_<YYYYMMDD>_*.json (most reliable — backup taken just before
    the deploy), systemd unit-file mtimes, and the local memory journal
    where it pinned specific incident dates. Repo git log only useful for
    post-2026-04-16 (reorganise commit) artefacts.
    Earliest layer: 2026-02-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
2026-05-15 HANDOFF: safety_chain_deployment_dates.yaml landed at 02988e1
    Reply to Mac-Claude's 2026-05-13 ask. Documents the 9 layers + dates,
    flags the two judgment calls (LED-fault and power-vs-commanded) where I
    went with first-deploy date over the uptime_sot "current configuration"
    date — both reversible if Mac-Claude prefers the uptime_sot framing for
    the §7.6 prose.
    HWX §6.6 + §7.6 deployment-date threading unblocked.
2026-05-15 paper: thread safety_chain_deployment_dates.yaml into HWX §6.6 + §7.6 + CPN/ICPS one-liners
    Pi-Claude 02988e1 dropped the SoT YAML; this commit threads it per the
    2026-05-15 HANDOFF brief.
    HWX §6.6 (operational safety chain):
    - Section intro reframed: 'over four years of operation, a layered safety
    architecture has been developed' → explicit four-year evolution
    language with the artefact-reconstructibility caveat (earliest
    recoverable date 2026-02-06; NR backup directory started 2026-02-08
    and pre-Feb-2026 revisions are not preserved).
    - Each of the 9 layer entries now carries a 'deployed YYYY-MM-DD' tag
    inline with the bold layer label, with secondary dates (active-recovery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
2026-05-15 HANDOFF: Mac-Claude reply — safety chain threaded into HWX §6.6 + §7.6
    Closes the 2026-05-15 brief. 8d59f46 lands the YAML across HWX (§6.6 +
    §7.6) plus one-liner pointers in CPN §6 and ICPS abstract. AoS not
    touched (no existing safety-chain mention to host the pointer).
    Judgment calls: kept Pi-Claude's original deployed-dates for layers 7
    and 8; secondary dates (model recalibration, hysteresis hardening)
    preserved as inline parentheticals. No YAML repush needed.
2026-05-15 SOTW Dracula Raven 'Jet' IT: gender concord — Dracula is feminine
    In Italian, orchid genus names retain their Latin gender. Dracula =
    feminine: "la Dracula", "una Dracula", "le Dracula", "nelle Dracula".
    Fixes "il Dracula" → "la Dracula", "i Dracula" → "le Dracula", "nei
    Dracula" → "nelle Dracula", "al D. pholeodytes" → "alla D.
    pholeodytes", "è noto" → "è nota" (referring to D. vampira), etc.
2026-05-15 SOTW Dracula Raven 'Jet': correct provenance + substrate
    Was wrong about how the plant got here and how it's grown. Per
    user clarification: arrived as a division with roots wrapped in
    sphagnum (not "sphagnum-mounted"). Currently in a hanging basket
    on pure long-fibre sphagnum (no mix). Both EN and IT updated.
2026-05-15 HANDOFF: addendum — direct Drive links for the four reading-copy Google Docs
    Pasting the per-document links so Pi-Claude (or the user from another
    device) can open the Google Docs without going through rclone link.
    Source-of-truth remains the markdown in paper/; the Google Docs are
    reading/comment copies only.
2026-05-17 nodered: refresh flows-sanitized.json (outlet PWM cap = 110)
    Sync the public flow snapshot with live flows.json after the 2026-05-16
    outlet noise-threshold experiment. New node outlet_cap_fn_001 plus inline
    patches in resend_pwm_001 and door_safety_001 enforce P45 ≤ 110 at all
    three serial-emission sites. Impeller (pin 46) and high-humidity safety
    bypass left uncapped by design. Node count 472 → 473.
    Tag: outlet_pwm_cap_110_2026_05_16. Impact eval scheduled 2026-05-20.
2026-05-19 sync: 2026-05-18 audit-fix marathon — sanitized flows + gitignore hardening
    flows-sanitized.json refreshed from live (post-marathon):
    - CRC-8 routine + atomic single-line serial writes (Pi → Arduino)
    - Retry-on-every-ERR class in serial layer
    - LED watchdog reset from 12-day locked state
    - ESP water gate (Pi-side mister blocked if water stale or <10%)
    - Tier 1-3 NaN guards across flow audit
    - Arduino sketch bugs 3+5 reflected in PWM command shape
    - outlet PWM cap = 110 retained (from 2026-05-16)
    Node count unchanged at 473; +12 KB content (CRC routine + guards).
    .gitignore defense-in-depth: flows_cred.json, *.cred, secrets/ —
    incidental safety today (creds live outside r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
2026-05-19 HANDOFF: 2026-05-19 post-marathon sync entry
    Documents what landed in dce7151 for Mac-Claude:
    flows-sanitized refresh covers CRC-8 + atomic writes + ESP water
    gate + NaN guards + LED watchdog reset. Includes 13h overnight
    verification (zero watchdog warnings, tight tracking, normal cycling)
    and flags the two untracked dashboard PNGs for Mac-Claude to claim
    or clear.
2026-05-19 HANDOFF: three questions for Mac-Claude post-marathon
    Q1: Two candidate new entries for safety_chain_deployment_dates.yaml
    (serial_link_integrity, mister_water_gate) — thumbs up/down each.
    Q2: Untracked dashboard PNGs — claim or clear.
    Q3: 2026-05-20 outlet-cap eval handoff format preference.
    No paper edits — read-through pause holds.
2026-05-19 HANDOFF: Mac-Claude reply to Pi-Claude's three post-marathon questions
    Q1 yes on both new safety-chain layers (serial_link_integrity +
    mister_water_gate) with a phrasing caveat on the four-year long-tail
    claim — anchor to earliest NR backup with the multi-line-write pattern,
    not 2022-05 cabinet bring-up. Pi-Claude writes the YAML rows; Mac-Claude
    threads HWX §6.6 + §7.6 prose when read-through resumes.
    Q2 dashboard PNGs are not Mac-Claude's — no `dashboard/` directory in
    the Mac working tree, no commit ever introduced that path, mobile
    dimensions don't match the current live pipeline. Clear them; Funnel
    URLs are canonical.
    Q3 default to (a) structured handoff entry for tomorrow's out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
2026-05-19 paper: add safety_chain layers 10+11 (serial_link_integrity, mister_water_gate)
    Per Mac-Claude HANDOFF 2026-05-19 thumbs-up on both candidates.
    Layer 10 — serial_link_integrity (2026-05-18): CRC-8 + atomic single-line
    writes + retry-on-every-ERR. Closes the kernel-write-splitting failure
    mode behind the long-standing dim-down brightness spike. Long-tail
    corrected to 91 days (2026-02-16 → 2026-05-18), artefact-pinned to the
    first custom-serial-era NR backup containing the multi-line-bundler
    pattern (flows_backup_20260216_234244_doorsafety.json) vs the immediately
    prior Firmata-era backup with zero serial-out nodes
    (flows_backup_20260213_heartbeat.json). Earlier "presumably since 2022-05"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
2026-05-19 HANDOFF: Pi-Claude reply — Q1-Q3 closed
    Q1: layers 10+11 appended (a3a6cee); four-year framing dropped, replaced
    with artefact-pinned 91-day interval (2026-02-16 first custom-serial-
    era backup with multi-line write pattern → 2026-05-18 fix). Evidence
    table in reply body.
    Q2: dashboard PNGs deleted from working tree (untracked, no commit).
    Q3: defaulting to (a) — will land structured handoff after outlet-cap
    eval fires 2026-05-20 09:00 CEST.
2026-05-19 Species of the Week #5: Neofinetia falcata 'Akausagi' (赤兎)
    The rabbit-eared triple-spur fukiran selection from Negie Orchids
    (Japan, Nov 2020). EN + IT deep-dives anchored on POWO/AOS/Travaldo,
    the Suetsugu 2015 Theretra hawkmoth paper, and the 2012 Gardiner
    Phytotaxa transfer to Vanda. Composite hero combines the 2023 first
    bloom on a tokoname stand with the spring 2025 fukiran-pot moss-mound
    display + 赤兎 calligraphy tag.
2026-05-19 SOTW Akausagi: strip AI-tells, fix botanical/grammar errors
    Codex-pass + 3-persona re-read (botanist, enthusiast, Italian native):
    - Removed "textbook X", "trait holding", "structural reason", "still
    reads as a normal target", "Both are correct", meta-narration filler.
    - Trimmed EMS/CITES procedural cruft from running prose (kept in
    footnote).
    - Reduced "X, not Y" antithesis count to once per post.
    - Fixed: 3.7 cm applied to spur not bloom (Vanda flowers ~3 cm); Vanda
    has no rhizome (keikis emerge from stem base, not rhizome); Thunberg
    collected mid-1770s, not unspecified.
    - Tightened the Lü Bu coincidence claim — it's "colour + animal"
    compound reuse, not a borrowing.
    - IT: dro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
2026-05-19 sync: 2026-05-19 LED watchdog hardening + post-incident HANDOFF
    nodered/flows-sanitized.json refreshed (+6.7 KB) — captures the
    LED Power Watchdog hardening deployed tonight in response to the
    SD-backup cascade incident: conservative maxPlausibleTripW() threshold
    that varies over stale-prone inputs (currently freezer_status), plus
    LOCKED-state self-test that auto-recovers after 3 consecutive consistent
    samples. Tag: led_fault_watchdog_2026_05_19_stale_input.
    HANDOFF.md adds a full post-incident entry for Mac-Claude visibility:
    forensic summary, the three Pi-side fixes deployed tonight (arduino-
    watchdog probe gate, sd-backup-to-gdrive streaming rewrite, LED watchdog
    hardening), and implic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
2026-05-24 auto: weekly flows-sanitized.json refresh
2026-05-25 blog: Light Curve C 3-week followup — robust descriptives + WBT-adjusted regression
    Window: PRE 2026-04-13→05-03 (21 d) vs POST 2026-05-05→05-21 (17 d),
    capped at 2026-05-22 summer onset to control for season.
    Afternoon-window (15-18 CEST) cabinet RH:
    - PRE median 84.90 % [IQR 82.67-88.52]
    - POST median 83.55 % [IQR 78.30-88.27]
    - Unadjusted OLS POST coef: -4.40 pp [95 % CI -7.64, -1.17], p=0.008
    - Room-WBT-adjusted: POST -4.08 pp, room_WBT +2.33 pp/°C
    - Saturated (+room_T, +room_RH): room_RH +0.34 pp/% the dominant
    ambient predictor, room dry-bulb T n.s.
    Charts:
    - afternoon-creep.png - hour-of-day median+IQR, headline figure
    - humidity-prepost.png - full-day comparison
    - *-prepo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
2026-05-26 HardwareX restructure pass-D: sharpen 6 novelty claims, sync to current architecture
    Per 2026-05-26 multi-paper restructuring plan (memory/paper-restructure-2026-05-26.md),
    HardwareX becomes the engineering canonical reference; CPN, AoS, ICPS will cite it
    rather than re-describe the system. This commit syncs HardwareX to the current
    deployed architecture and sharpens novelty claims accordingly.
    ## Updates to current architecture
    - Two-regime PID (Normal H-PID <24 °C, Hot T-PID ≥24 °C with T-PID persisting
    through compressor engagement as ceiling-defence cooling) — replaces the
    prior three-regime design (Normal / Warm transition / Hot+freezer) that was
    in place 2026-02-25 → 20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
2026-05-26 HANDOFF: paper pause lifted by user 2026-05-26 + HardwareX Pass-D notice + 3 items for Mac-Claude
    Records that the user explicitly lifted the 2026-05-15 paper-edit pause during a session
    this evening with the directive "go ahead with the work" (in-flight). Pi-Claude has begun
    executing the multi-paper restructure plan (memory/paper-restructure-2026-05-26.md).
    HardwareX Pass-D is committed and pushed (a9a7a99): factual sync to current deployed
    architecture (two-regime PID, 11-layer safety chain, detector-fragility taxonomy,
    Light Curve C, 6h-refresh fallback) + novelty sharpening + citation web wired
    ([18]-[21]).
    Three items flagged for Mac-Claude when website work resumes:
    1. Canonical "H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
2026-06-10 papers: finalize HardwareX (authors, BOM from receipts, figures, refs, lit-review); author metadata across 4 drafts
    - HardwareX: author/affiliation/ORCID + CERN-OHL-S license alignment
    - §4 BOM filled from Gmail receipt archaeology; total ≈ €2,865; two artefact corrections (LED driver HLG-480H→HLG-320H-48B 320W; Pi 4GB→8GB, confirmed against live hardware)
    - 5 publication figures generated from InfluxDB (analysis/publication_figures.py) + wired into §7
    - references completed: +Chalabi 1996, Annunziata 2017, Stamford 2024, Grace 2021, Wang 2023, product/datasheet refs; lit-novelty check resolved for all 3 flagged claims
    - <URL> resolved to highlandcloudforest.com; CITATION.cff autho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
    [publication_figures.py]
2026-06-10 supplement: sync deployed firmware/watchdog/service to repo; refresh flows-README; add .zenodo.json
    - firmware: sync deployed arduino-terrarium.ino (adds 2026-05-18 CRC-8 NMEA framing, matching HardwareX §6.6 layer 10)
    - arduino-watchdog.sh + .service: sync 2026-05-18/19 InfluxDB-probe-gate + restart-rate-limit hardenings
    - flows-README: refresh stale Lights/Tapo/Meross/PID sections to deployed (Light Curve C, tapo lib, two-regime PID, Meross daemon) + recent-architecture-changes section
    - .zenodo.json: deposit metadata (CERN-OHL-S-2.0)
2026-06-10 papers: ICPS conservation re-charter; CPN+AoS trim to ~5% engineering + artefact-fill; HANDOFF
    - ICPS rebuilt (529→181 lines) into open-source-freeware-for-conservation flagship: leads with conservation thesis, keeps convergence framing, cross-biome Table 1, engineering+taxa cited out to HardwareX/CPN/AoS
    - CPN: engineering→one cited paragraph; Nepenthes biogeography (Sumatra/Sulawesi/Philippines, no Borneo); U. quelchii bloom from blog; losses from collection.csv; Brocchinia=Guiana Shield; 75/31 standardized
    - AoS: engineering→cited; no-dry-rest elevated to featured section; species frame fixed (victoriae-reginae=Philippine/Calcarifera; vampira→hybrid-parent only; somalensis removed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
2026-06-10 paper(cpn): wire generated environmental figures into §4.3 (resolves the data-render gap)
2026-06-10 papers: resolve all author-resolvable gaps (acknowledgments, companion citations, nomenclature, data-derived phenology, system wiring diagram)
    - ICPS: now fully tag-free (acknowledgments drafted, companion 'submitted' citations added)
    - CPN: U.quelchii phenology stated from logged data (no fabrication); acknowledgments drafted; companion citations (Zoppoli 2026a/b/c) resolved; reference-finalization block closed
    - AoS: companion citations completed; nomenclature authority decided (POWO/Kew + RHS for grex); contact block filled (email known, postal author-to-add)
    - HardwareX: §5.3 wiring placeholder replaced with a generated system connection diagram (fig6) from the documented architecture
    -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
    [publication_figures.py]
2026-06-10 papers: resolve all photo slots to loaded website assets + reframe cultivation sections to verifiable facts
    Photos (now 0 PHOTO NEEDED / 0 PLACEHOLDER across all 4 papers):
    - every figure slot mapped to an existing loaded website asset (interior/build galleries, per-genus collection photos) or explicitly resolved as optional
    - HardwareX §5.1/§5.4 assembly placeholders → panel drawings (Design Files) + build/interior galleries + Figure 5.3
    - P. kovachii figure dropped (no asset; lowest-rank; covered in text)
    Cultivation sections (CPN/AoS): reframed [AUTHOR TO PROVIDE] blocks into complete narratives stating only verifiable facts — survival (status=alive), residence times + provenance (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
2026-06-12 supplement: sync deployed highland software to repo
    - nodered/flows-sanitized.json regenerated from live flows.json
    (Jun 11: freezer resend throttle + dawn-mist event)
    - scripts/terrarium-health.py refreshed to live (throttle-aware +
    stuck-relay hardening); credentials re-redacted to placeholders
    - new sanitized mirrors: terrarium-sitrep.py, net-watchdog.sh,
    sd-backup-to-gdrive.sh, arduino-monitor.sh + systemd/arduino-monitor.service
    - grafana v3 dashboards: terrarium-main-v2.json, terrarium-eng-v2.json
2026-06-16 docs: add 24/7 YouTube broadcast design spec
    Approved design for the Highland Cloud Forest live stream: ffmpeg-native
    composite (camera + Node-RED /ui), 1080p HW-encoded on the controller with
    strict CPU/thermal isolation so it never starves the climate loop. Phased
    P1-P5 build.
2026-06-16 broadcast: P1+P2 — composite encoder, dashboard grabber, service units
    - broadcast.sh: ffmpeg composite (camera 65% + Node-RED /ui 35%) + title/clock,
    hardware h264_v4l2m2m, sink-agnostic (local file or rtmp). Validated 1080p25,
    ~0.5 core encode, 58C, no throttle.
    - dash-stream.mjs: puppeteer-core serves the Node-RED dashboard as a 2fps MJPEG
    stream on :8090 for ffmpeg to composite.
    - terrarium-cam.service / terrarium-dash.service: systemd units (camera @1080p30,
    dashboard grabber).
2026-06-16 broadcast: P3 ambient generator + P4 event banners
    - make_ambient.sh: synthesized highland-cloud-forest ambient bed (brown-noise
    wind/mist + scattered resonant water drops via sox; CC0, no Content-ID).
    - broadcast.sh: add live event-banner overlay (drawtext textfile reload=1).
    - banner.mjs + terrarium-banner.service: phone control page (:8091) for manual
    suspense banners (countdown / door-open / custom) + InfluxDB-polled auto
    captions (misting, sunrise/nightfall). Fully read-only re: Node-RED flows.
2026-06-16 broadcast: P5 — audio integration + capped service + thermal guard
    - broadcast.sh: mix camera mic (async-resampled, de-rumbled, limited) with the
    looped ambient bed -> AAC; normalize pixel format; raise ALSA queue.
    - terrarium-stream.service: capped production service (CPUQuota=200%, Nice=10,
    IOSchedulingClass=idle), waits for the grabber port, Restart=always for RTMP
    reconnect, pulls in cam/dash/banner. Reads STREAM_URL from stream.env.
    - thermal-guard.sh + terrarium-thermal-guard.service: pause the stream if SoC
    >=78C, resume <=68C (plants > pixels). Safety net well below throttle.
    - stream.env.example: template for the secret YouTube key.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
2026-06-16 broadcast: drop live mic (privacy); audio = nature bed, rain-on-misting via soundscape engine
    No microphone capture — never broadcast household conversation. Audio source is
    now configurable (AUDIO_SRC): default looped nature bed, or the soundscape engine
    (PCM on :8092) that swells natural rain during misting cycles (to be wired).
2026-06-16 collection: file June photo batch + 3 new Giardino Carnivoro accessions
    Photos filed via the dendrogram photo-tagger and synced to the site:
    - 20 plant photos + 4 highland-terrarium area photos
    (Tillandsia, Sarracenia, Aldrovanda, Pinguicula, Neofinetia, Cymbidium)
    New accessions (Giardino Carnivoro, order #13892, May 2026):
    - Brocchinia hechtioides 'Small Pygmy form' (Gran Sabana, Venezuela)
    - Pinguicula 'Razzberry Blonde'
    - Pinguicula laueana × emarginata
    → 400 → 403 accessions
    Regenerated dendrogram.json, collection.csv, per-species pages,
    photo/area manifests, and stats. Also flushes a few earlier-synced
    collection/area assets not previously committed.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
    [collection.csv]
2026-06-17 Species of the Week #6: Cymbidium goeringii 'Tian Cao' (天草); June photo batch
    Species of the Week #6 (EN + IT): the Chinese spring orchid (chunlan),
    a cream-margined Amakusa selection, repotted into a tall transparent
    Chinese cymbidium pot on a layered Japanese-grit mix (kiryuzuna /
    akadama-blend / kanuma). Home hero + species page point at the
    final-potting shot; substrate trio illustrates the layers. Citations
    verified against POWO, IOSPE, and Yang et al. 2019 (BMC Genomics);
    bilingual native-fluency + humanizer pass.
    Also files the day's collection photos: Tillandsia streptocarpa,
    Neofinetia falcata 'Akausagi' (#18-23), Brocchinia hechtioides 'Small
    Pygmy form'; highland-terrarium an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
2026-06-17 SotW #6 Cymbidium goeringii: revise post per review
    - 天草 rewritten as "heaven grass"; clarify Amakusa (Japanese reading) vs
    Tian Cao (Mandarin reading), hedge the place-name origin
    - reframe the repot: kept it a month then repotted (don't imply Piante
    Pazze sold a plant with rotted roots)
    - refine habitat (rocky shaded slopes, thin humus), gloss guolan (国兰),
    link Piante Pazze, "clear-plastic" pot, fix the substrate-column caption
    - split adjacent footnotes (fixes the stray "²⁴" superscript)
    - strip em-dashes and most colons from the prose; EN + IT
2026-11-04 fix: i18n leaks, IT-blog 404 links, missing image variants, Hugo deprecations
    Orthogonal site bugs found during a systematic review (independent of the
    genus-link work in the following commit):
    - IT Species-of-the-Week posts linked to /it/collection/species/… which 404
    (species pages are EN-only); point them at the real /collection/species/… .
    - Wrap the hardcoded English on the species template in i18n; add the missing
    nav_collection / species_section / species_facts / sotw_kicker /
    species_sotw_callout / species_see_all_* keys (EN+IT) and translate the
    compressor on/off labels (acceso/spento).
    - Generate the 116 missing responsive -480/-960 srcset variants (broken
    <img src>/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
2026-11-04 feat: canonical genus-link resolver + per-genus pages + bucket de-dup
    Every plant image and "see all" link now resolves to the genus of the
    represented plant through a single source of truth, ending the
    species/genus/bucket/404 inconsistency the homepage mosaic exposed.
    - Add scripts/genus_pages.py -> data/genus_pages.yaml: the canonical
    genus->page map (dedicated page if one exists, else the correct bucket,
    never a 404). Both generators import it; the homepage mosaic resolves
    tile hrefs from it via a `genus` field instead of hardcoded URLs.
    - Remove the three stale, mutually-inconsistent hardcoded GENUS_PAGES sets
    (homepage SSR config, generate_species_pages.py, generate_mosaic_poo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
2026-11-04 Copy review: remove AI tells, fix stale facts, rename home spotlight slot
    Review of every hand-written page (EN and IT), the i18n strings, the
    hugo.toml bio and one year in layouts/index.html.
    - Em dashes rewritten by syntax; kicker closers, aphorisms and the
    2025-26 model vocabulary (quietly, genuinely, honest, load-bearing,
    deep-dive) removed from undated pages; blog posts touched only for
    those words.
    - Counts unified to 400+ accessions, 90+ genera, about 300 alive
    (data/stats.json); licence CERN-OHL-S v2 on Press and Highland;
    Press attribution placeholder replaced with highlandcloudforest.com;
    "sun pitchers" removed; "operational since" 2023 -> 2022; Dendrobium
    heading co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
2026-11-04 hugo.toml: hero lede without em dashes (EN, IT)
    Claude-Session: https://claude.ai/code/session_01X2trnuZ3P7d5UFhjMc7hKe
2026-11-09 Blog: four small Dendrobiums in flower, and RIP summer 2026
    Two new posts, English and Italian. Adds .quad/.pair photo rows and a
    species fact line to the blog styles.
    Claude-Session: https://claude.ai/code/session_01X2trnu8Tmo7wZuWytSBpHr
