GabrieleZoppoli/terrarium-control-system/(notices)

Notices in the files:
paper/icps-paper.md:
We summarize here only what is needed to make the conservation argument, and cite the companion for everything quantitative.
- **CITES and legal compliance.** Cloud-forest floras include CITES-listed taxa (the cabinet holds *Phragmipedium kovachii*, Appendix I, acquired under standard licensed-dealer paperwork for artificially-propagated specimens).
paper/MAC_CLAUDE_COUNTER_REVIEW_2026-05-13.md:
State that explicitly: "acquired November 2022 from Ecuagenera (Ecuador) under the standard licensed-dealer CITES paperwork for artificially-propagated *Phrag.
t evaporative cooling; below WBT, the same fans produce a net warming approaching the +0.37 deg C/hr sensible-heat injection rate" — or even cleaner, cite the HardwareX-style linear-fade model directly.
This is a Pi-side calc bug. Surface to Pi-Claude. (None of the four manuscripts cite the CO2 number, so it's not a paper-Pass-C item, but it's a homepage-credibility item.)
§3 L87 lists `paper/energy_sot_*.yaml` as a CERN-OHL-P-2.0 Design File.
